loongOpen/OpenLoong-Hardware/QingLoong V2.5/en/QingLoong V2.5 - Electrical Drawings and Open Source Content Introduction/zh-Electrical Drawings.pdf

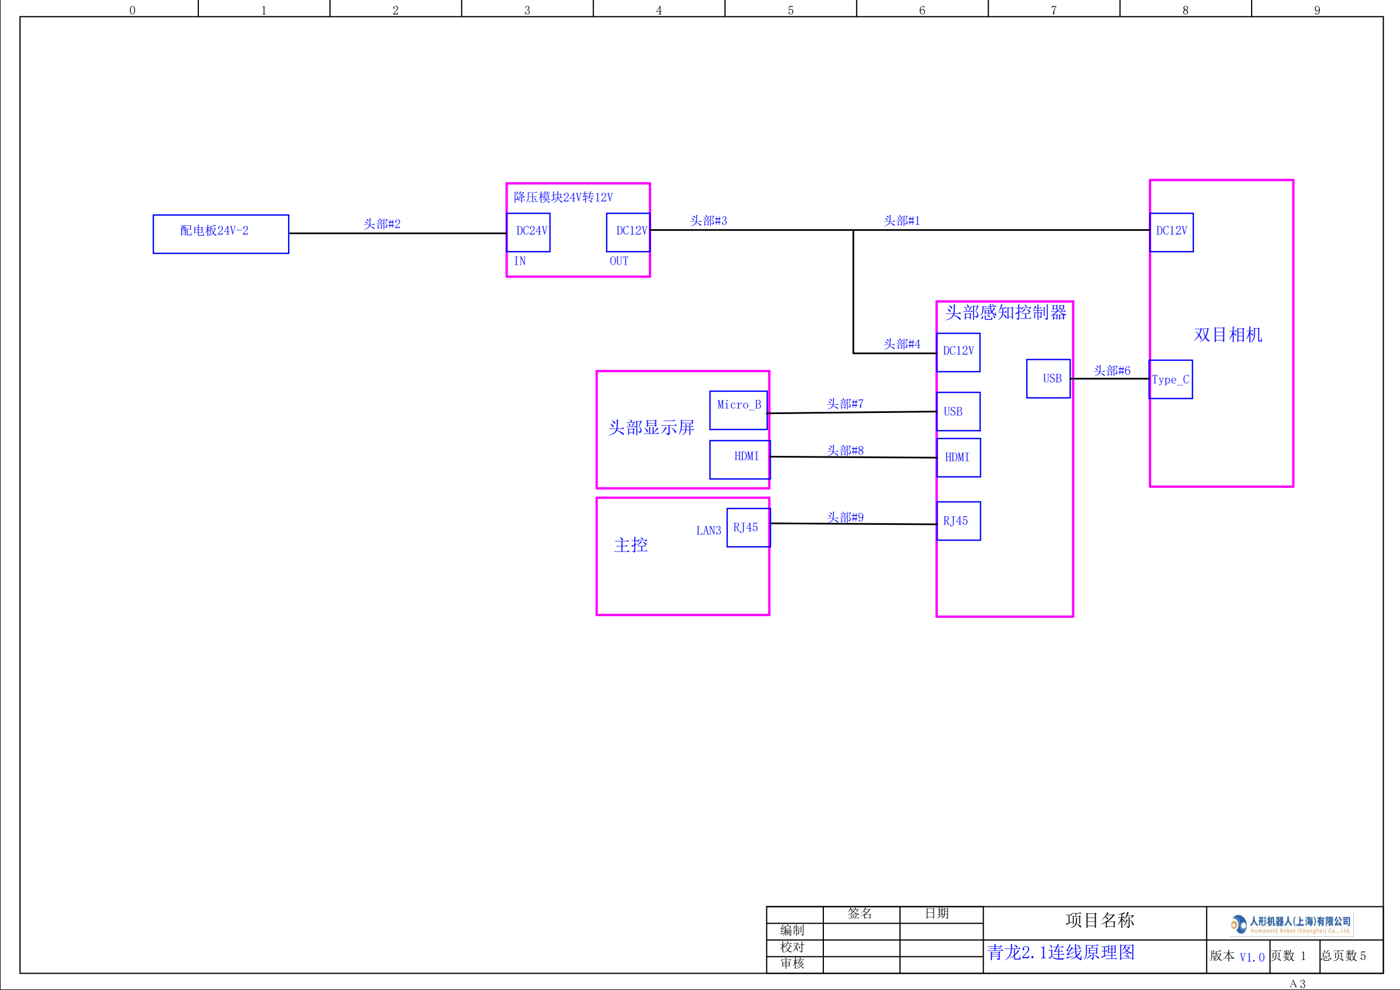
[picture p1: figure]
项目名称; 青龙2.1连线原理图; 总页数 5 审核; 降压模块24V转12V; OUT; 双目相机; 头部感知控制器; USB; HDMI; 头部显示屏; Micro_B; Type_C; 配电板24V-2; RJ45 LAN3

电池

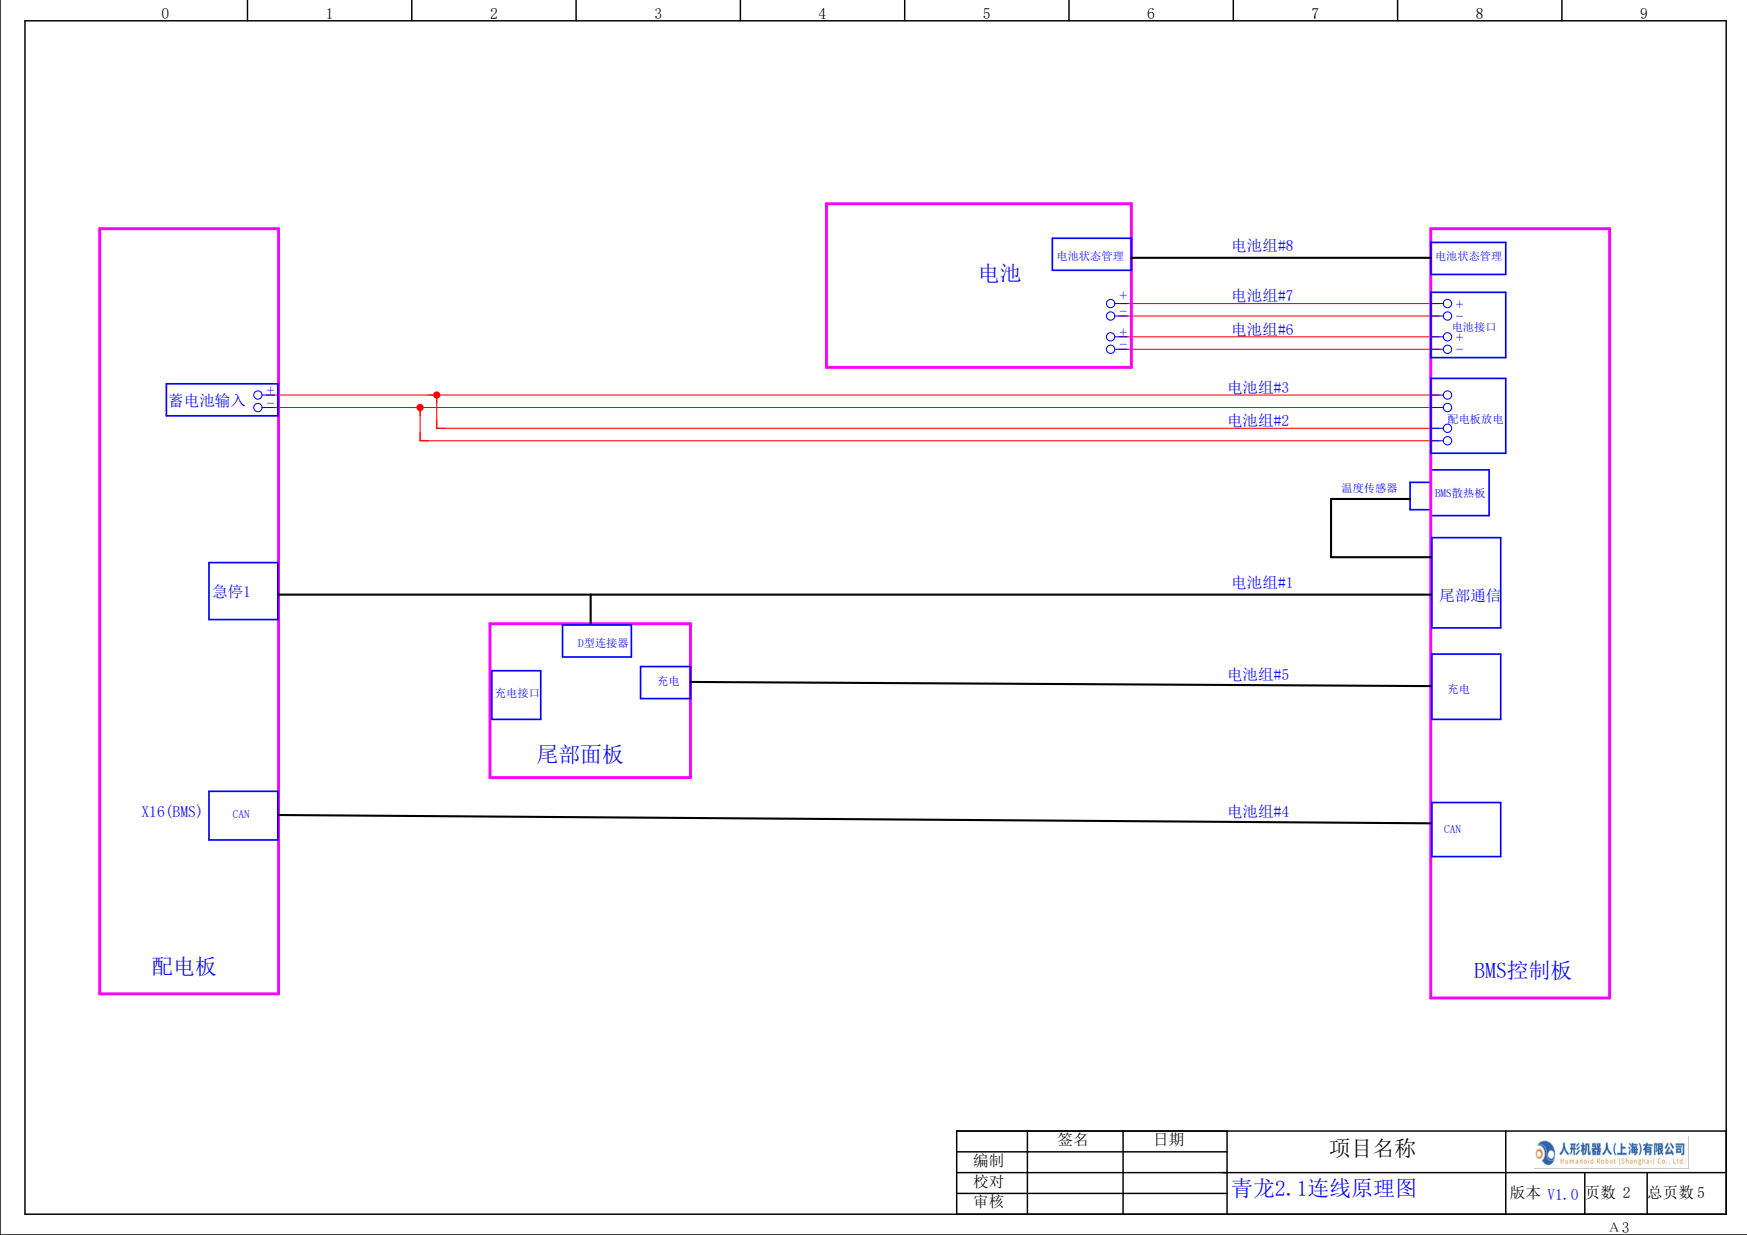
[picture p2: page 2]
配电板; + 蓄电池输入; X16(BMS); 尾部面板; 温度传感器; BMS散热板; D型连接器; BMS控制板; 尾部通信; CAN; 充电接口; 青龙2.1连线原理图; 电池接口; 电池状态管理; 配电板放电; 电池组#8; 电池组#7; 电池组#6; 电池组#5; 电池组#4; 电池组#3; 电池组#2; 电池组#1

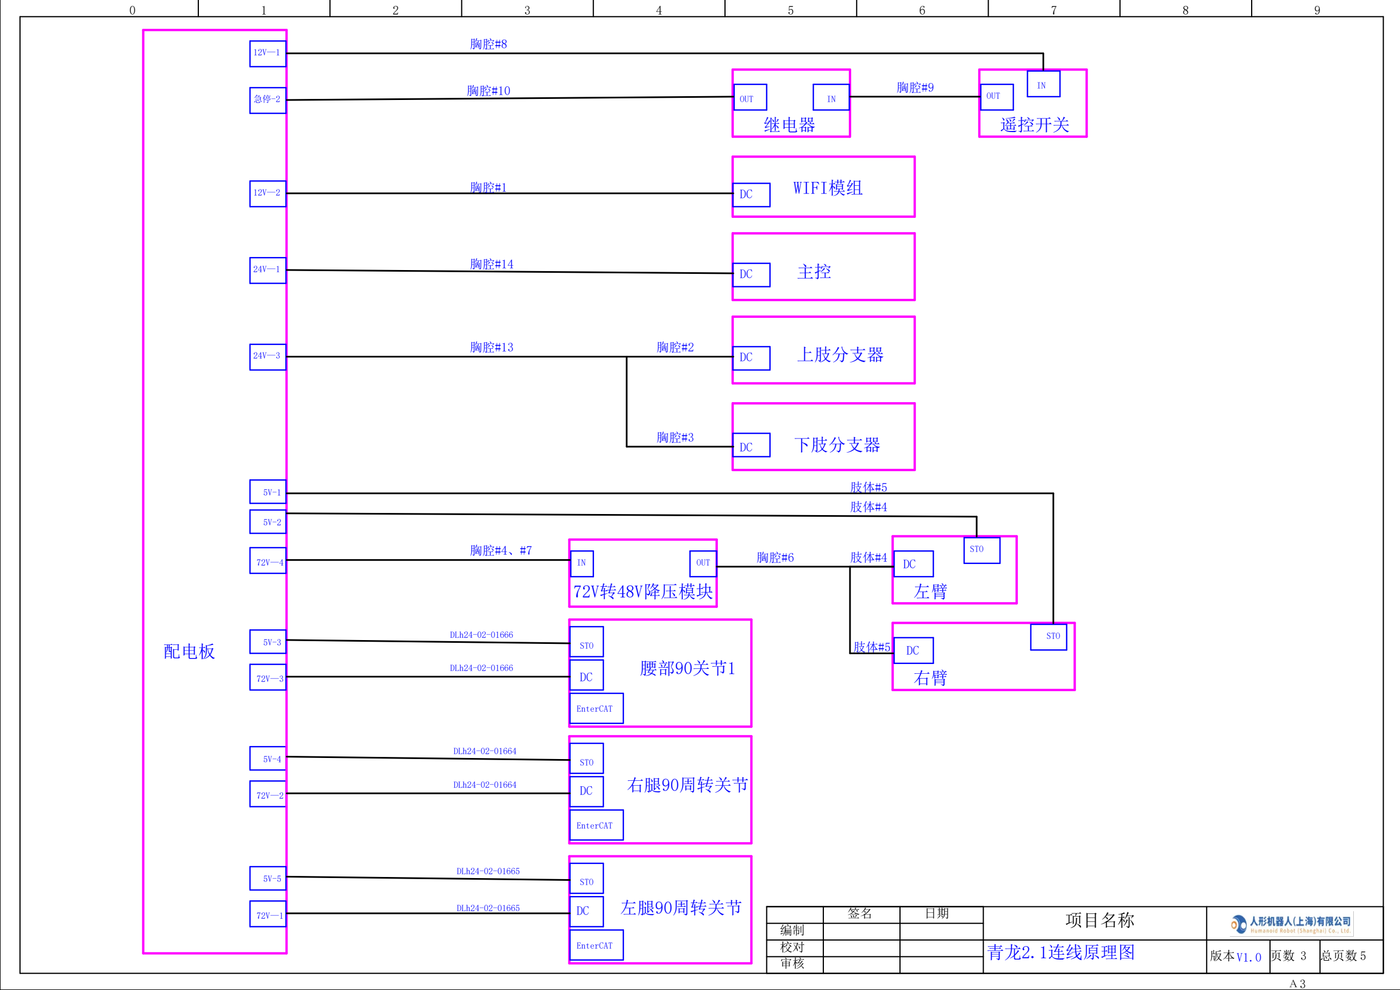
[picture p3: figure]
72V转48V降压模块; STO; 右腿90周转关节; 左腿90周转关节; OUT; EnterCAT; DLh24-02-01665; 配电板; STO 5V-3; STO 5V-5; WIFI模组; 上肢分支器; 下肢分支器; 继电器; 遥控开关; DLh24-02-01664; DLh24-02-01666

青龙2.1连线原理图 | 版本

主控

LAN1 RJ45

RJ45

RJ45

LAN8/网口2

LAN6/网口1

下肢分支器 | 上肢分支器
RJ45 | RJ45 | RJ45 | RJ45 | RJ45 | RJ45 | RJ45

## 左腿90周转关节

RJ45

## 右腿90周转关节

RJ45 | RJ45
左臂 | 右臂
LAN2 | RJ45
LAN3 | RJ45
X2 | X3 | X1 | X2 | X4 | X3

RJ45

## 腰部90关节1

RJ45

X6

RJ45

RJ45

RJ45

## 头部感知控制器

## 调试口

## WIFI模组

OUT

## 左腿90周转关节

## 左腿120侧展关节

DLh24-02-04004

## 左腿120前摆关节

DLh24-02-04003 | DLh24-02-04002
左腿120膝关节 | 左腿踝关节1

## 左腿踝关节2

DLh24-03-04131

DLh24-03-04131

DLh24-02-04004 | DLh24-02-04003 | DLh24-02-04002 | DLh24-03-03422

DLh24-03-03422

IN | OUT | IN | OUT | IN | OUT

IN

IN

## 右腿90周转关节

右腿120侧展关节 | 右腿120前摆关节 | 右腿120膝关节 | 右腿踝关节1

## 右腿踝关节2

OUT | OUT | OUT | OUT

IN

IN

IN | IN | IN
DLh24-02-04006 | DLh24-02-04005 | DLh24-02-01661

DLh24-02-01661

OUT | OUT | OUT

IN

IN

IN IN

## 腰部90关节1

腰部90关节2 | 腰部90关节3

## 头部70关节1

## 头部70关节2
