loongOpen/OpenLoong-Hardware/TA00-12-00-腿足系统-三维图纸/TA00-12-00-0003连杆销针C.step

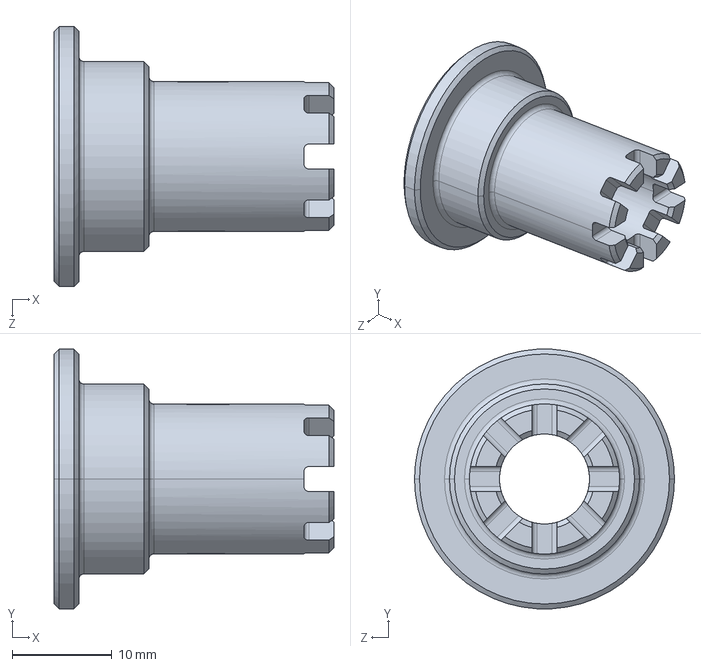
[picture p22: CAD file, 2025-07-11]
TA00-12-00-腿足系统-三维图纸/TA00-12-00-0003连杆销针C.step
28.0 x 26.0 x 26.0 mm
