loongOpen/OpenLoong-Hardware/TA00-12-00-腿足系统-三维图纸/TA00-12-06-0004足底端盖.step

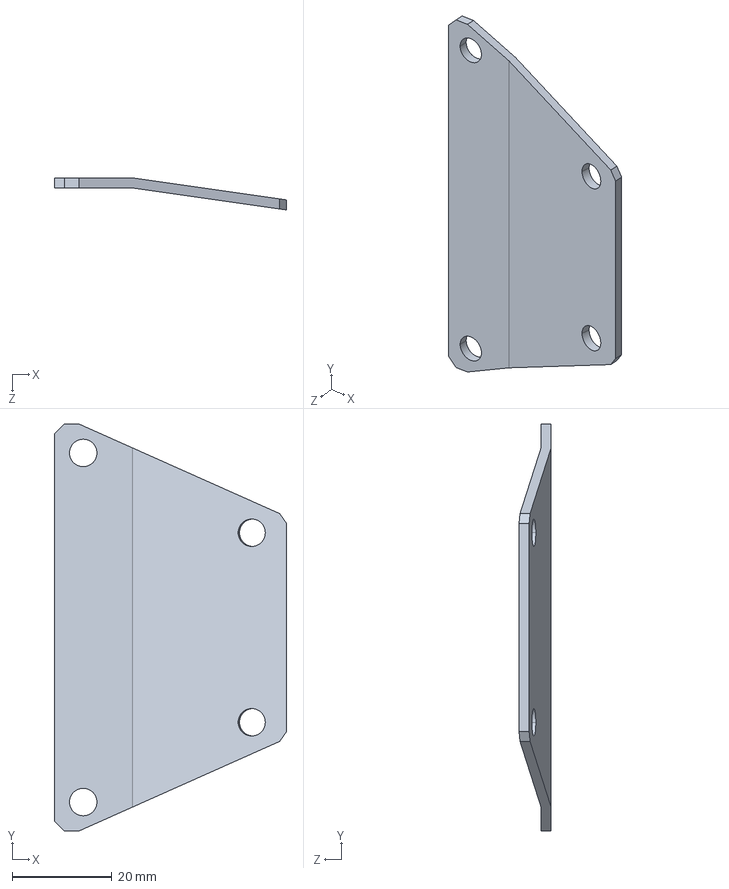
[picture p23: CAD file, 2025-07-11]
TA00-12-00-腿足系统-三维图纸/TA00-12-06-0004足底端盖.step
46.6 x 81.6 x 6.42 mm
