loongOpen/OpenLoong-Hardware/TA00-12-00-腿足系统-三维图纸/TA00-12-06-0003足底前橡胶垫.step

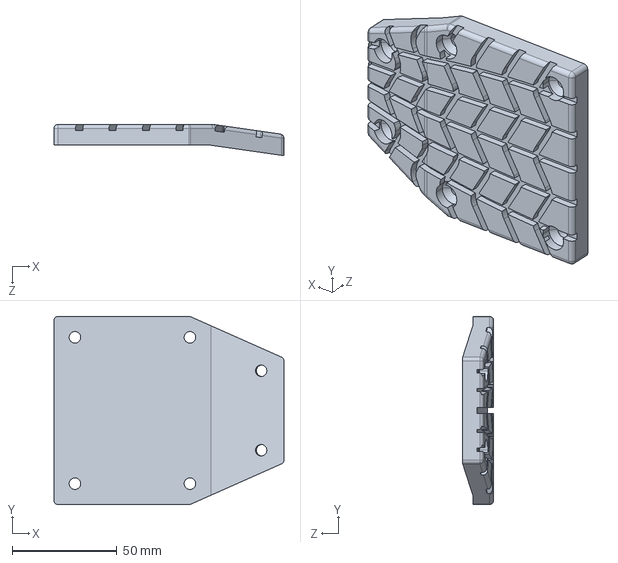
[picture p24: CAD file, 2025-07-11]
TA00-12-00-腿足系统-三维图纸/TA00-12-06-0003足底前橡胶垫.step
110.0 x 90.0 x 15.0 mm
