loongOpen/OpenLoong-Hardware/TA00-12-00-腿足系统-三维图纸/TA00-12-02-0007摇臂.step

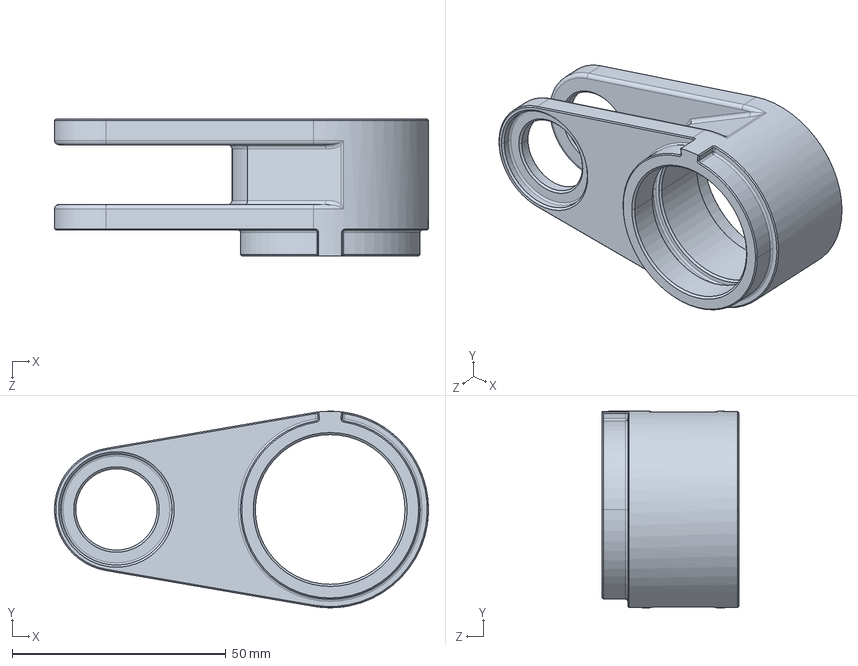
[picture p25: CAD file, 2025-07-11]
TA00-12-00-腿足系统-三维图纸/TA00-12-02-0007摇臂.step
87.5 x 46.0 x 32.0 mm
