loongOpen/OpenLoong-Hardware/TA00-12-00-腿足系统-三维图纸/TA00-12-02-0003右大腿支架.step

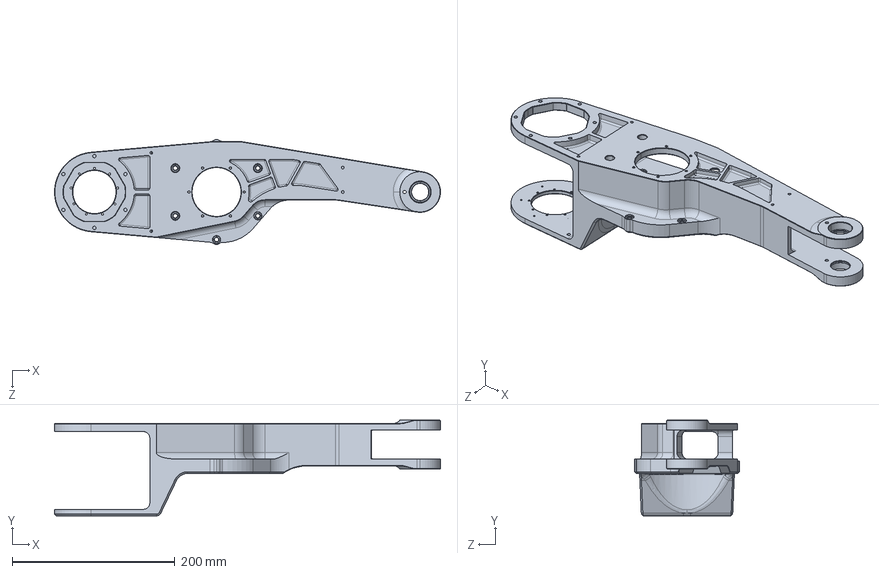
[picture p26: CAD file, 2025-07-11]
TA00-12-00-腿足系统-三维图纸/TA00-12-02-0003右大腿支架.step
474.0 x 117.5 x 129.0 mm
