loongOpen/OpenLoong-Hardware/TA00-12-00-腿足系统-三维图纸/TA00-12-04-0004小腿拉杆C.step

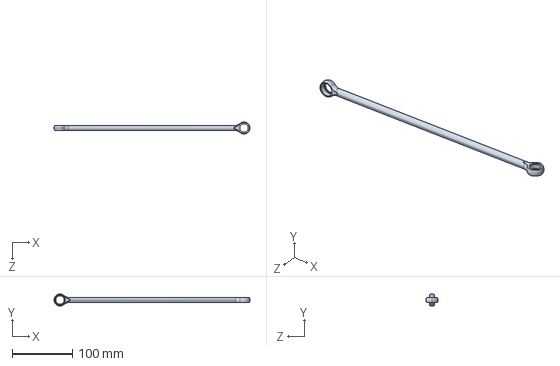
[picture p27: CAD file, 2025-07-11]
TA00-12-00-腿足系统-三维图纸/TA00-12-04-0004小腿拉杆C.step
325.0 x 20.0 x 20.0 mm
