loongOpen/OpenLoong-Hardware/TA00-12-00-腿足系统-三维图纸/TA00-12-02-0002俯仰电机支撑架.step

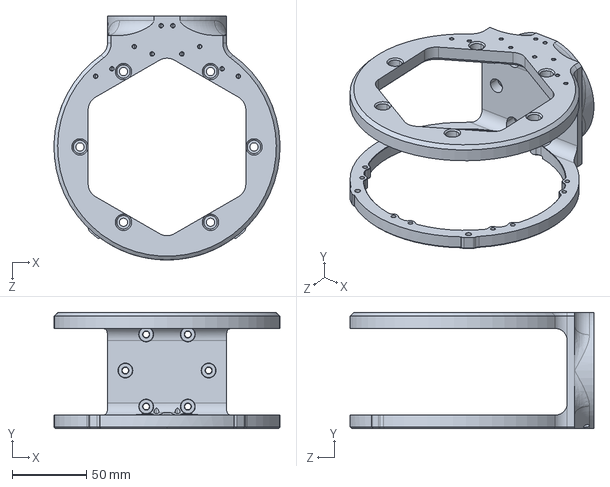
[picture p28: CAD file, 2025-07-11]
TA00-12-00-腿足系统-三维图纸/TA00-12-02-0002俯仰电机支撑架.step
151.9 x 78.0 x 164.0 mm
