loongOpen/OpenLoong-Hardware/TA00-12-00-腿足系统-三维图纸/TA00-12-02-0010连杆.step

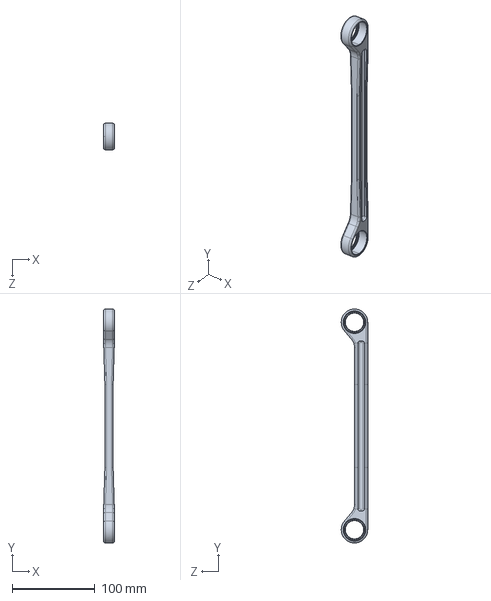
[picture p29: CAD file, 2025-07-11]
TA00-12-00-腿足系统-三维图纸/TA00-12-02-0010连杆.step
13.0 x 282.0 x 32.0 mm
