loongOpen/OpenLoong-Hardware/TA00-12-00-腿足系统-三维图纸/TA00-12-00-0001膝关节销轴.step

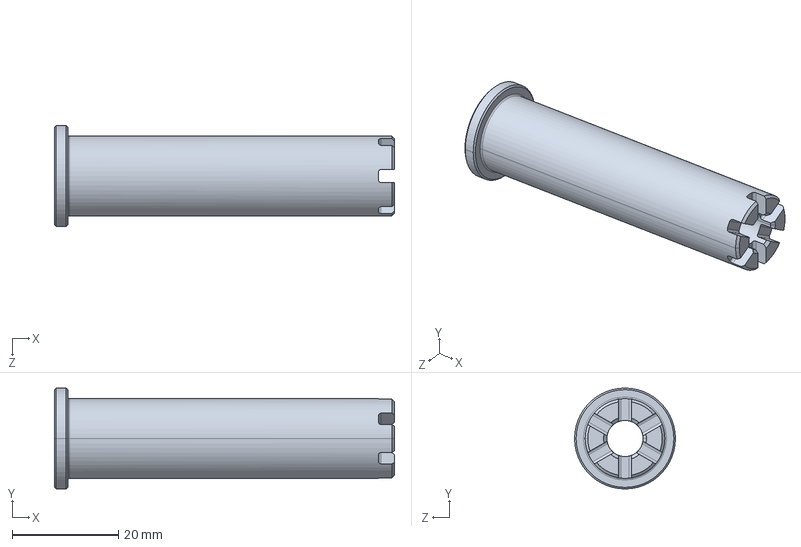
[picture p30: CAD file, 2025-07-11]
TA00-12-00-腿足系统-三维图纸/TA00-12-00-0001膝关节销轴.step
64.0 x 19.0 x 19.0 mm
