loongOpen/OpenLoong-Hardware/TA00-12-00-腿足系统-三维图纸/TA00-12-00-0018膝关节轴承垫片.step

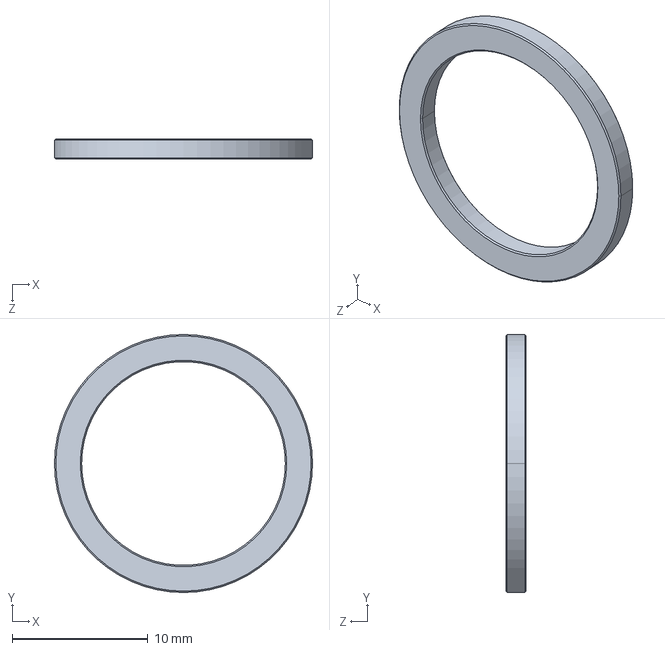
[picture p31: CAD file, 2025-07-11]
TA00-12-00-腿足系统-三维图纸/TA00-12-00-0018膝关节轴承垫片.step
19.0 x 19.0 x 1.50 mm
