loongOpen/OpenLoong-Hardware/TA00-12-00-腿足系统-三维图纸/TA00-12-04-0001右小腿支架.step

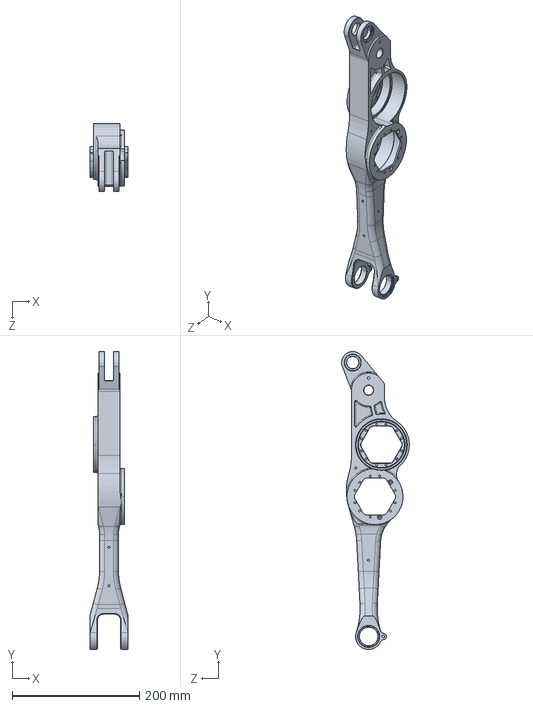
[picture p32: CAD file, 2025-07-11]
TA00-12-00-腿足系统-三维图纸/TA00-12-04-0001右小腿支架.step
60.5 x 468.3 x 106.5 mm
