loongOpen/OpenLoong-Hardware/TA00-12-00-腿足系统-三维图纸/TA00-12-02-0006轴承钢套.step

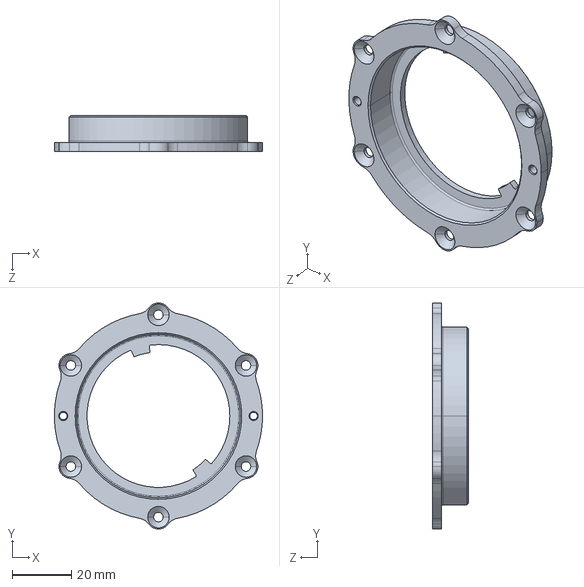
[picture p33: CAD file, 2025-07-11]
TA00-12-00-腿足系统-三维图纸/TA00-12-02-0006轴承钢套.step
70.0 x 76.0 x 12.0 mm
