loongOpen/OpenLoong-Hardware/TA00-12-00-腿足系统-三维图纸/TA00-12-06-0001足本体.step

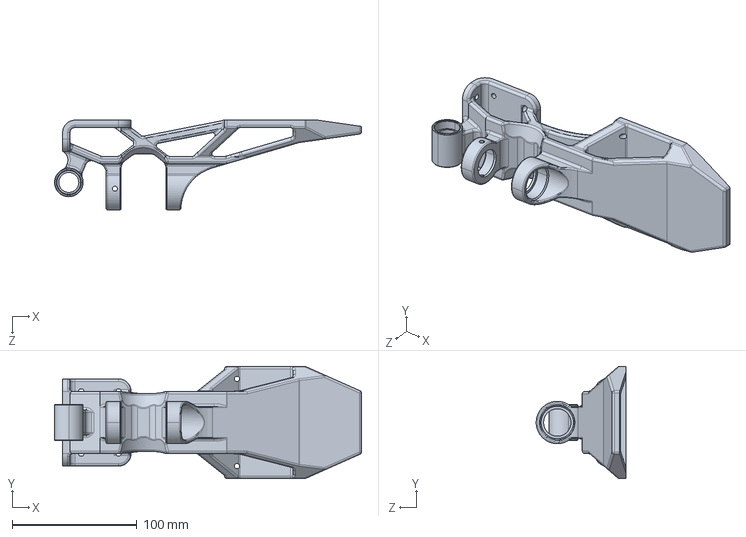
[picture p34: CAD file, 2025-07-11]
TA00-12-00-腿足系统-三维图纸/TA00-12-06-0001足本体.step
246.5 x 90.0 x 72.0 mm
