loongOpen/OpenLoong-Hardware/TA00-12-00-腿足系统-三维图纸/TA00-12-02-0005轴承锁紧螺母.step

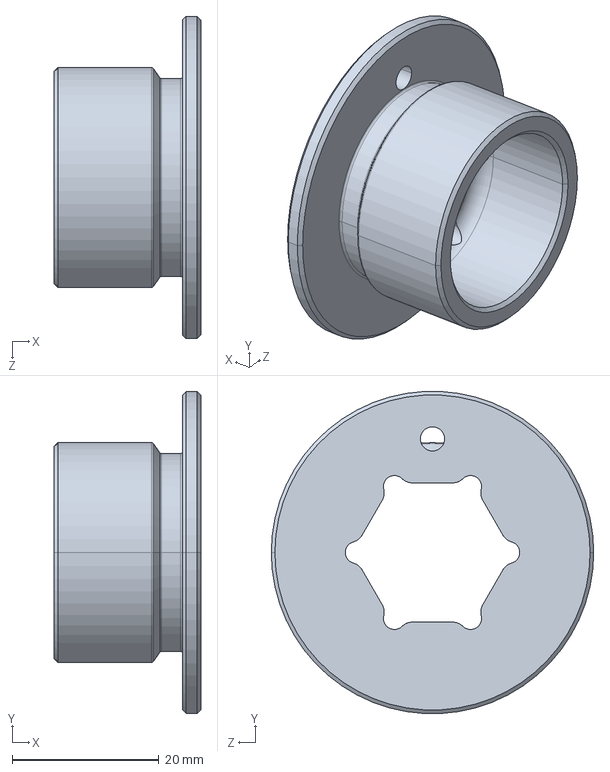
[picture p35: CAD file, 2025-07-11]
TA00-12-00-腿足系统-三维图纸/TA00-12-02-0005轴承锁紧螺母.step
20.0 x 43.9 x 44.0 mm
