loongOpen/OpenLoong-Hardware/TA00-12-00-腿足系统-三维图纸/TA00-12-02-0009连杆锁紧螺钉B.step

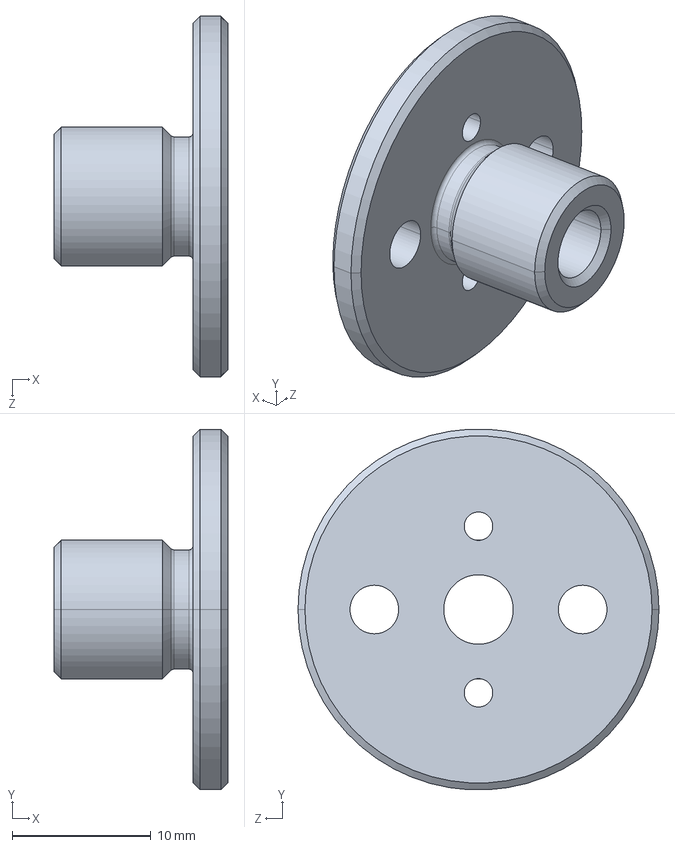
[picture p36: CAD file, 2025-07-11]
TA00-12-00-腿足系统-三维图纸/TA00-12-02-0009连杆锁紧螺钉B.step
12.5 x 26.0 x 26.0 mm
