loongOpen/OpenLoong-Hardware/TA00-12-00-腿足系统-三维图纸/TA00-12-04-0006右小腿上限位.step

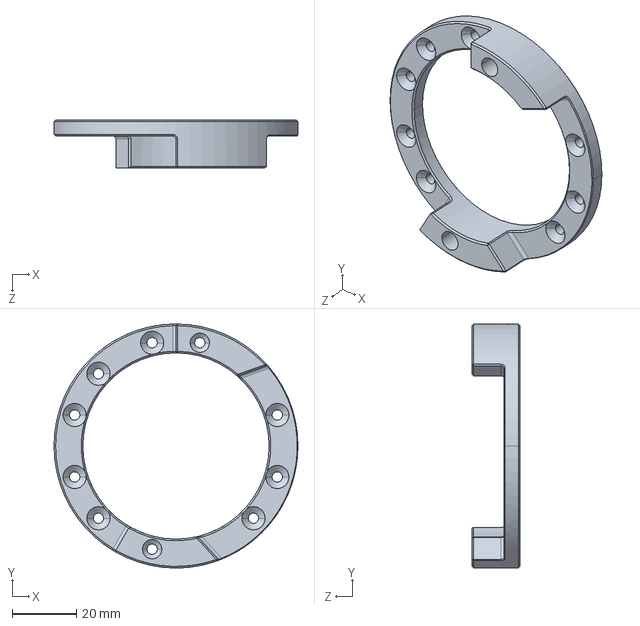
[picture p37: CAD file, 2025-07-11]
TA00-12-00-腿足系统-三维图纸/TA00-12-04-0006右小腿上限位.step
76.0 x 76.0 x 15.0 mm
