loongOpen/OpenLoong-Hardware/TA00-12-00-腿足系统-三维图纸/TA00-12-00-0007脚踝俯仰轴 B.step

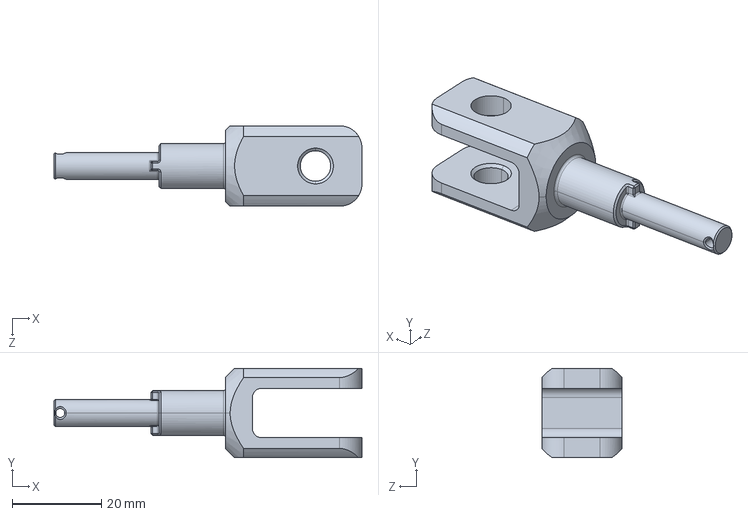
[picture p38: CAD file, 2025-07-11]
TA00-12-00-腿足系统-三维图纸/TA00-12-00-0007脚踝俯仰轴 B.step
68.9 x 20.0 x 18.0 mm
