loongOpen/OpenLoong-Hardware/TA00-12-00-腿足系统-三维图纸/TA00-12-00-0015十字侧摆轴衬套.step

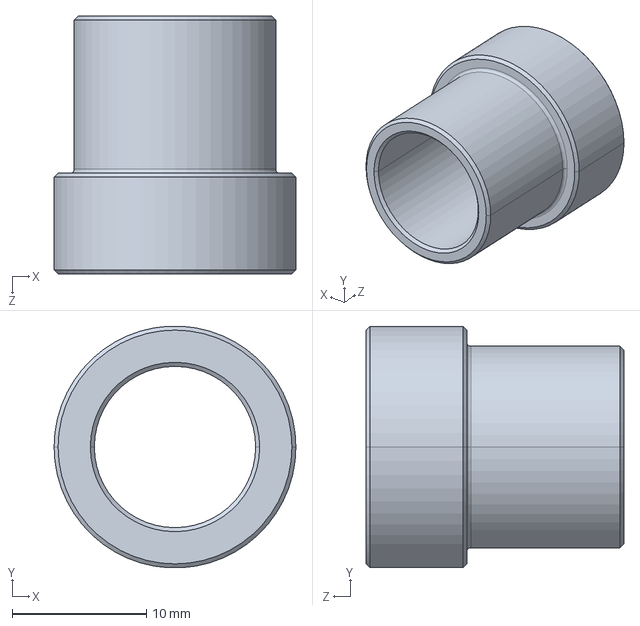
[picture p39: CAD file, 2025-07-11]
TA00-12-00-腿足系统-三维图纸/TA00-12-00-0015十字侧摆轴衬套.step
18.0 x 18.0 x 19.2 mm
