loongOpen/OpenLoong-Hardware/TA00-12-00-腿足系统-三维图纸/TA00-12-00-0017十字俯仰轴关节衬套.step

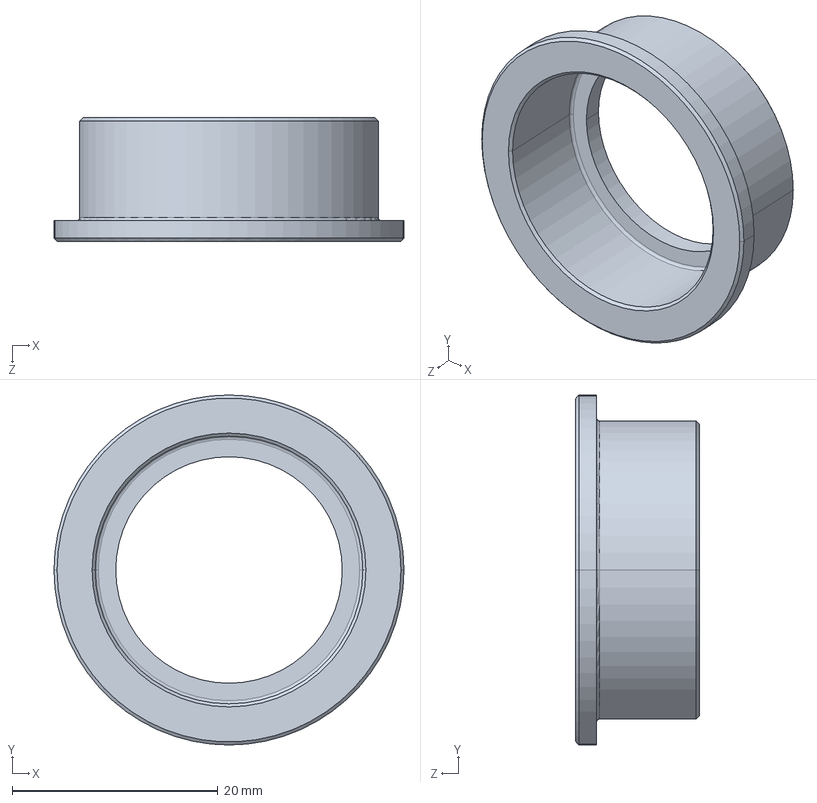
[picture p40: CAD file, 2025-07-11]
TA00-12-00-腿足系统-三维图纸/TA00-12-00-0017十字俯仰轴关节衬套.step
34.0 x 34.0 x 12.0 mm
