loongOpen/OpenLoong-Hardware/TA00-12-00-腿足系统-三维图纸/TA00-12-02-0015髋关节俯仰限位块.step

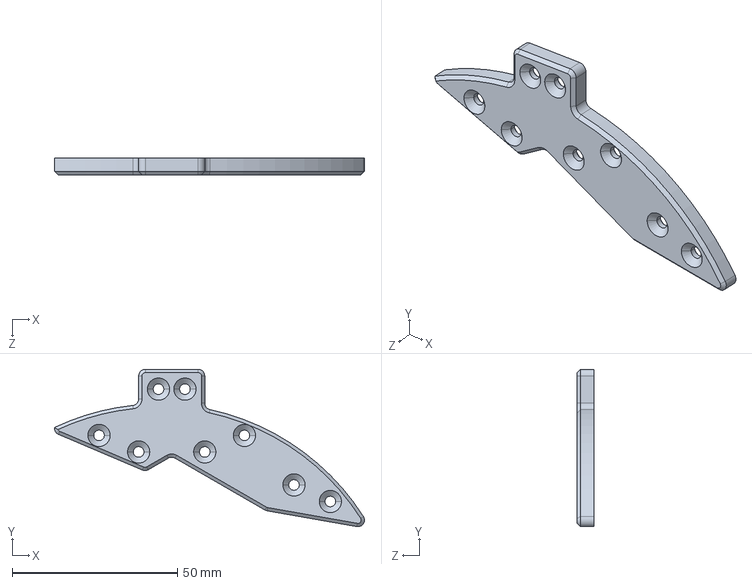
[picture p41: CAD file, 2025-07-11]
TA00-12-00-腿足系统-三维图纸/TA00-12-02-0015髋关节俯仰限位块.step
93.8 x 47.6 x 5.00 mm
