loongOpen/OpenLoong-Hardware/TA00-12-00-腿足系统-三维图纸/TA00-12-00-0013十字俯仰轴.step

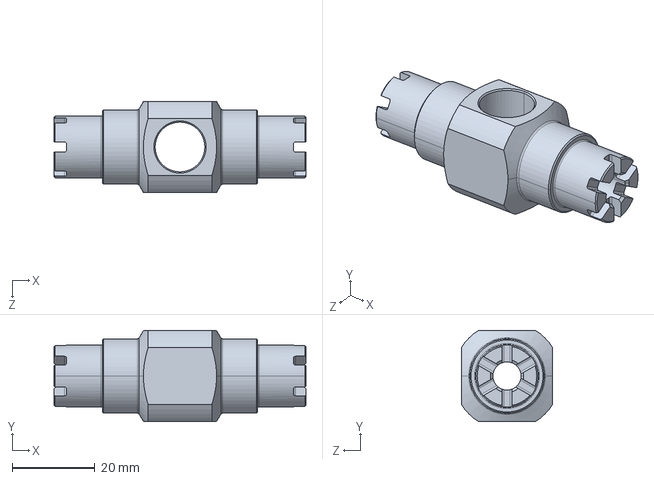
[picture p42: CAD file, 2025-07-11]
TA00-12-00-腿足系统-三维图纸/TA00-12-00-0013十字俯仰轴.step
60.9 x 22.0 x 22.0 mm
