loongOpen/OpenLoong-Hardware/TA00-12-00-腿足系统-三维图纸/TA00-12-04-0002-A1小腿曲柄.step

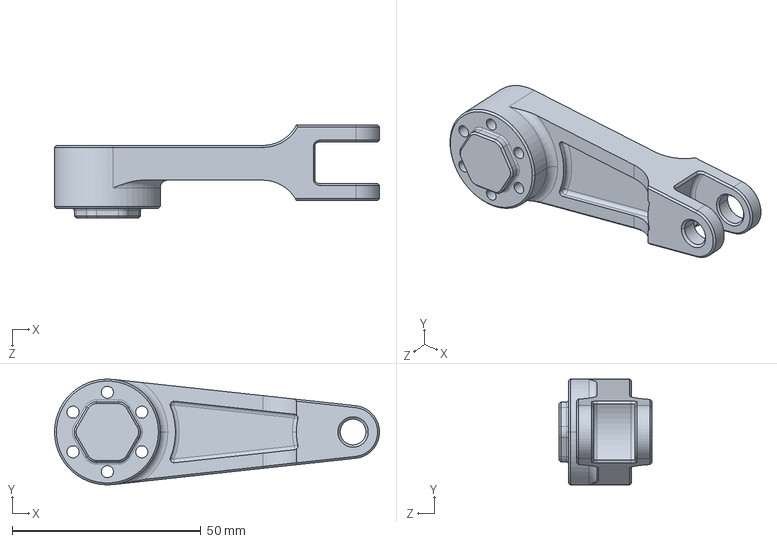
[picture p43: CAD file, 2025-07-11]
TA00-12-00-腿足系统-三维图纸/TA00-12-04-0002-A1小腿曲柄.step
86.0 x 28.0 x 24.6 mm
