loongOpen/OpenLoong-Hardware/TA00-12-00-腿足系统-三维图纸/TA00-12-00-0014十字侧摆轴.step

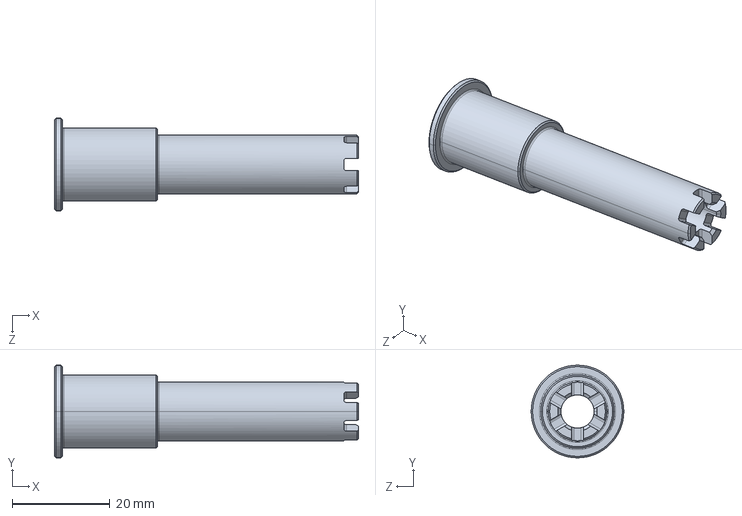
[picture p44: CAD file, 2025-07-11]
TA00-12-00-腿足系统-三维图纸/TA00-12-00-0014十字侧摆轴.step
62.3 x 19.0 x 19.0 mm
