loongOpen/OpenLoong-Hardware/TA00-12-00-腿足系统-三维图纸/TA00-12-00-0002膝关节销轴锁紧螺钉.step

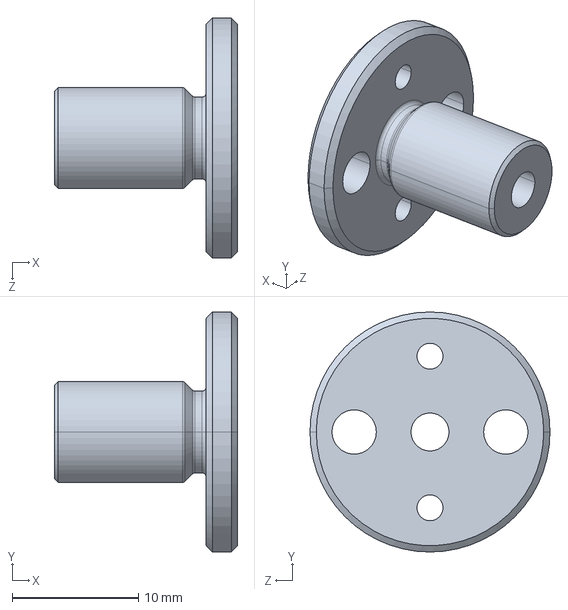
[picture p45: CAD file, 2025-07-11]
TA00-12-00-腿足系统-三维图纸/TA00-12-00-0002膝关节销轴锁紧螺钉.step
14.5 x 19.0 x 19.0 mm
