loongOpen/OpenLoong-Hardware/TA00-12-00-腿足系统-三维图纸/TA00-12-00-0016踝关节锁紧螺钉.step

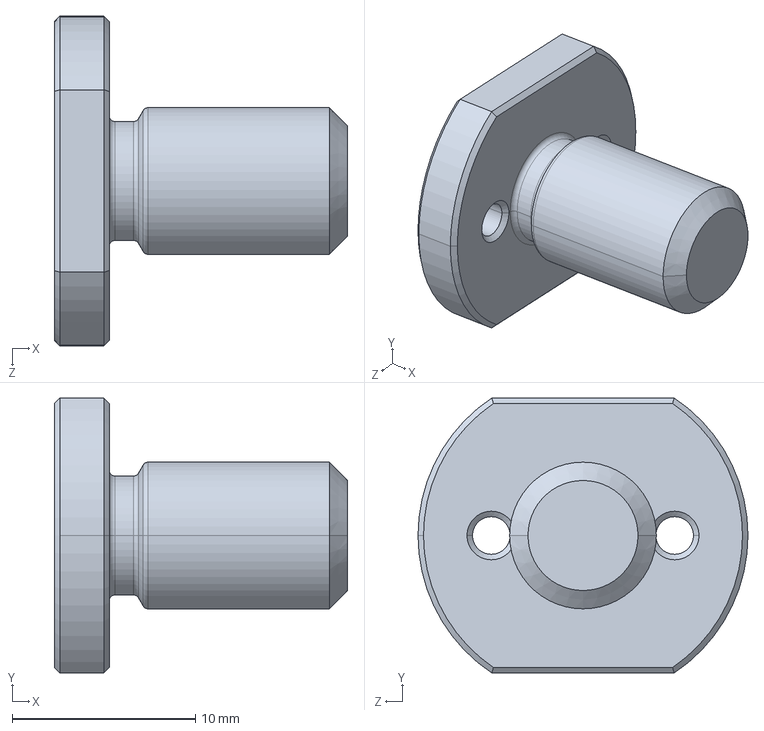
[picture p46: CAD file, 2025-07-11]
TA00-12-00-腿足系统-三维图纸/TA00-12-00-0016踝关节锁紧螺钉.step
16.0 x 15.0 x 18.0 mm
