loongOpen/OpenLoong-Hardware/TA00-12-00-腿足系统-三维图纸/TA00-12-04-0003小腿拉杆A.step

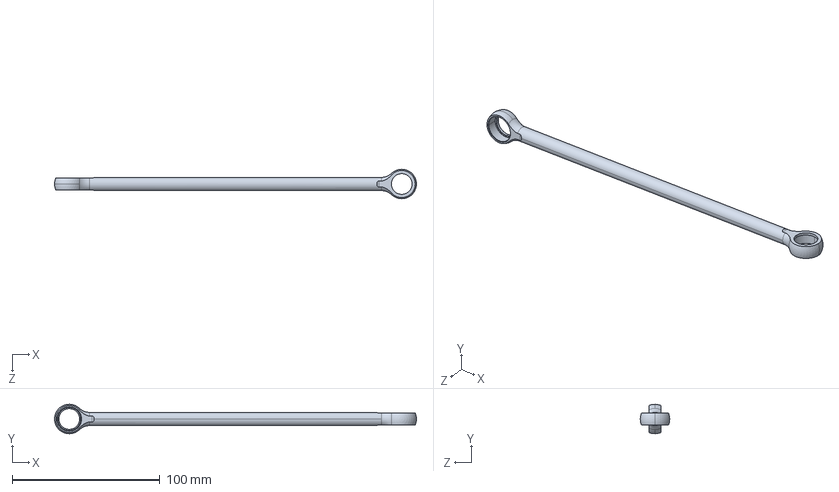
[picture p47: CAD file, 2025-07-11]
TA00-12-00-腿足系统-三维图纸/TA00-12-04-0003小腿拉杆A.step
245.0 x 20.0 x 20.0 mm
