loongOpen/OpenLoong-Hardware/TA00-12-00-腿足系统-三维图纸/TA00-12-02-0008连杆销针.step

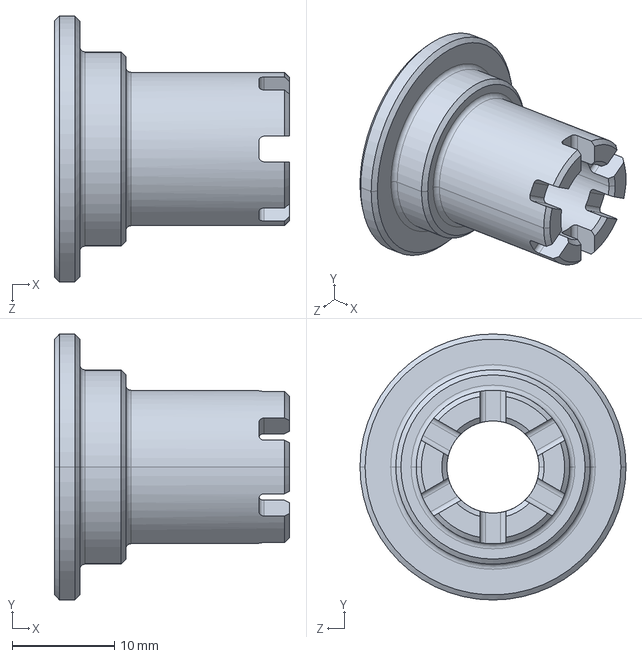
[picture p48: CAD file, 2025-07-11]
TA00-12-00-腿足系统-三维图纸/TA00-12-02-0008连杆销针.step
23.0 x 26.0 x 26.0 mm
