loongOpen/OpenLoong-Hardware/TA00-12-00-腿足系统-三维图纸/TA00-12-00-0004连杆衬套B.step

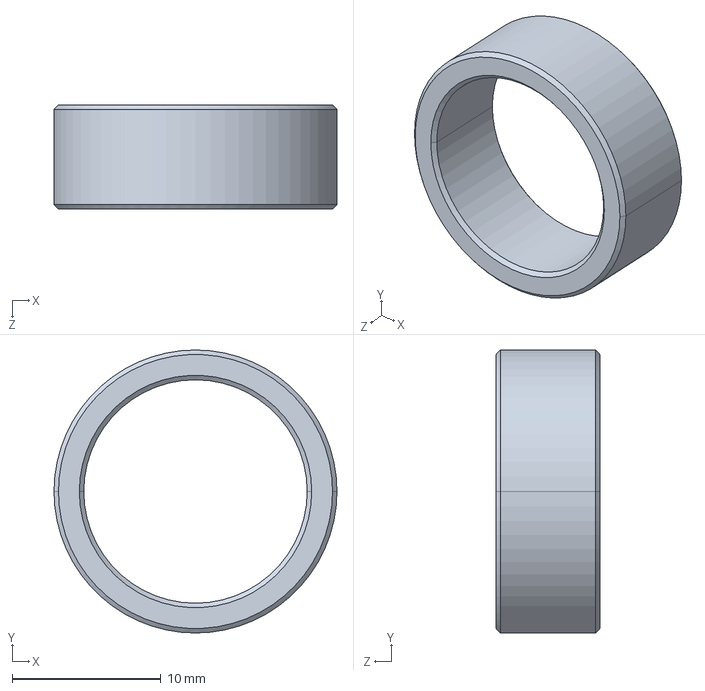
[picture p50: CAD file, 2025-07-11]
TA00-12-00-腿足系统-三维图纸/TA00-12-00-0004连杆衬套B.step
19.0 x 19.0 x 7.00 mm
