loongOpen/OpenLoong-Hardware/TA00-12-00-腿足系统-三维图纸/TA00-12-00-0006脚踝俯仰轴.step

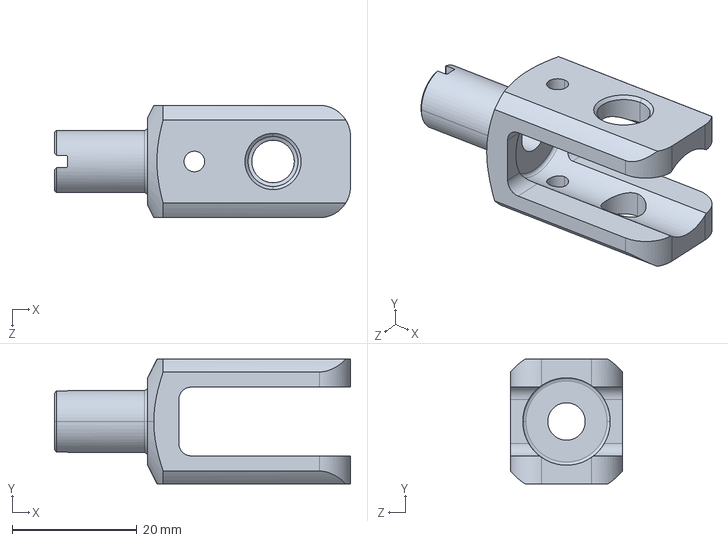
[picture p51: CAD file, 2025-07-11]
TA00-12-00-腿足系统-三维图纸/TA00-12-00-0006脚踝俯仰轴.step
47.4 x 20.0 x 18.0 mm
