loongOpen/OpenLoong-Hardware/TA00-12-00-腿足系统-三维图纸/TA00-12-02-0004膝关节电机关节轴.step

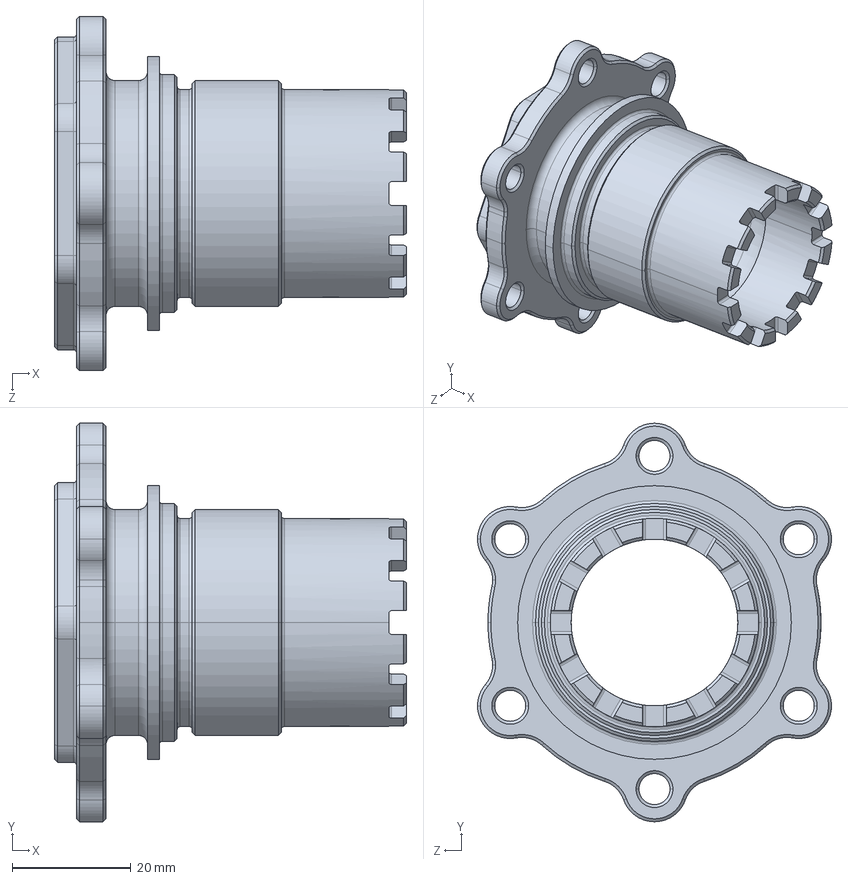
[picture p52: CAD file, 2025-07-11]
TA00-12-00-腿足系统-三维图纸/TA00-12-02-0004膝关节电机关节轴.step
59.2 x 67.0 x 59.5 mm
