loongOpen/OpenLoong-Hardware/TA00-12-00-腿足系统-三维图纸/TA00-12-02-0012支撑轴B.step

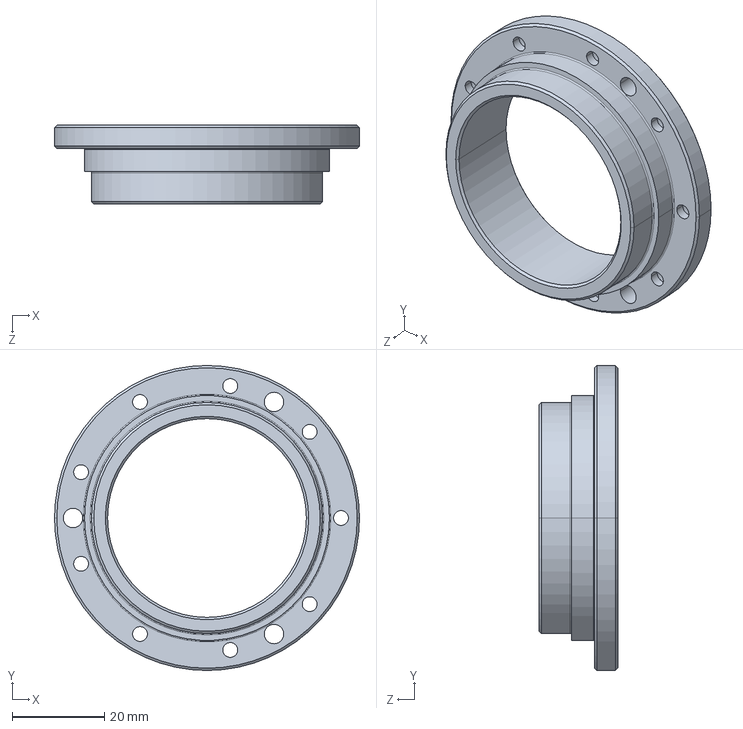
[picture p53: CAD file, 2025-07-11]
TA00-12-00-腿足系统-三维图纸/TA00-12-02-0012支撑轴B.step
66.0 x 66.0 x 17.0 mm
