loongOpen/OpenLoong-Hardware/TA00-12-00-腿足系统-三维图纸/TA00-12-02-0001髋关节俯仰电机法兰.step

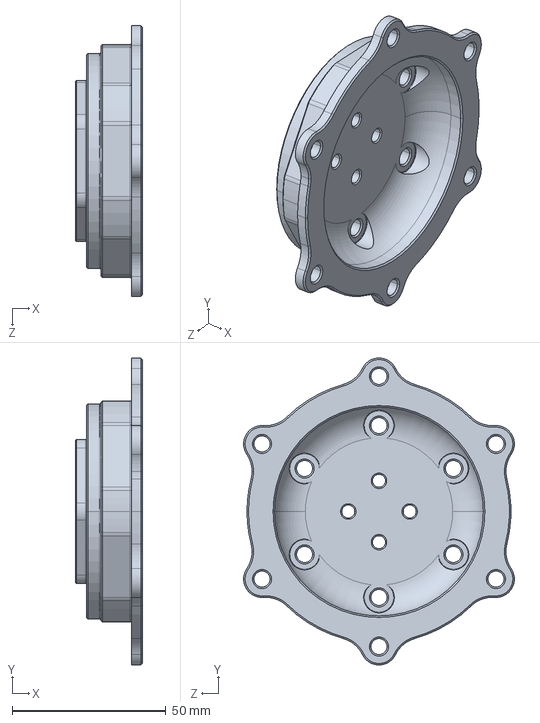
[picture p55: CAD file, 2025-07-11]
TA00-12-00-腿足系统-三维图纸/TA00-12-02-0001髋关节俯仰电机法兰.step
21.8 x 100.0 x 88.2 mm
