loongOpen/OpenLoong-Hardware/TA00-12-00-腿足系统-三维图纸/TA00-12-00-0011脚踝俯仰轴垫片.step

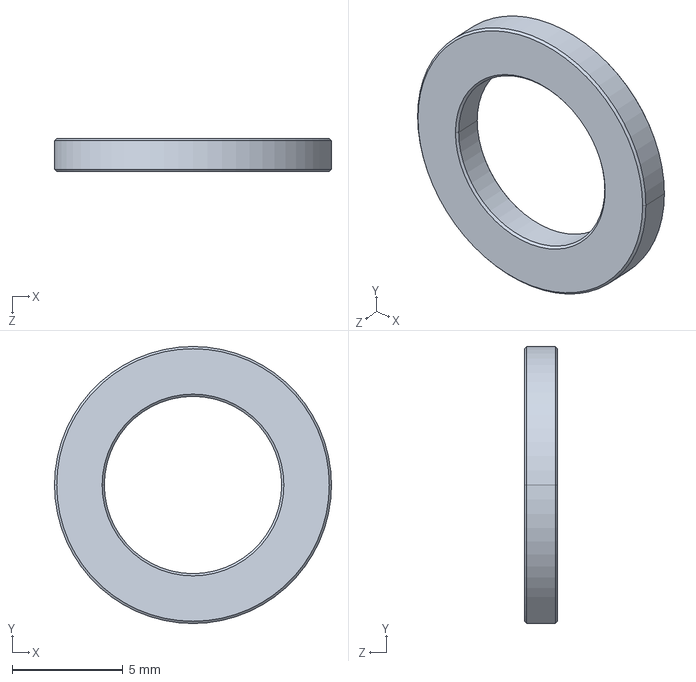
[picture p56: CAD file, 2025-07-11]
TA00-12-00-腿足系统-三维图纸/TA00-12-00-0011脚踝俯仰轴垫片.step
12.5 x 12.5 x 1.50 mm
