loongOpen/OpenLoong-Hardware/TA00-12-00-腿足系统-三维图纸/TA00-12-06-0002足底后橡胶垫.step

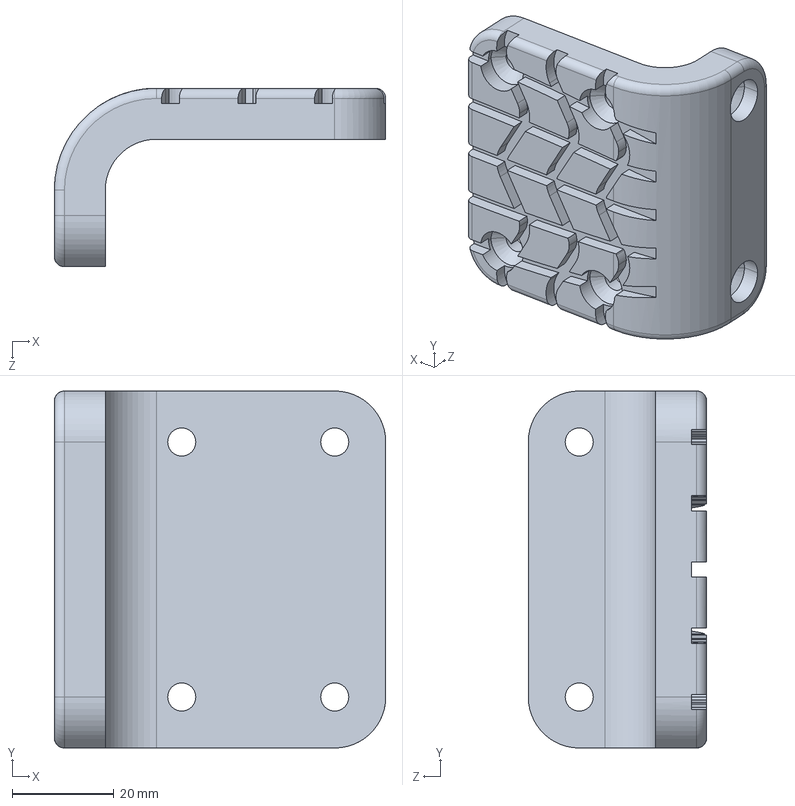
[picture p57: CAD file, 2025-07-11]
TA00-12-00-腿足系统-三维图纸/TA00-12-06-0002足底后橡胶垫.step
65.0 x 70.0 x 35.0 mm
