loongOpen/OpenLoong-Hardware/(list of files, cad)

Other CAD files:
QingLoong V2.5/en/QingLoong V2.5 - 3D File/TA00-04-00-Chest System - 3D File/TA00-04-03-0004 Main Controller Fixing Plate.step
QingLoong V2.5/en/QingLoong V2.5 - 3D File/TA00-Assemblies of Modules - 3D File/TA00-07 Head Assembly.STEP
QingLoong V2.5/en/QingLoong V2.5 - 3D File/TA00-Assemblies of Modules - 3D File/TA00-Qinglong Humanoid Robot - Master Assembly.STEP
QingLoong V2.5/en/QingLoong V2.5 - 3D File/TA00-Assemblies of Modules - 3D File/TA00-03 Waist Bracket Assembly.STEP
QingLoong V2.5/en/QingLoong V2.5 - 3D File/TA00-Assemblies of Modules - 3D File/TA00-12-00 Leg System (Fully Cased).STEP
QingLoong V2.5/en/QingLoong V2.5 - 3D File/TA00-07-00-Head Perception System - 3D File/TA00-07-01-0005 Rear Assembly Plate V2.5.step
QingLoong V2.5/en/QingLoong V2.5 - 3D File/TA00-07-00-Head Perception System - 3D File/TA00-07-01-0004 Front Assembly Plate V2.5.step
QingLoong V2.5/en/QingLoong V2.5 - 3D File/TA00-03-00-Waist Component - 3D File/TA00-04-01-01-0002-Waist Adapter Plate 105311.STEP
QingLoong V2.5/en/QingLoong V2.5 - 3D File/TA00-04-00-Chest System - 3D File/TA00-04-03-0001 Head Mounting Base.step
QingLoong V2.5/en/QingLoong V2.5 - 3D File/TA00-07-00-Head Perception System - 3D File/TA00-07-01-0007 Side Support V2.5.step
QingLoong V2.5/en/QingLoong V2.5 - 3D File/TA00-12-00-Leg and Foot System - 3D File/TA00-12-04-0006 Right Calf Upper Limit.step
QingLoong V2.5/en/QingLoong V2.5 - 3D File/TA00-Assemblies of Modules - 3D File/TA00-04-00 Thoracic Section (Cased).STEP
QingLoong V2.5/en/QingLoong V2.5 - 3D File/TA00-03-00-Waist Component - 3D File/TA00-03-0006-Side Swing Motor Bracket1.STEP
QingLoong V2.5/en/QingLoong V2.5 - 3D File/TA00-07-00-Head Perception System - 3D File/TA00-07-01-0017 Camera Mount (Right) V2.5.step
QingLoong V2.5/en/QingLoong V2.5 - 3D File/TA00-12-00-Leg and Foot System - 3D File/TA00-12-04-0001 Right Calf Bracket.step
QingLoong V2.5/en/QingLoong V2.5 - 3D File/TA00-Assemblies of Modules - 3D File/TA00-12-00 Leg System (Uncased).STEP
QingLoong V2.5/en/QingLoong V2.5 - 3D File/TA00-03-00-Waist Component - 3D File/TA00-03-0012-Waist Pitch Support Rotating Shaft1.STEP
QingLoong V2.5/en/QingLoong V2.5 - 3D File/TA00-04-00-Chest System - 3D File/TA00-04-03-0005 WIFI Module Heat Sink Plate.step
QingLoong V2.5/en/QingLoong V2.5 - 3D File/TA00-07-00-Head Perception System - 3D File/TA00-07-01-0008 Side Support 2 V2.5.step
QingLoong V2.5/en/QingLoong V2.5 - 3D File/TA00-03-00-Waist Component - 3D File/TA00-03-0001-Waist Bracket1.STEP
QingLoong V2.5/en/QingLoong V2.5 - 3D File/TA00-04-00-Chest System - 3D File/TA00-04-01-01-0002 Waist Adapter Plate 1105310604.step
QingLoong V2.5/en/QingLoong V2.5 - 3D File/TA00-07-00-Head Perception System - 3D File/TA00-07-01-0012 Binocular Camera Bracket V2.5.step
QingLoong V2.5/en/QingLoong V2.5 - 3D File/TA00-03-00-Waist Component - 3D File/TA00-03-0011-Waist Pitch Bearing Retaining Ring1.STEP
QingLoong V2.5/en/QingLoong V2.5 - 3D File/TA00-04-00-Chest System - 3D File/TA00-04-02-0001 Top Fixing Plate.step
QingLoong V2.5/en/QingLoong V2.5 - 3D File/TA00-07-00-Head Perception System - 3D File/TA00-07-01-0009 Rotation Output Structural Component V2.5.step
QingLoong V2.5/en/QingLoong V2.5 - 3D File/TA00-12-00-Leg and Foot System - 3D File/TA00-12-02-0002 Pitch Motor Support Bracket.step
QingLoong V2.5/en/QingLoong V2.5 - 3D File/TA00-03-00-Waist Component - 3D File/TA00-03-0002-Front Blind-Spot Camera Bracket1.STEP
QingLoong V2.5/en/QingLoong V2.5 - 3D File/TA00-04-00-Chest System - 3D File/TA00-04-03-0007 LiDAR Fixing Bracket.step
QingLoong V2.5/en/QingLoong V2.5 - 3D File/TA00-07-00-Head Perception System - 3D File/TA00-07-01-0002 Perception Head Window V2.5.step
QingLoong V2.5/en/QingLoong V2.5 - 3D File/TA00-12-00-Leg and Foot System - 3D File/TA00-12-00-0001 Knee Joint Pin Shaft.step
QingLoong V2.5/en/QingLoong V2.5 - 3D File/TA00-Assemblies of Modules - 3D File/TA00-04-00 Thoracic Section (Uncased).STEP
QingLoong V2.5/en/QingLoong V2.5 - 3D File/TA00-03-00-Waist Component - 3D File/TA00-03-0009-Waist Side Swing Bearing Retaining Ring1.STEP
QingLoong V2.5/en/QingLoong V2.5 - 3D File/TA00-04-00-Chest System - 3D File/TA00-04-02-0004 Rear Mounting Side Plate (Mirrored).step
QingLoong V2.5/en/QingLoong V2.5 - 3D File/TA00-07-00-Head Perception System - 3D File/TA00-07-01-0013 Pitch Cantilever Structural Component V2.5.step
QingLoong V2.5/en/QingLoong V2.5 - 3D File/TA00-12-00-Leg and Foot System - 3D File/TA00-12-02-0006 Bearing Steel Sleeve.step
QingLoong V2.5/en/QingLoong V2.5 - 3D File/TA00-03-00-Waist Component - 3D File/TA00-03-0005-Waist Rotation Motor Shaft1.STEP
QingLoong V2.5/en/QingLoong V2.5 - 3D File/TA00-04-00-Chest System - 3D File/TA00-04-01-0005 Front Support Plate.step
QingLoong V2.5/en/QingLoong V2.5 - 3D File/TA00-07-00-Head Perception System - 3D File/TA00-07-01-0016 Camera Mount (Left) V2.5.step
QingLoong V2.5/en/QingLoong V2.5 - 3D File/TA00-12-00-Leg and Foot System - 3D File/TA00-12-00-0018 Knee Joint Bearing Shim.step
QingLoong V2.5/en/QingLoong V2.5 - 3D File/TA00-03-00-Waist Component - 3D File/TA00-03-0003-Front Camera Adapter Block1.STEP
QingLoong V2.5/en/QingLoong V2.5 - 3D File/TA00-04-00-Chest System - 3D File/TA00-04-01-0007 Upper Support Plate.step
QingLoong V2.5/en/QingLoong V2.5 - 3D File/TA00-07-00-Head Perception System - 3D File/TA00-07-01-0010 Side Mounting Bracket V2.5.step
QingLoong V2.5/en/QingLoong V2.5 - 3D File/TA00-12-00-Leg and Foot System - 3D File/TA00-12-06-0002 Sole Rear Rubber Pad.step
QingLoong V2.5/en/QingLoong V2.5 - 3D File/TA00-03-00-Waist Component - 3D File/TA00-03-0007-Front Swing Motor Bracket1.STEP
QingLoong V2.5/en/QingLoong V2.5 - 3D File/TA00-04-00-Chest System - 3D File/TA00-04-03-0006 Switch Fixing Plate.step
QingLoong V2.5/en/QingLoong V2.5 - 3D File/TA00-07-00-Head Perception System - 3D File/TA00-07-01-0015 Pitch Cantilever Connecting Component V2.5.step
QingLoong V2.5/en/QingLoong V2.5 - 3D File/TA00-12-00-Leg and Foot System - 3D File/TA00-12-00-0004 Connecting Rod Bushing B.step
QingLoong V2.5/en/QingLoong V2.5 - 3D File/TA00-03-00-Waist Component - 3D File/TA00-03-0008-Waist Side Swing Support Rotating Shaft1.STEP
QingLoong V2.5/en/QingLoong V2.5 - 3D File/TA00-04-00-Chest System - 3D File/TA00-04-01-0006 Front Support Plate (Mirrored).step
QingLoong V2.5/en/QingLoong V2.5 - 3D File/TA00-12-00-Leg and Foot System - 3D File/TA00-12-02-0015 Hip Pitch Limit Block.step
QingLoong V2.5/en/QingLoong V2.5 - 3D File/TA00-04-00-Chest System - 3D File/TA00-04-01-0003 Rear Support Plate.step
QingLoong V2.5/en/QingLoong V2.5 - 3D File/TA00-07-00-Head Perception System - 3D File/TA00-07-01-0006 Frame Base Plate V2.5.step
QingLoong V2.5/en/QingLoong V2.5 - 3D File/TA00-12-00-Leg and Foot System - 3D File/TA00-12-06-0001 Foot Body.step
QingLoong V2.5/en/QingLoong V2.5 - 3D File/TA00-03-00-Waist Component - 3D File/TA00-03-0013-Waist Rotation Fixing Bracket1.STEP
QingLoong V2.5/en/QingLoong V2.5 - 3D File/TA00-04-00-Chest System - 3D File/TA00-04-03-0003 Radio Fixing Plate.step
QingLoong V2.5/en/QingLoong V2.5 - 3D File/TA00-12-00-Leg and Foot System - 3D File/TA00-12-02-0001 Hip Pitch Motor Flange.step
QingLoong V2.5/en/QingLoong V2.5 - 3D File/TA00-03-00-Waist Component - 3D File/TA00-03-0014-Waist Rotation Fixing Bracket Mirrored1.STEP
QingLoong V2.5/en/QingLoong V2.5 - 3D File/TA00-04-00-Chest System - 3D File/TA00-04-01-0001 Arm Lifting Mount.step
QingLoong V2.5/en/QingLoong V2.5 - 3D File/TA00-07-00-Head Perception System - 3D File/TA00-07-01-0011 Frame Top Plate V2.5.step
QingLoong V2.5/en/QingLoong V2.5 - 3D File/TA00-12-00-Leg and Foot System - 3D File/TA00-12-04-0002-A1 Calf Crank.step
QingLoong V2.5/en/QingLoong V2.5 - 3D File/TA00-03-00-Waist Component - 3D File/TA00-03-0004-Waist Rotation Bearing Retaining Ring1.STEP
QingLoong V2.5/en/QingLoong V2.5 - 3D File/TA00-04-00-Chest System - 3D File/TA00-04-04-0002 Rear Protection Bracket.step
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
