loongOpen/OpenLoong-Hardware/QingLoong V2.5/en/QingLoong V2.5 - 2D Drawing/TA00-03-00-Waist Component - 2D Drawing/TA00-03-0001-Waist Bracket.PDF

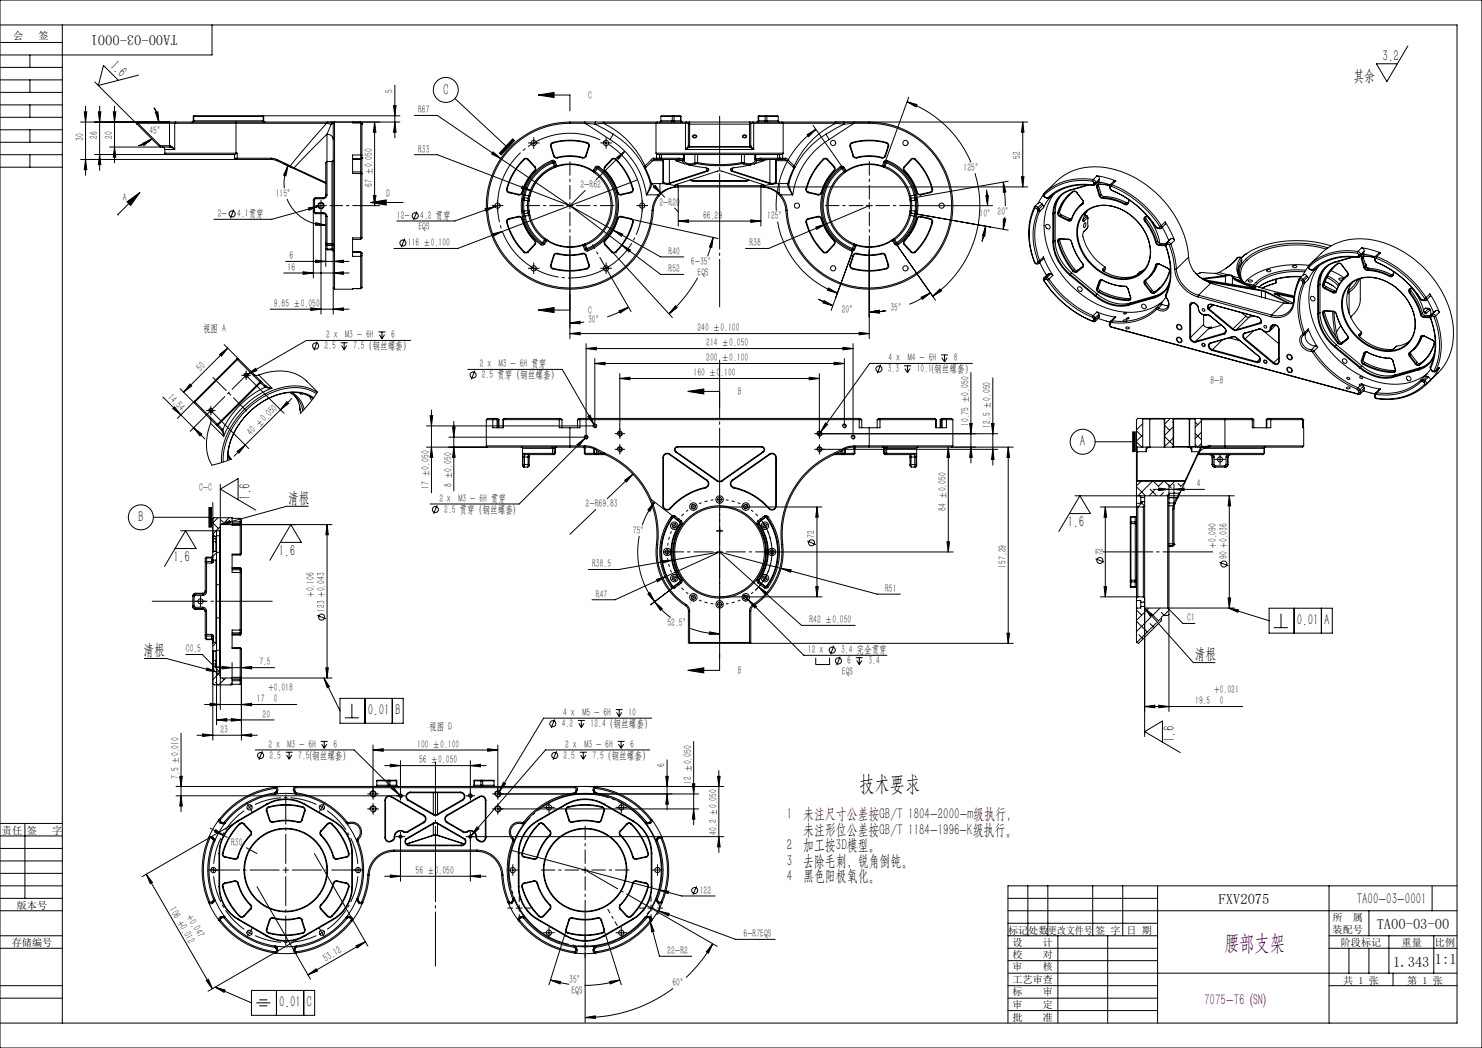
[picture p58: page 1]

1 未注尺寸公差按GB/T 1804-2000-m级执行， 未注形位公差按GB/T 1184-1996-K级执行。

FXV2075 | TA00-03-0001
腰部支架 | 所 属 装配号 | TA00-03-00

标记处数更改文件号 签 字 | 日 期
校 对 | | | | 1.343 | 1:1
审 核
工艺审查 | 7075-T6 (SN) | 共 1 张 | 第 1 张
标 审
审 定
批 准
