loongOpen/OpenLoong-Hardware/QingLoong V2.5/en/QingLoong V2.5 - 2D Drawing/TA00-03-00-Waist Component - 2D Drawing/TA00-03-0002-Front Blind Spot Camera Bracket.PDF

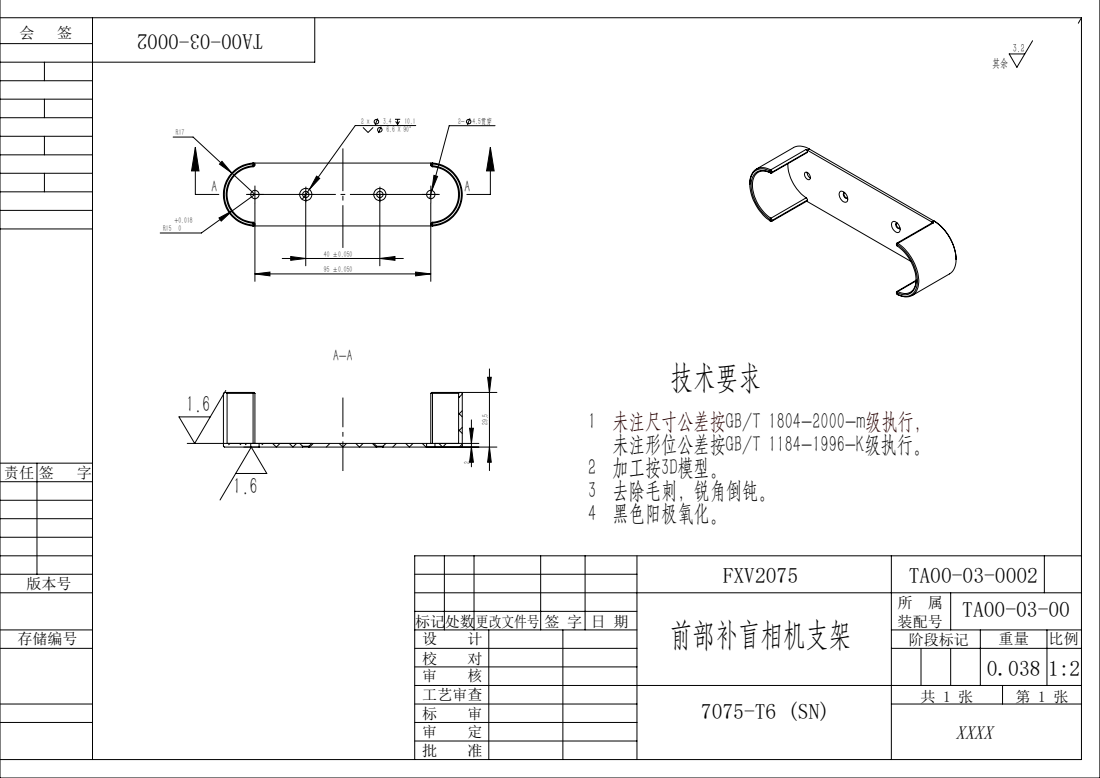
[picture p59: page 1]
2 加工按3D模型。 3 去除毛刺，锐角倒钝。 4 黑色阳极氧化。; 标记处数更改文件号

1 未注尺寸公差按GB/T 1804-2000-m级执行， 未注形位公差按GB/T 1184-1996-K级执行。
