loongOpen/OpenLoong-Hardware/QingLoong V2.5/en/QingLoong V2.5 - 2D Drawing/TA00-03-00-Waist Component - 2D Drawing/TA00-03-0003-Side Swing Motor Bracket.PDF

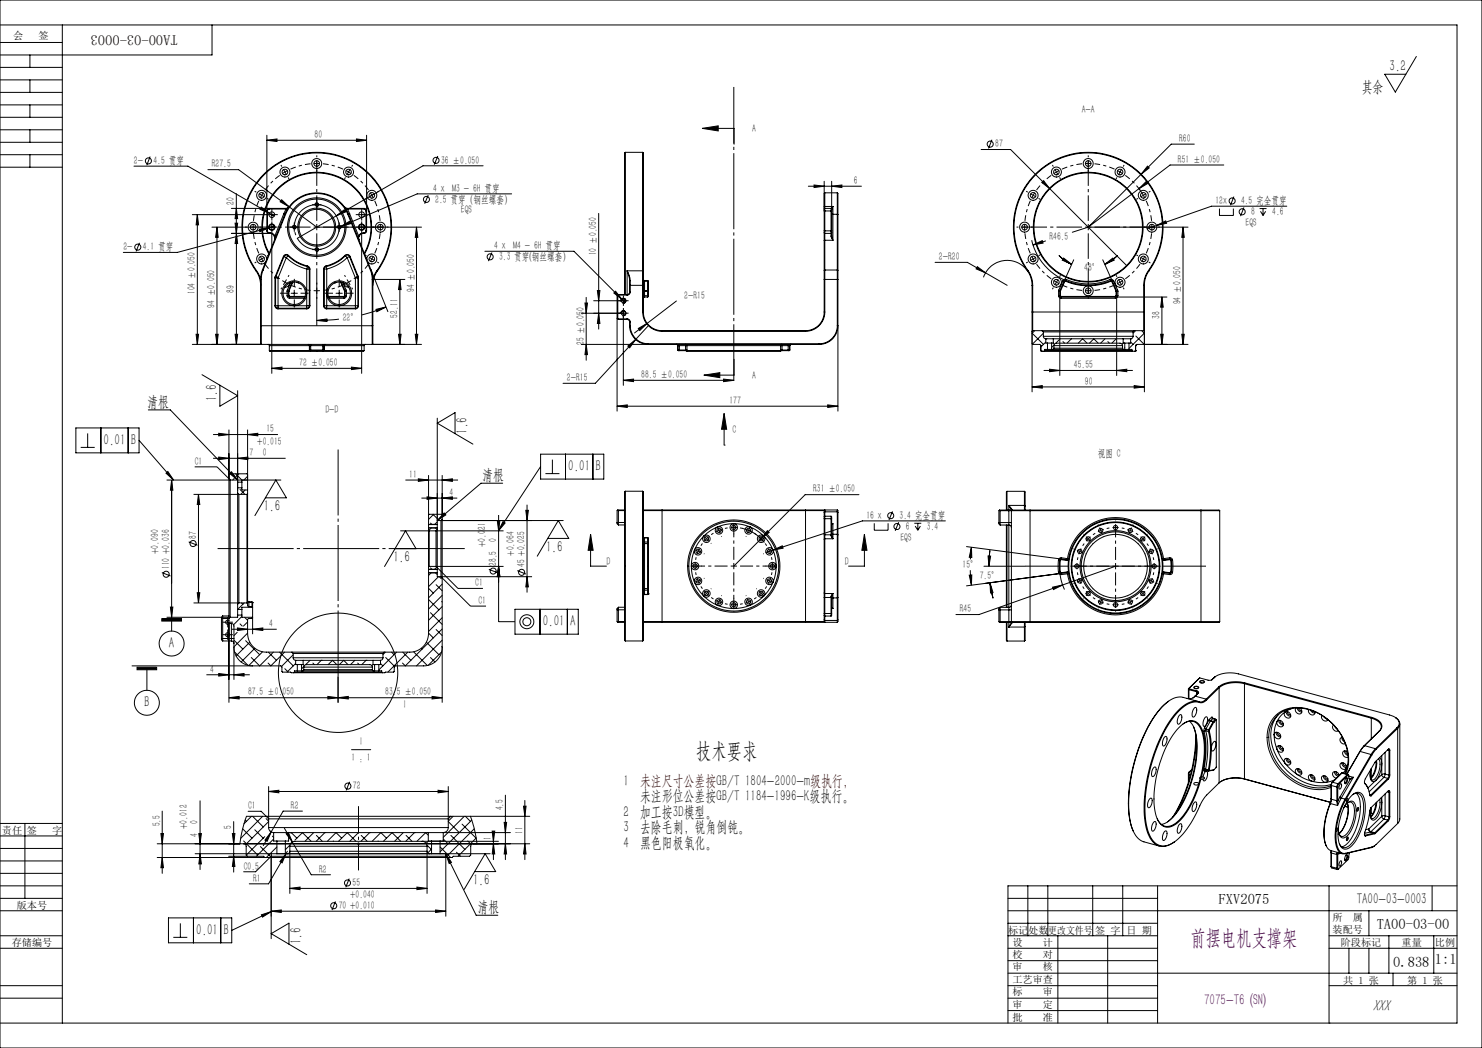
[picture p60: page 1]
4 x M4 - 6H 贯穿 3.3 贯穿(钢丝螺套）; 4 x M3 - 6H 贯穿 2.5 贯穿（钢丝螺套）; 4.5 完全贯穿; 3.4 完全贯穿; 2 加工按3D模型。 3 去除毛刺，锐角倒钝。 4 黑色阳极氧化。

1 未注尺寸公差按GB/T 1804-2000-m级执行， 未注形位公差按GB/T 1184-1996-K级执行。

FXV2075 | TA00-03-0003
前摆电机支撑架 | 所 属 装配号 | TA00-03-00

标记处数更改文件号 签 字 | 日 期
校 对 | | | | 0.838 | 1:1
审 核
工艺审查 | 7075-T6 (SN) | 共 1 张 | 第 1 张
标 审 | | XXX
审 定
批 准
