loongOpen/OpenLoong-Hardware/QingLoong V2.5/en/QingLoong V2.5 - 2D Drawing/TA00-03-00-Waist Component - 2D Drawing/TA00-03-0005-Waist Support Shaft.PDF

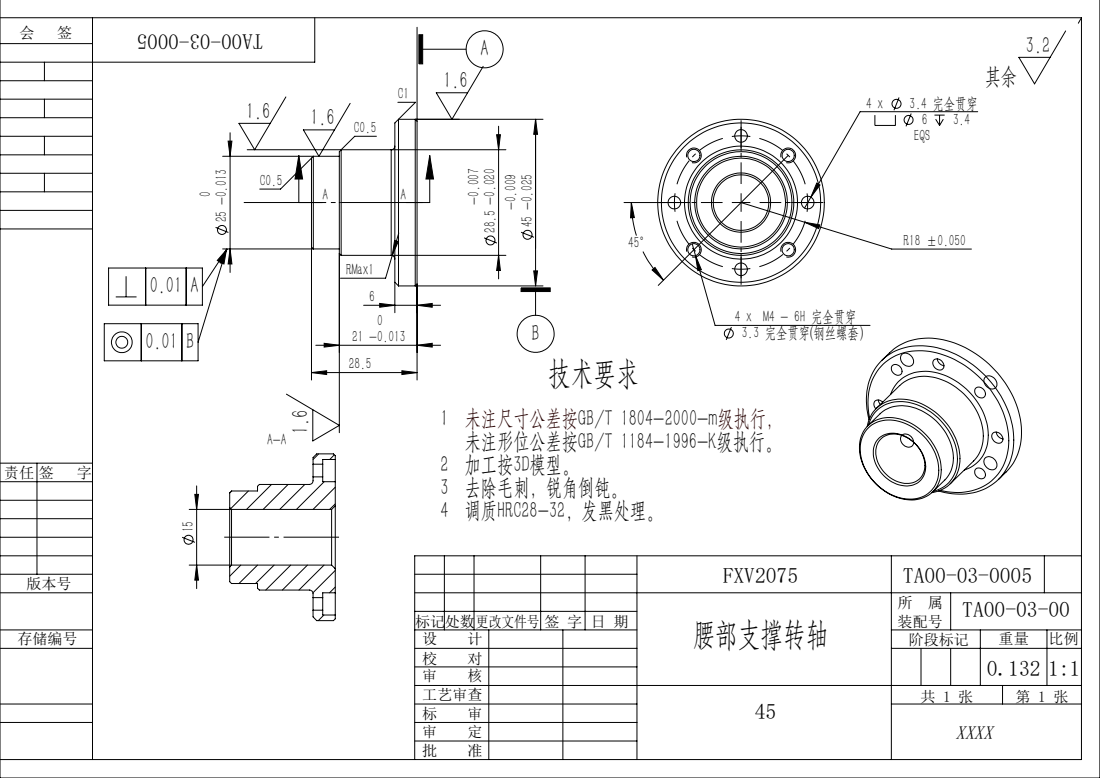
[picture p62: page 1]
3.4 完全贯穿; 4 x M4 - 6H 完全贯穿 3.3 完全贯穿(钢丝螺套）; 2 加工按3D模型。 3 去除毛刺，锐角倒钝。 4 调质HRC28-32，发黑处理。; 标记处数更改文件号

1 未注尺寸公差按GB/T 1804-2000-m级执行， 未注形位公差按GB/T 1184-1996-K级执行。
