loongOpen/OpenLoong-Hardware/QingLoong V2.5/en/QingLoong V2.5 - 2D Drawing/TA00-12-00-Leg and Foot System - 2D Drawing/TA00-12-06 Foot Assembly.pdf

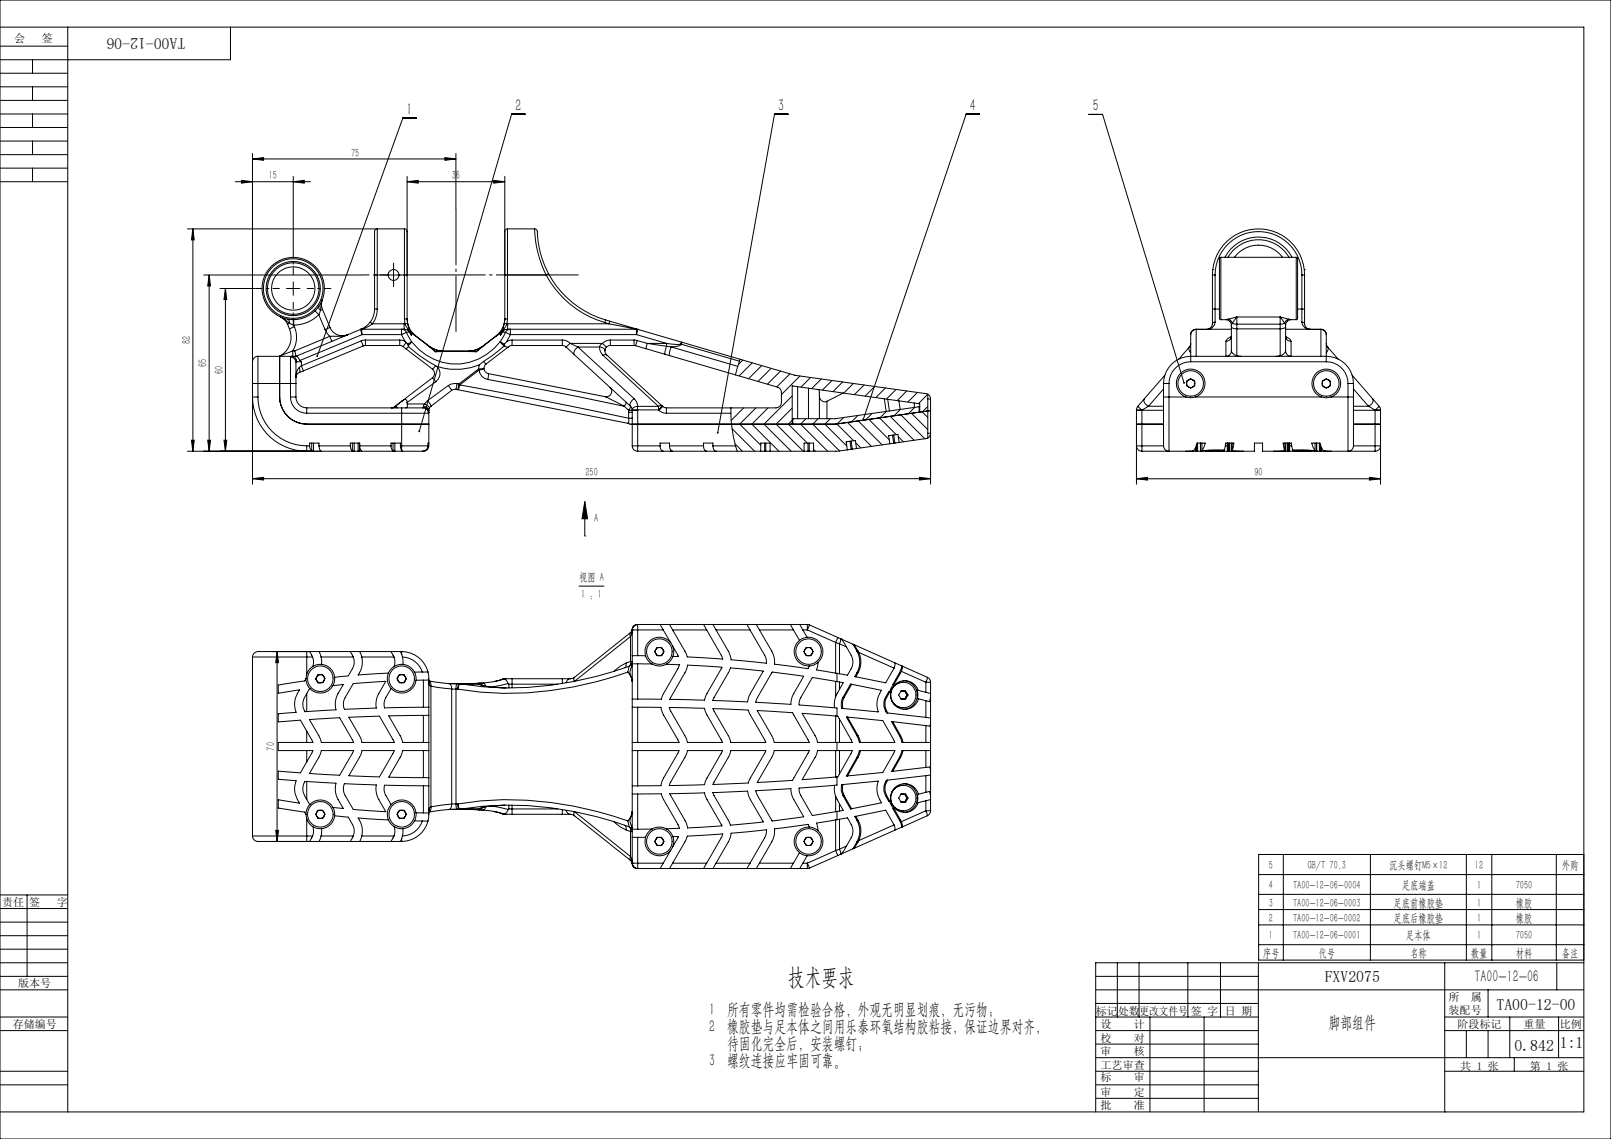
[picture p65: page 1]

5 | GB/T 70.3 | 沉头螺钉M5×12 | 12 | | 外购
4 | TA00-12-06-0004 | 足底端盖 | 1 | 7050

2 | TA00-12-06-0002 | 足底后橡胶垫 | 1 | 橡胶
1 | TA00-12-06-0001 | 足本体 | 1 | 7050
序号 | 代号 | 名称 | 数量 | 材料 | 备注

FXV2075 | TA00-12-06
脚部组件 | 所 属 装配号 | TA00-12-00

1 所有零件均需检验合格，外观无明显划痕，无污物；
2 橡胶垫与足本体之间用乐泰环氧结构胶粘接，保证边界对齐，
待固化完全后，安装螺钉；
3 螺纹连接应牢固可靠。

标记处数更改文件号 签 字 | 日 期
校 对 | | | 0.842 | 1:1
审 核
工艺审查 | 共 1 张 | 第 1 张
标 审
审 定
批 准
