loongOpen/OpenLoong-Hardware/QingLoong V2.5/en/QingLoong V2.5 - 2D Drawing/TA00-04-00-Chest System - 2D Drawing/TA00-04-0001 Front Chest Frame - Drawing 1.pdf

6.3
其余

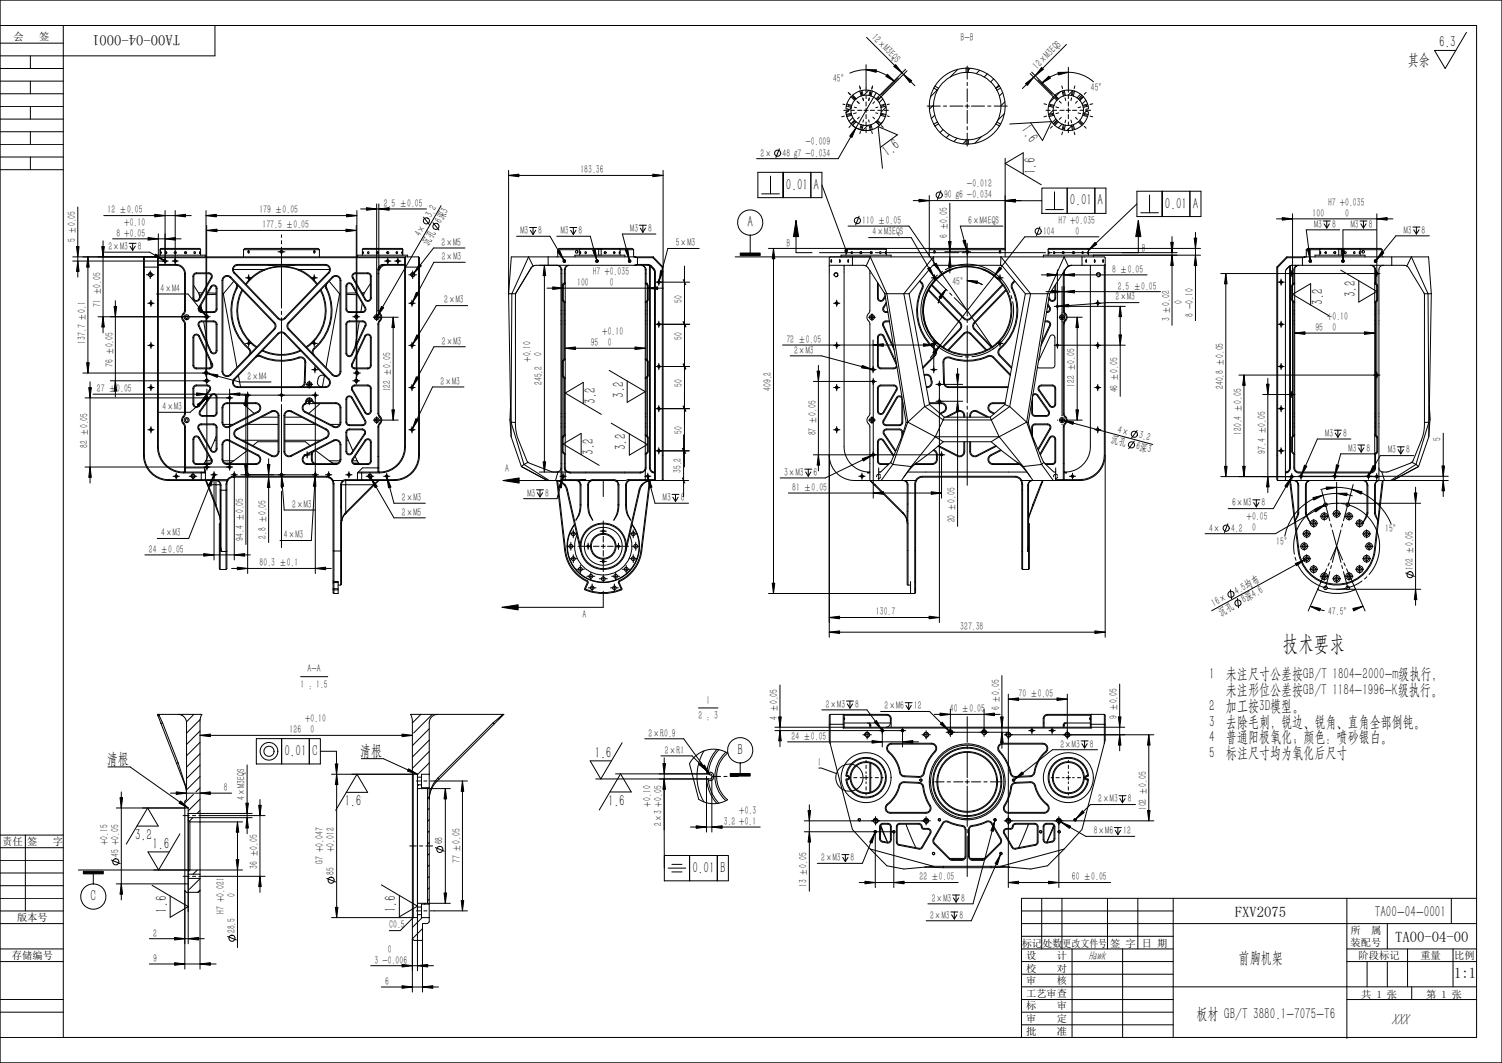
[picture p66: page 1]
Hawk; 前胸机架; FXV2075; 版本号; 存储编号; 装配号; 阶段标记; 标记处数更改文件号 签 字; 未注尺寸公差按; 级执行，; 5 标注尺寸均为氧化后尺寸; 技术要求; 6×M4EQS; 4×M3EQS; 12×M3EQS

2.5 ±0.05
2×M3

未注形位公差按GB/T 1184-1996-K级执行。
2 加工按3D模型。
4 普通阳极氧化；颜色：喷砂银白。 3 去除毛刺，锐边、锐角、直角全部倒钝。

校 对 | | | | 1:1
审 核
工艺审查 | 板材 GB/T 3880.1-7075-T6 | 共 1 张 | 第 1 张
标 审 | | XXX
审 定
批 准
