loongOpen/OpenLoong-Hardware/QingLoong V2.5/en/QingLoong V2.5 - 2D Drawing/TA00-04-00-Chest System - 2D Drawing/TA00-04-0002 Hook (Right) - Drawing 1.pdf

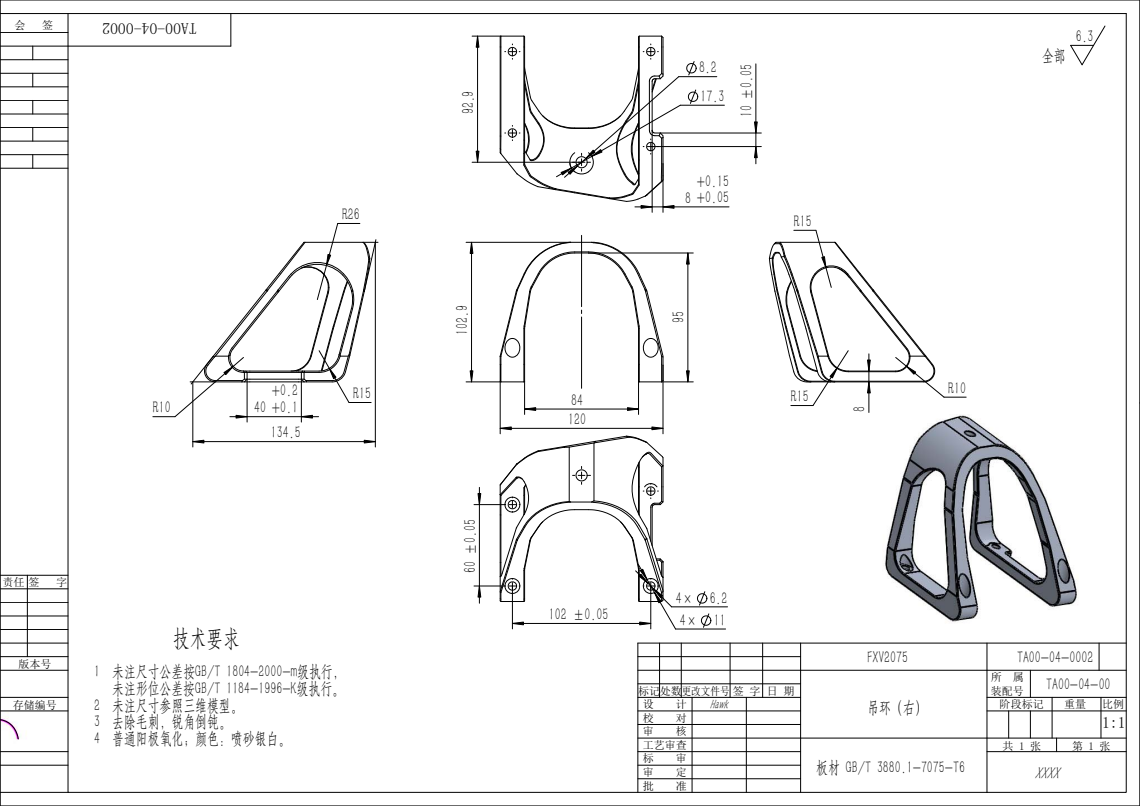
[picture p67: page 1]
装配号; XXXX; FXV2075; 阶段标记; 版本号; 存储编号; 未注尺寸公差按; 级执行， GB/T 1804-2000-m; 技术要求

未注形位公差按GB/T 1184-1996-K级执行。
2 未注尺寸参照三维模型。
3 去除毛刺，锐角倒钝。 4 普通阳极氧化；颜色：喷砂银白。

标记处数更改文件号 签 字 | | 日 期
设 计 | Hawk
校 对
审 核 工艺审查

标 审
审 定
