loongOpen/OpenLoong-Hardware/QingLoong V2.5/en/QingLoong V2.5 - 2D Drawing/TA00-04-00-Chest System - 2D Drawing/TA00-04-0003 Hook (Left) - Drawing 1.pdf

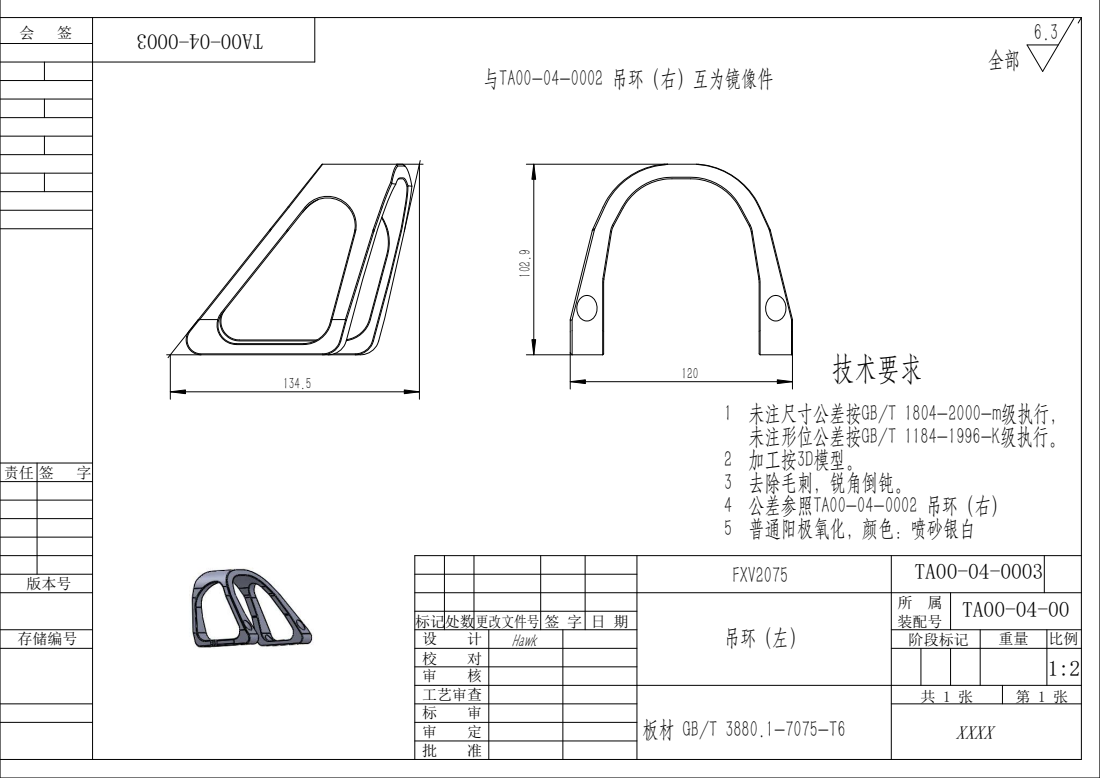
[picture p68: page 1]
存储编号; 版本号; Hawk; 阶段标记; 未注尺寸公差按; 级执行，; 未注形位公差按GB/T 1184-1996-K级执行。; 4 公差参照TA00-04-0002 吊环（右）; 3 去除毛刺，锐角倒钝。; 2 加工按3D模型。; 与TA00-04-0002 吊环（右）互为镜像件; 5 普通阳极氧化，颜色：喷砂银白; 技术要求

FXV2075 | TA00-04-0003
吊环（左） | 所 属 | TA00-04-00 装配号

标记 | 处数更改文件号 | 签 字 | 日 期

校 对 | | | | 1:2
审 核
工艺审查 | 板材 GB/T 3880.1-7075-T6 | 共 1 张 | 第 1 张
标 审 | | XXXX
审 定
批 准
