loongOpen/OpenLoong-Hardware/QingLoong V2.5/en/QingLoong V2.5 - 2D Drawing/TA00-04-00-Chest System - 2D Drawing/TA00-04-0004 Radar Adapter Plate - Drawing 1.pdf

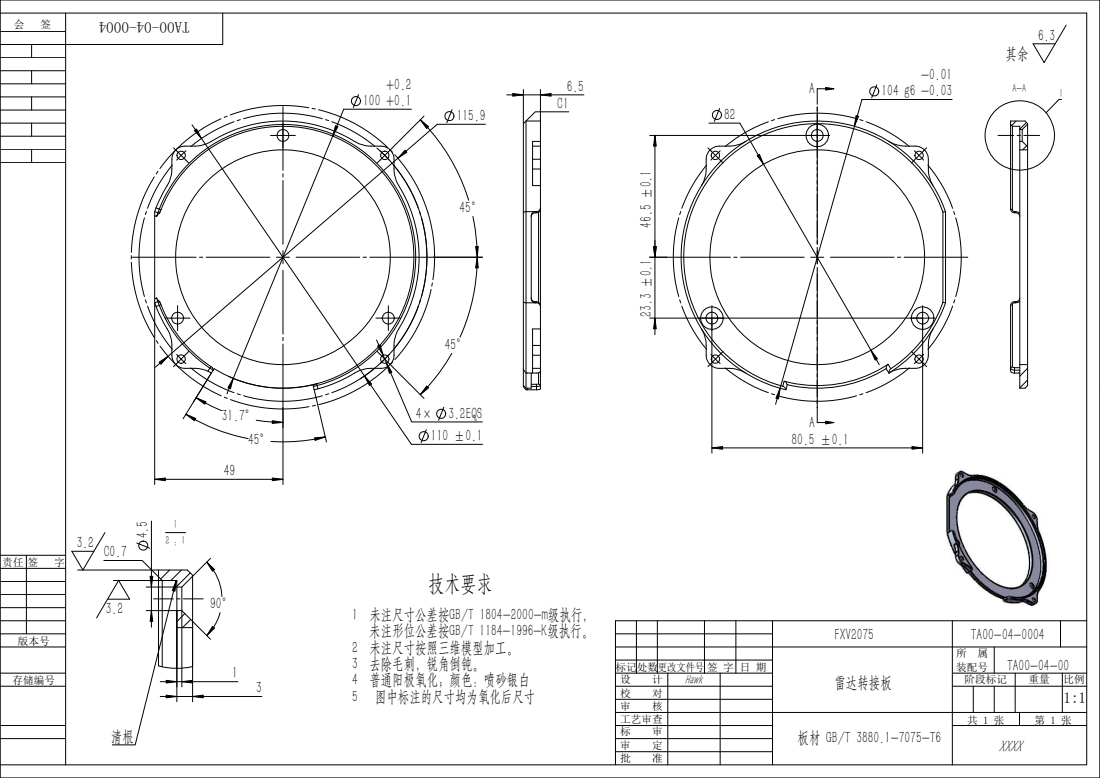
[picture p69: page 1]
版本号; FXV2075; 雷达转接板; 标记处数更改文件号 签 字; XXXX; Hawk; 阶段标记; 装配号; 存储编号; 技术要求; 5 图中标注的尺寸均为氧化后尺寸; 3.2EQS

1 未注尺寸公差按GB/T 1804-2000-m级执行，
未注形位公差按GB/T 1184-1996-K级执行。
2 未注尺寸按照三维模型加工。
3 去除毛刺，锐角倒钝。 4 普通阳极氧化；颜色：喷砂银白

校 对
审 核 工艺审查

标 审
审 定
