loongOpen/OpenLoong-Hardware/QingLoong V2.5/en/QingLoong V2.5 - 2D Drawing/TA00-04-00-Chest System - 2D Drawing/TA00-04-0005 WiFi Heat Dissipation Plate - Drawing 1.pdf

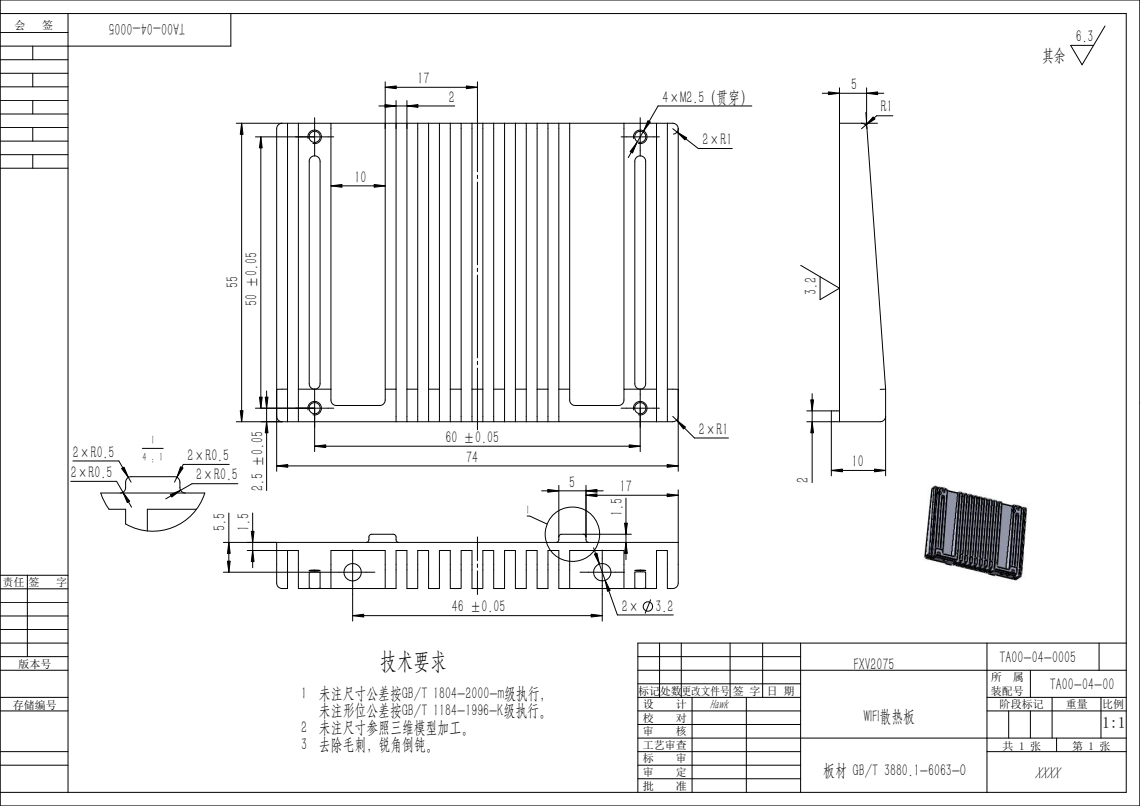
[picture p70: page 1]
阶段标记; 存储编号; 版本号; Hawk; 1 未注尺寸公差按; 级执行， GB/T 1804-2000-m; 未注形位公差按GB/T 1184-1996-K级执行。; 3 去除毛刺，锐角倒钝。; 2 未注尺寸参照三维模型加工。; 技术要求

FXV2075 | TA00-04-0005
WIFI散热板 | 所 属 装配号 | TA00-04-00

标记处数更改文件号 签 字 | 日 期

校 对 | | | | 1:1
审 核
工艺审查 | 板材 GB/T 3880.1-6063-O | 共 1 张 | 第 1 张
标 审 | | XXXX
审 定
批 准
