loongOpen/OpenLoong-Hardware/QingLoong V2.5/en/QingLoong V2.5 - 2D Drawing/TA00-04-00-Chest System - 2D Drawing/TA00-04-0007 Main Control Fixing Part - Drawing 1.pdf

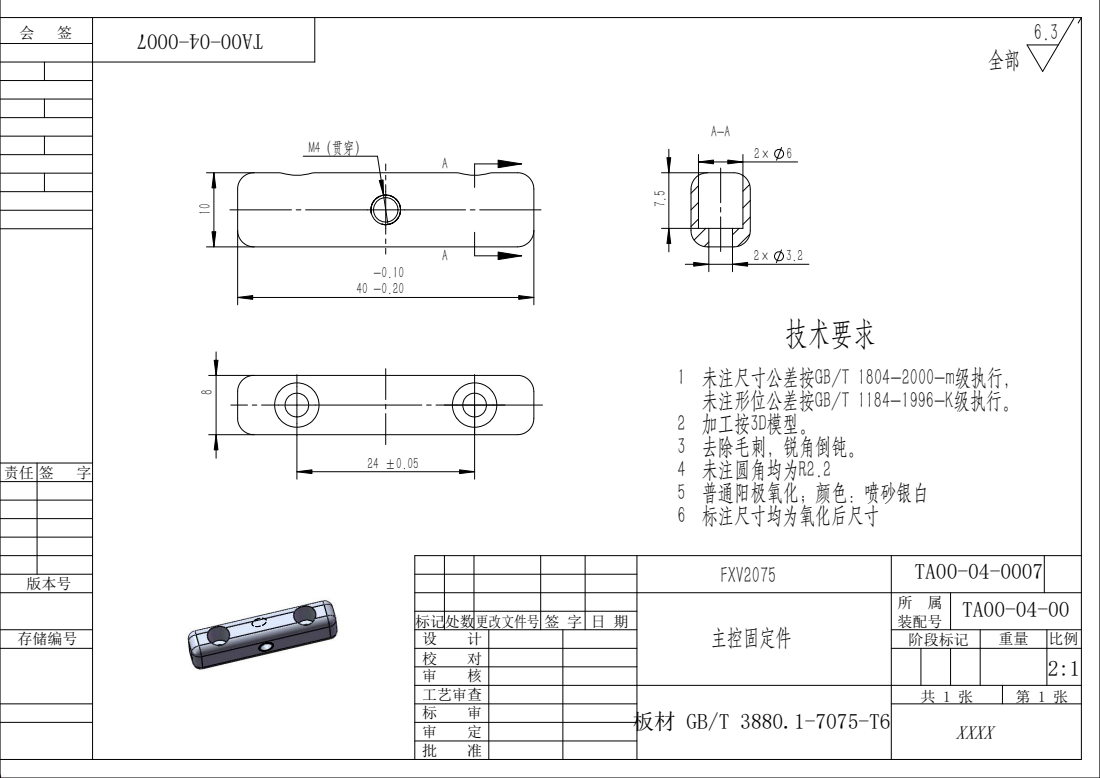
[picture p72: page 1]
存储编号; 版本号; 阶段标记; 技术要求; 1 未注尺寸公差按GB/T 1804-2000-m级执行， 未注形位公差按GB/T 1184-1996-K级执行。 2 加工按3D模型。 3 去除毛刺，锐角倒钝。 4 未注圆角均为R2.2 5 普通阳极氧化；颜色：喷砂银白 6 标注尺寸均为氧化后尺寸

FXV2075 | TA00-04-0007
主控固定件 | 所 属 | TA00-04-00 装配号

标记处数更改文件号 | 签 字 | 日 期
校 对 | | | | 2:1
审 核
工艺审查 | 板材 GB/T 3880.1-7075-T6 | 共 1 张 | 第 1 张
标 审 | | XXXX
审 定
批 准
