loongOpen/OpenLoong-Hardware/QingLoong V2.5/en/QingLoong V2.5 - 2D Drawing/TA00-04-00-Chest System - 2D Drawing/TA00-04-0008 Main Control Fixing Part (Sub) - Drawing 1.pdf

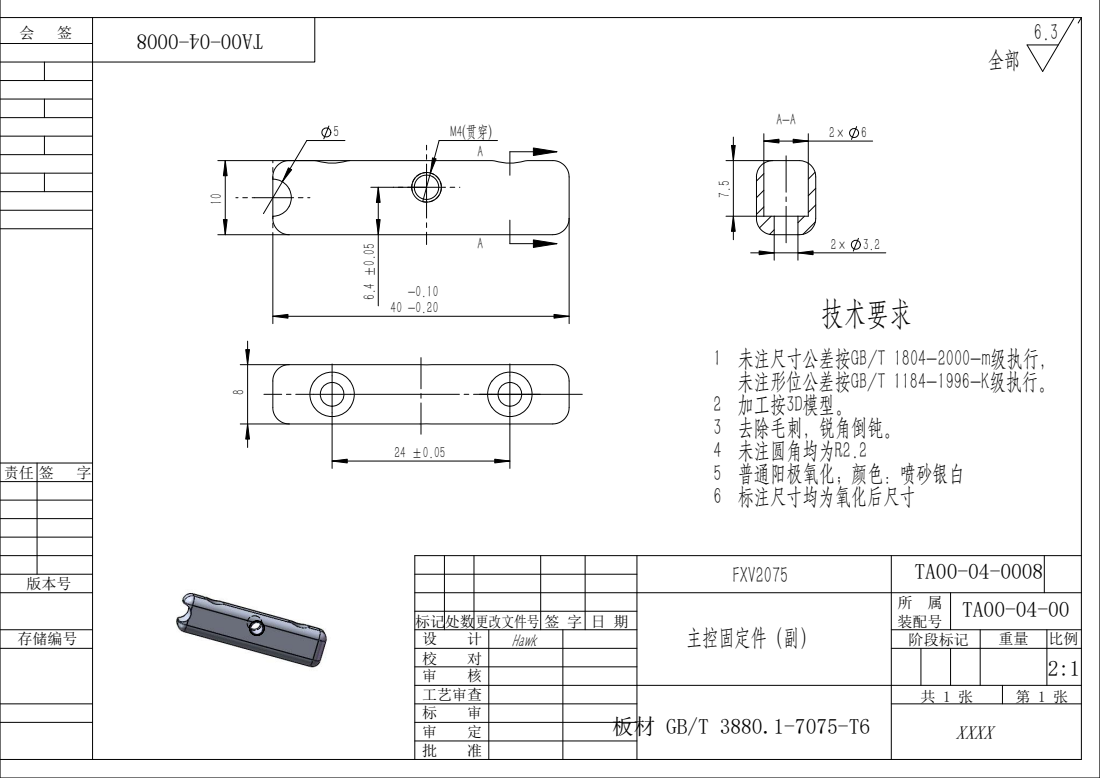
[picture p73: page 1]
存储编号; 版本号; Hawk; 阶段标记; 未注尺寸公差按; 级执行，; 6 标注尺寸均为氧化后尺寸; 技术要求

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

FXV2075 | TA00-04-0008
主控固定件（副） | 所 属 | TA00-04-00 装配号

标记 | 处数更改文件号 | 签 字 | 日 期
校 对 | | | | 2:1
审 核
工艺审查 | 板材 GB/T 3880.1-7075-T6 | 共 1 张 | 第 1 张
标 审 | | XXXX
审 定
批 准
