loongOpen/OpenLoong-Hardware/QingLoong V2.5/en/QingLoong V2.5 - 2D Drawing/TA00-04-00-Chest System - 2D Drawing/TA00-04-0009 Cloud Box Support Plate - Drawing 1.pdf

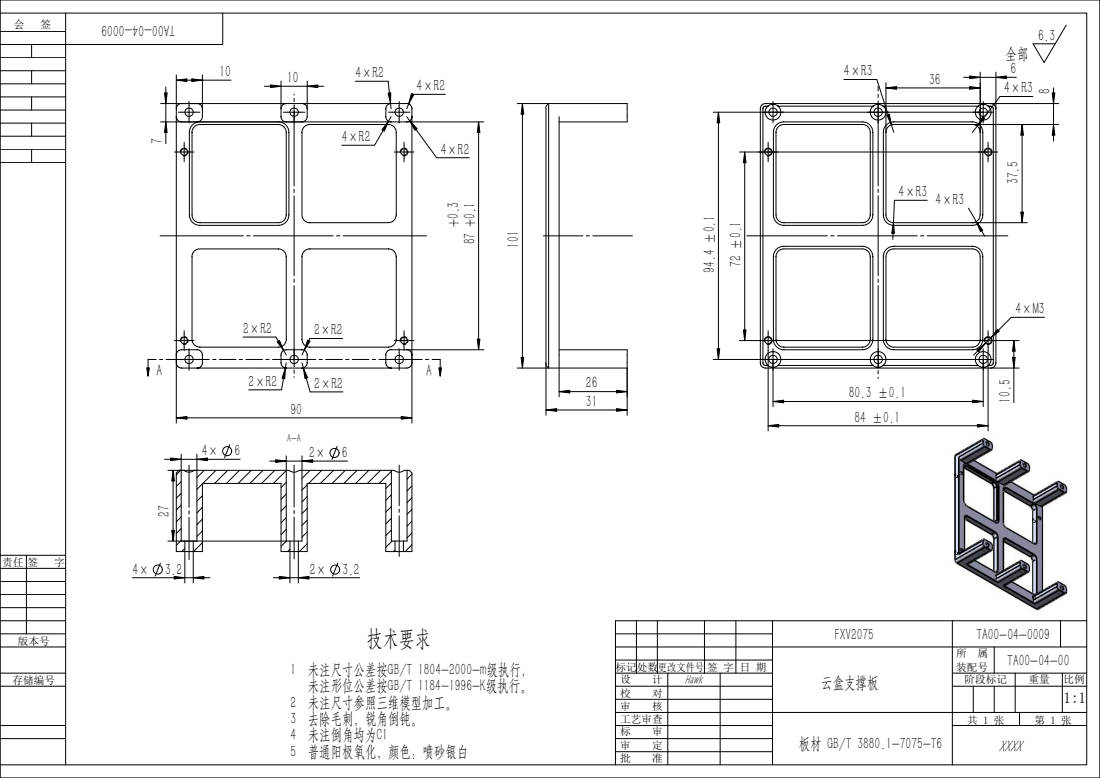
[picture p74: page 1]
XXXX; Hawk; FXV2075; 云盒支撑板 校; 标记处数更改文件号 签 字; 阶段标记; 装配号; 存储编号; 版本号; 技术要求

1 未注尺寸公差按GB/T 1804-2000-m级执行，
未注形位公差按GB/T 1184-1996-K级执行。
2 未注尺寸参照三维模型加工。
3 去除毛刺，锐角倒钝。
4 未注倒角均为C1
5 普通阳极氧化，颜色：喷砂银白

审 核 工艺审查

标 审
审 定
