loongOpen/OpenLoong-Hardware/QingLoong V2.5/en/QingLoong V2.5 - 2D Drawing/TA00-04-00-Chest System - 2D Drawing/TA00-04-0010 Battery Fixing Plate - Drawing 1.PDF

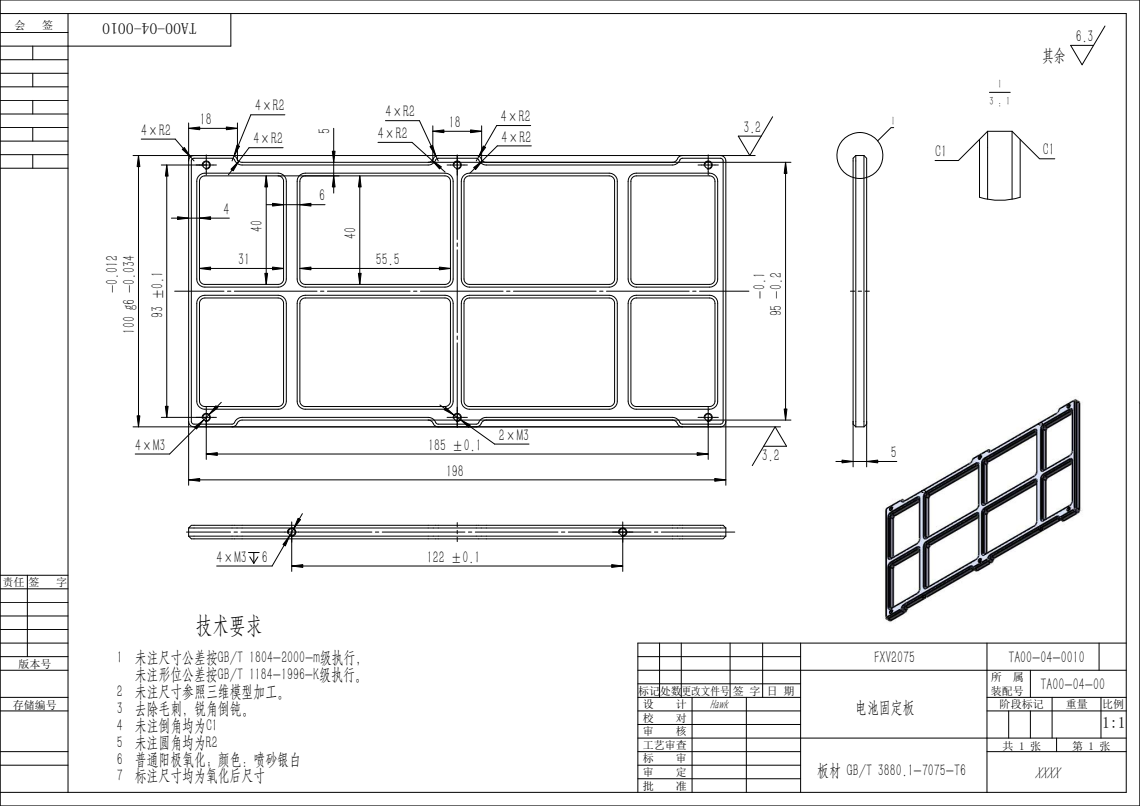
[picture p75: page 1]
Hawk; 阶段标记; 存储编号; 版本号; 未注尺寸公差按; 级执行，; 7 标注尺寸均为氧化后尺寸; 技术要求

未注形位公差按GB/T 1184-1996-K级执行。
2 未注尺寸参照三维模型加工。
3 去除毛刺，锐角倒钝。
4 未注倒角均为C1
6 普通阳极氧化；颜色：喷砂银白 5 未注圆角均为R2

FXV2075 | TA00-04-0010
电池固定板 | 所 属 装配号 | TA00-04-00

标记处数更改文件号 签 字 | 日 期

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
