loongOpen/OpenLoong-Hardware/QingLoong V2.5/en/QingLoong V2.5 - 2D Drawing/TA00-04-00-Chest System - 2D Drawing/TA00-04-0011 Battery Fixing Plate (Sub) - Drawing 1.PDF

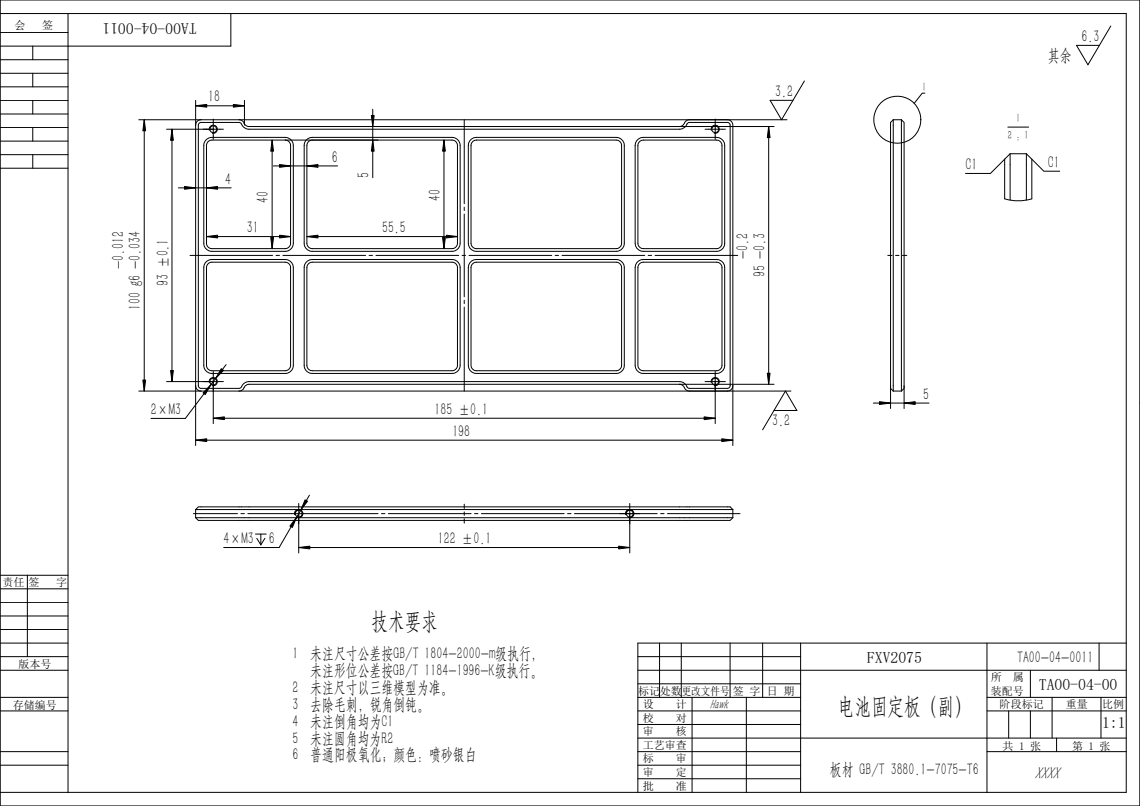
[picture p76: page 1]
阶段标记; 存储编号; 版本号; Hawk; 未注尺寸公差按; 级执行，; 4 未注倒角均为C1 3 去除毛刺，锐角倒钝。; 2 未注尺寸以三维模型为准。; 技术要求; 未注形位公差按GB/T 1184-1996-K级执行。

FXV2075 | TA00-04-0011
电池固定板（副） | 所 属 装配号 | TA00-04-00

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

5 未注圆角均为R2
6 普通阳极氧化；颜色：喷砂银白
