loongOpen/OpenLoong-Hardware/QingLoong V2.5/en/QingLoong V2.5 - 2D Drawing/TA00-04-00-Chest System - 2D Drawing/TA00-04-0013 Surround Fixing Part (Rear Mirror) - Drawing 1.PDF

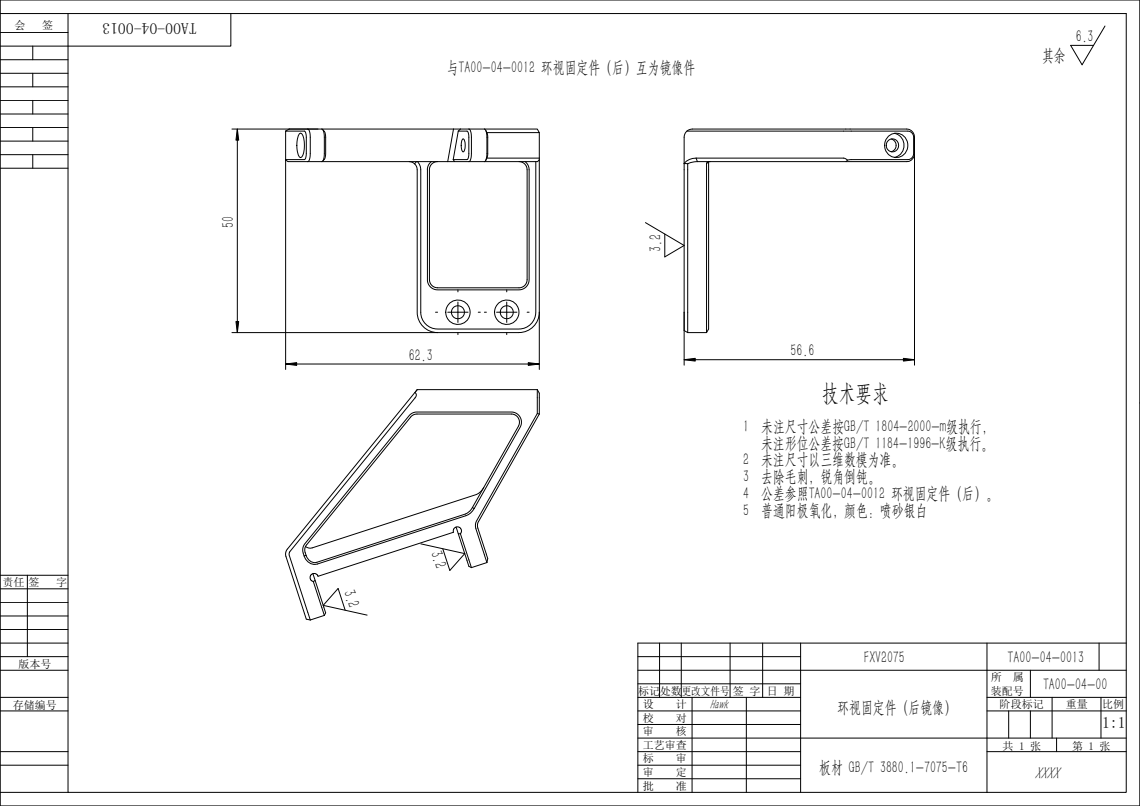
[picture p78: page 1]
阶段标记; FXV2075; 装配号; 存储编号; 版本号; XXXX; Hawk; 环视固定件（后镜像）; 未注尺寸公差按; 级执行，; 与TA00-04-0012 环视固定件（后）互为镜像件; 技术要求

未注形位公差按GB/T 1184-1996-K级执行。
2 未注尺寸以三维数模为准。
4 公差参照TA00-04-0012 环视固定件（后）。 3 去除毛刺，锐角倒钝。

5 普通阳极氧化，颜色：喷砂银白

标记处数更改文件号 签 字 | 日 期
设 计
校 对
审 核 工艺审查

标 审
审 定
