loongOpen/OpenLoong-Hardware/QingLoong V2.5/en/QingLoong V2.5 - 2D Drawing/TA00-04-00-Chest System - 2D Drawing/TA00-04-0015 Surround Fixing Part (Front Mirror) - Drawing 1.PDF

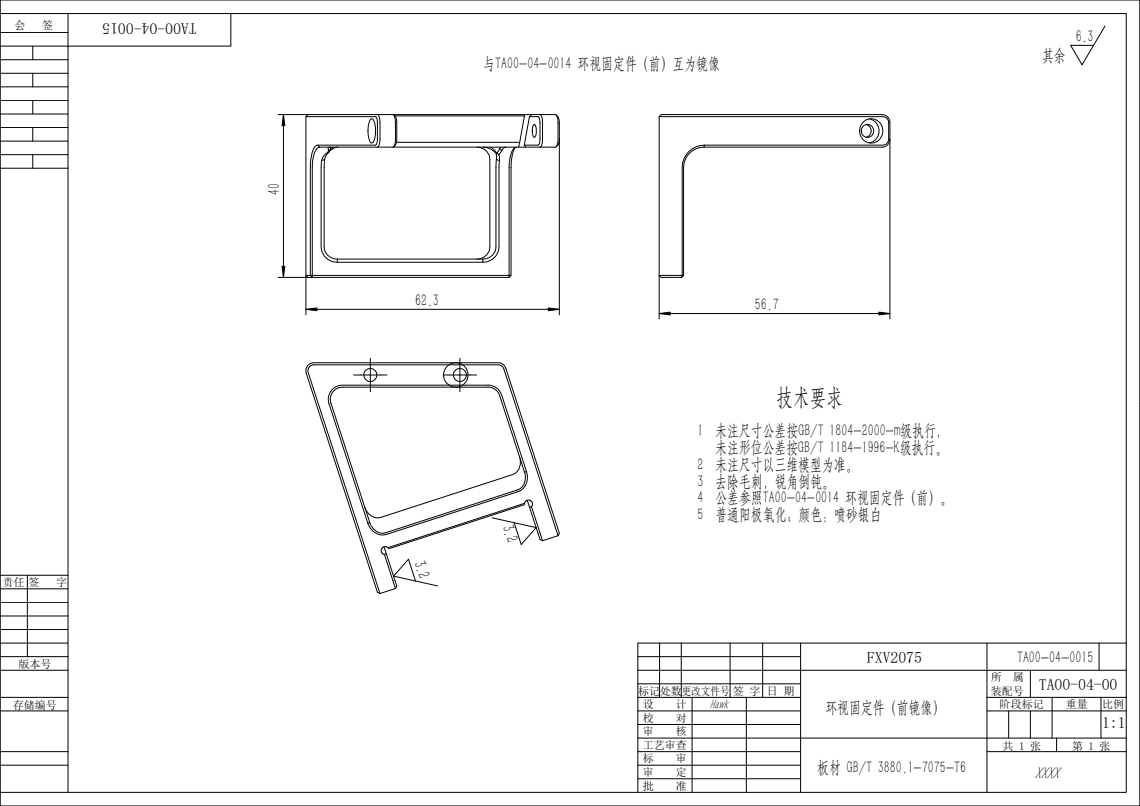
[picture p80: page 1]
Hawk; 环视固定件（前镜像） 校; 标记处数更改文件号 签 字; 阶段标记; XXXX; 装配号; 存储编号; 版本号; FXV2075; 未注尺寸公差按; 级执行，; 与TA00-04-0014 环视固定件（前）互为镜像; 技术要求

未注形位公差按GB/T 1184-1996-K级执行。
2 未注尺寸以三维模型为准。
4 公差参照TA00-04-0014 环视固定件（前）。 3 去除毛刺，锐角倒钝。

5 普通阳极氧化；颜色：喷砂银白

审 核 工艺审查

标 审
审 定
