loongOpen/OpenLoong-Hardware/QingLoong V2.5/en/QingLoong V2.5 - 2D Drawing/TA00-04-00-Chest System - 2D Drawing/TA00-04-0016 Rear Bracket - Drawing 1.PDF

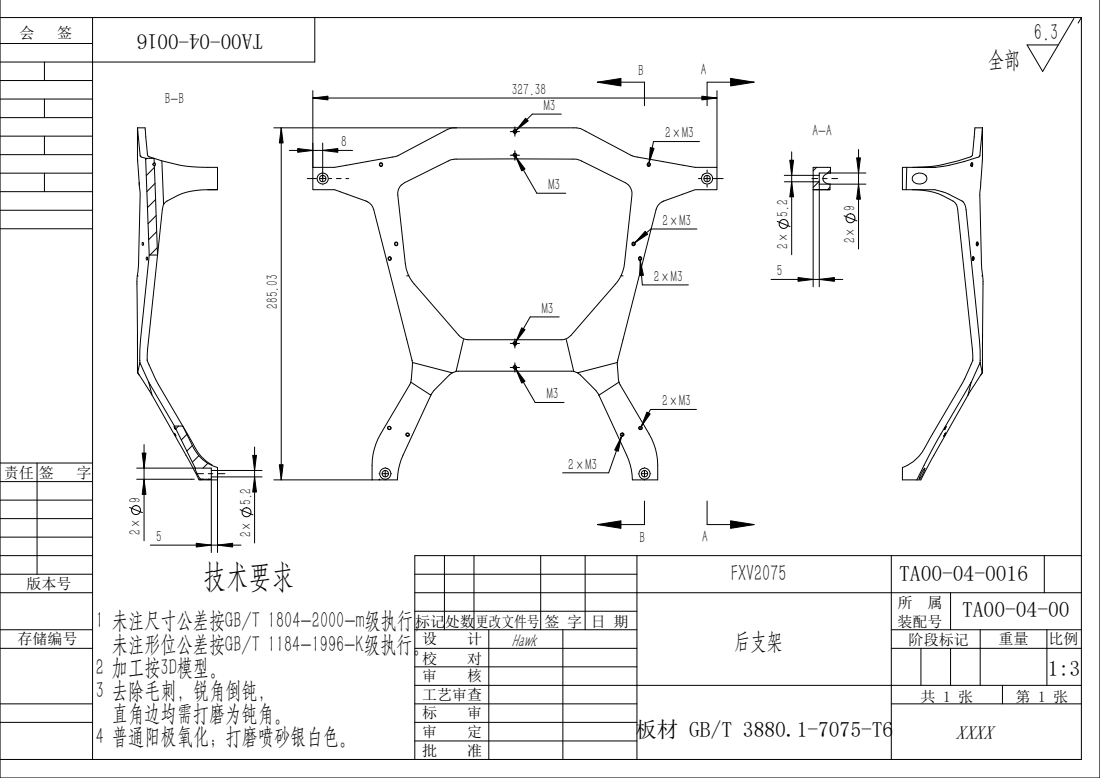
[picture p81: page 1]
存储编号; 版本号; Hawk; 阶段标记; 后支架 未注尺寸公差按; 级执行， 未注形位公差按GB/T 1184-1996-K级执行。; 2 加工按3D模型。 3 去除毛刺，锐角倒钝， 直角边均需打磨为钝角。 4 普通阳极氧化；打磨喷砂银白色。; 技术要求

FXV2075 | TA00-04-0016

所 属 | TA00-04-00 装配号

标记 | 处数更改文件号 | 签 字 | 日 期

校 对 | | | | 1:3
审 核
工艺审查 | 板材 GB/T 3880.1-7075-T6 | 共 1 张 | 第 1 张
标 审 | | XXXX
审 定
批 准
