loongOpen/OpenLoong-Hardware/QingLoong V2.5/en/QingLoong V2.5 - 2D Drawing/TA00-04-00-Chest System - 2D Drawing/TA00-07-0001 Cylindrical Base - Drawing 1.PDF

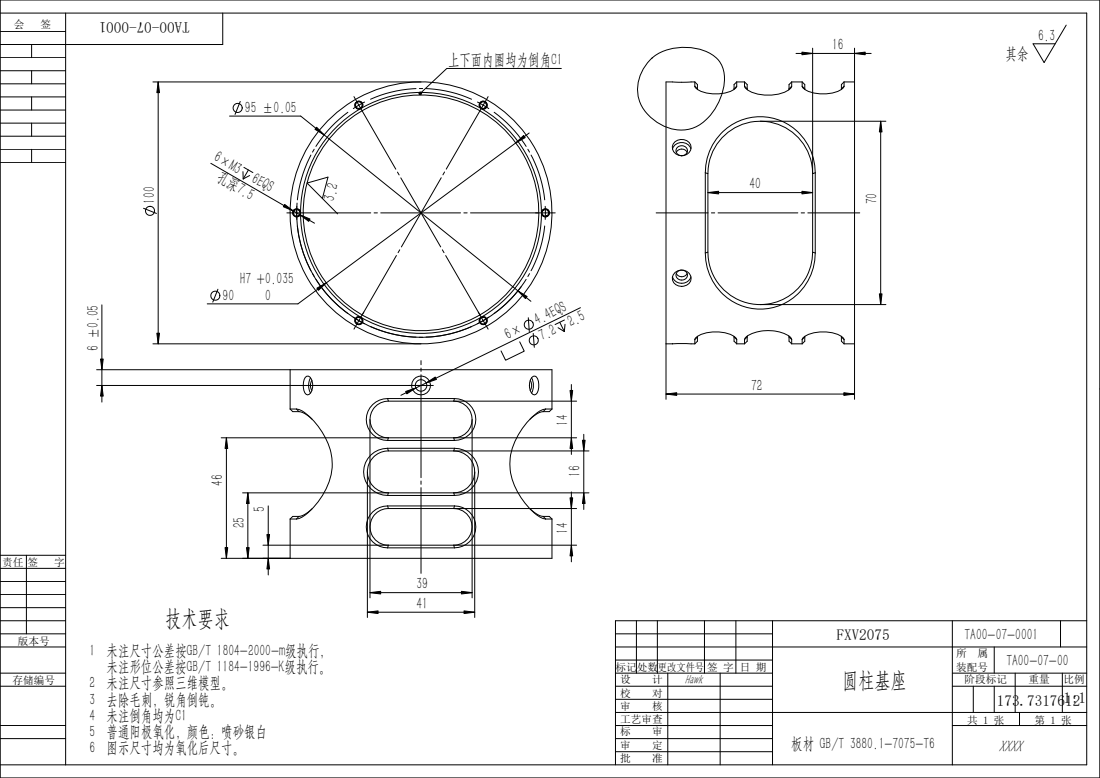
[picture p82: page 1]
Hawk; 阶段标记; 存储编号; 版本号; 上下面内圈均为倒角C1; 6EQS; 未注尺寸公差按; 级执行，; 6 图示尺寸均为氧化后尺寸。; 技术要求; 6 ±0.05 6× 4.4EQS

FXV2075 | TA00-07-0001
圆柱基座 | 所 属 装配号 | TA00-07-00

未注形位公差按GB/T 1184-1996-K级执行。
2 未注尺寸参照三维模型。
3 去除毛刺，锐角倒钝。
5 普通阳极氧化，颜色：喷砂银白 4 未注倒角均为C1

标记处数更改文件号 签 字 | 日 期
校 对 | | | | 173.7317612 | 1:1
审 核
工艺审查 | 板材 GB/T 3880.1-7075-T6 | 共 1 张 | 第 1 张
标 审 | | XXXX
审 定
批 准
