loongOpen/OpenLoong-Hardware/QingLoong V2.5/en/QingLoong V2.5 - 2D Drawing/TA00-07-00-Head Perception System - 2D Drawing/TA00-07-01-0006.pdf

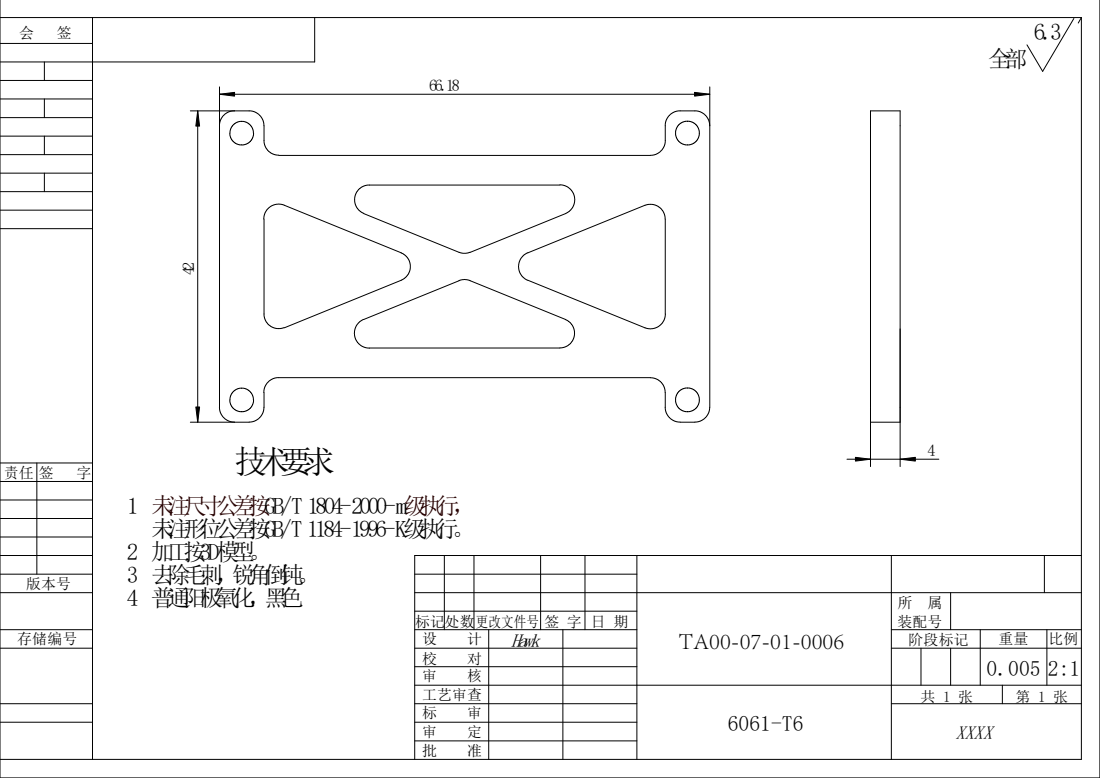
[picture p86: page 1]
存储编号; 版本号; Hawk; 阶段标记; 未注尺寸公差按; 级执行，; 技术要求

未注形位公差按GB/T 1184-1996-K级执行。 2 加工按3D模型。 3 去除毛刺，锐角倒钝。 4 普通阳极氧化，黑色

TA00-07-01-0006 | 所 属 装配号

标记 | 处数 | 更改文件号 | 签 字 | 日 期

审 核
工艺审查 | 6061-T6 | 共 1 张 | 第 1 张
标 审 审 定 | | XXXX
