loongOpen/OpenLoong-Hardware/QingLoong V2.5/en/QingLoong V2.5 - 2D Drawing/TA00-07-00-Head Perception System - 2D Drawing/TA00-07-01-0008.pdf

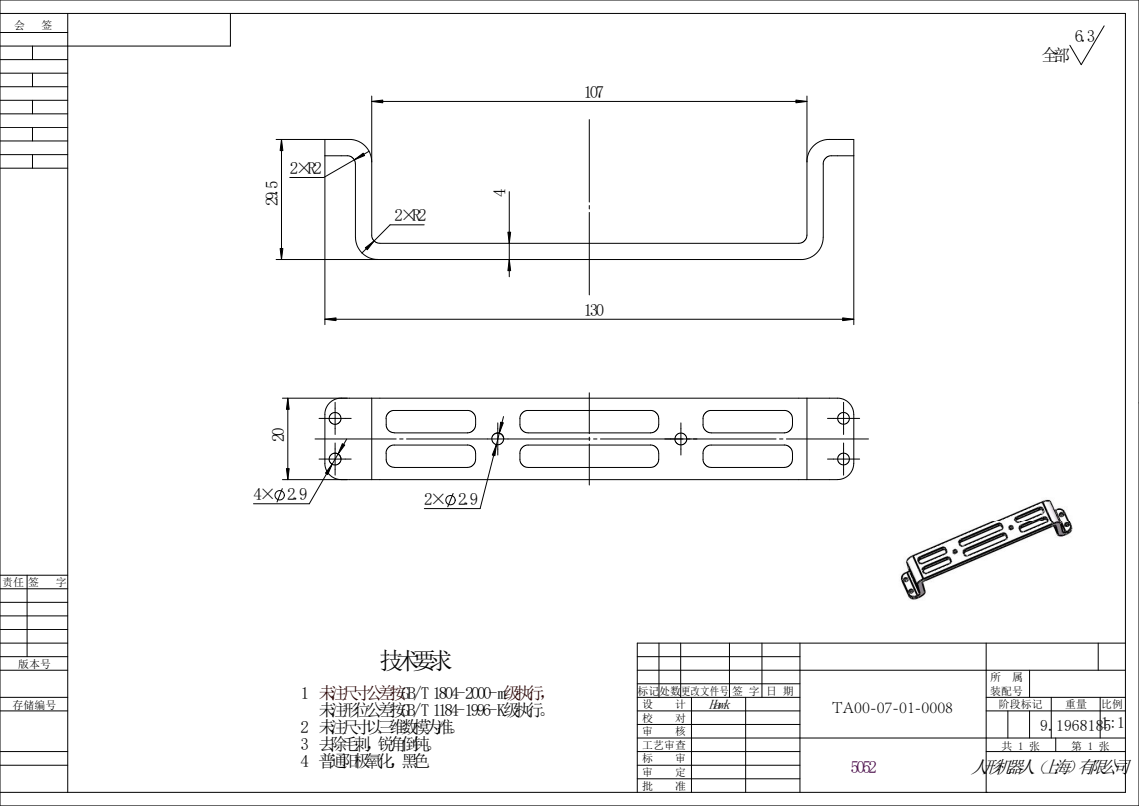
[picture p88: page 1]
Hawk; 版本号; 阶段标记; 存储编号; 未注尺寸公差按; 级执行，; 技术要求

TA00-07-01-0008 | 所 属 装配号

未注形位公差按GB/T 1184-1996-K级执行。 2 未注尺寸以三维数模为准。 3 去除毛刺，锐角倒钝。 4 普通阳极氧化，黑色

标记处数更改文件号 签 字 | 日 期

校 对 | | | | 9.1968185 | 1:1
审 核
工艺审查 | 5052 | 共 1 张 | 第 1 张
标 审 | 人形机器人（上海）有限公司
审 定
批 准
