loongOpen/OpenLoong-Hardware/QingLoong V2.5/en/QingLoong V2.5 - 2D Drawing/TA00-07-00-Head Perception System - 2D Drawing/TA00-07-01-0011.pdf

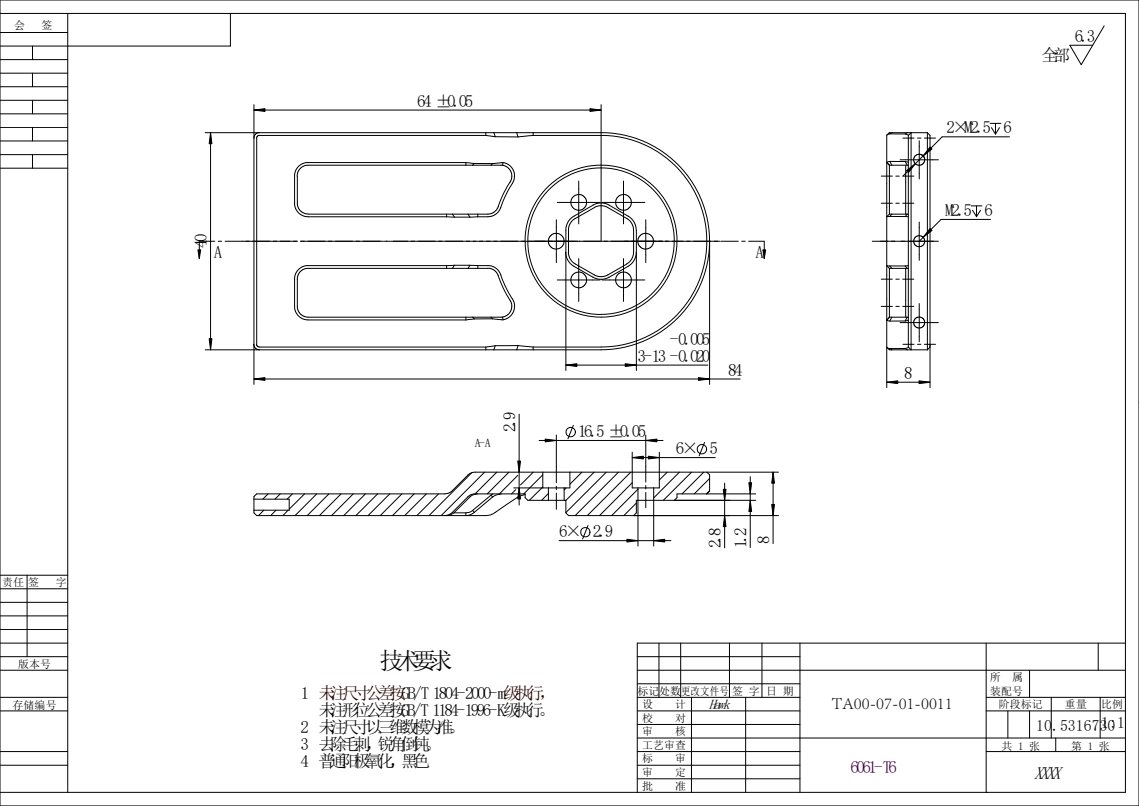
[picture p91: page 1]
版本号; 阶段标记; 存储编号; Hawk; 技术要求

TA00-07-01-0011 | 所 属 装配号

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

标记处数更改文件号 | 签 字 | 日 期
校 对 | | | | 10.5316730 | 1:1
审 核
工艺审查 | 6061-T6 | 共 1 张 | 第 1 张
标 审 | | XXXX
审 定
批 准
