loongOpen/OpenLoong-Hardware/QingLoong V2.5/en/QingLoong V2.5 - 2D Drawing/TA00-07-00-Head Perception System - 2D Drawing/TA00-07-01-0013.pdf

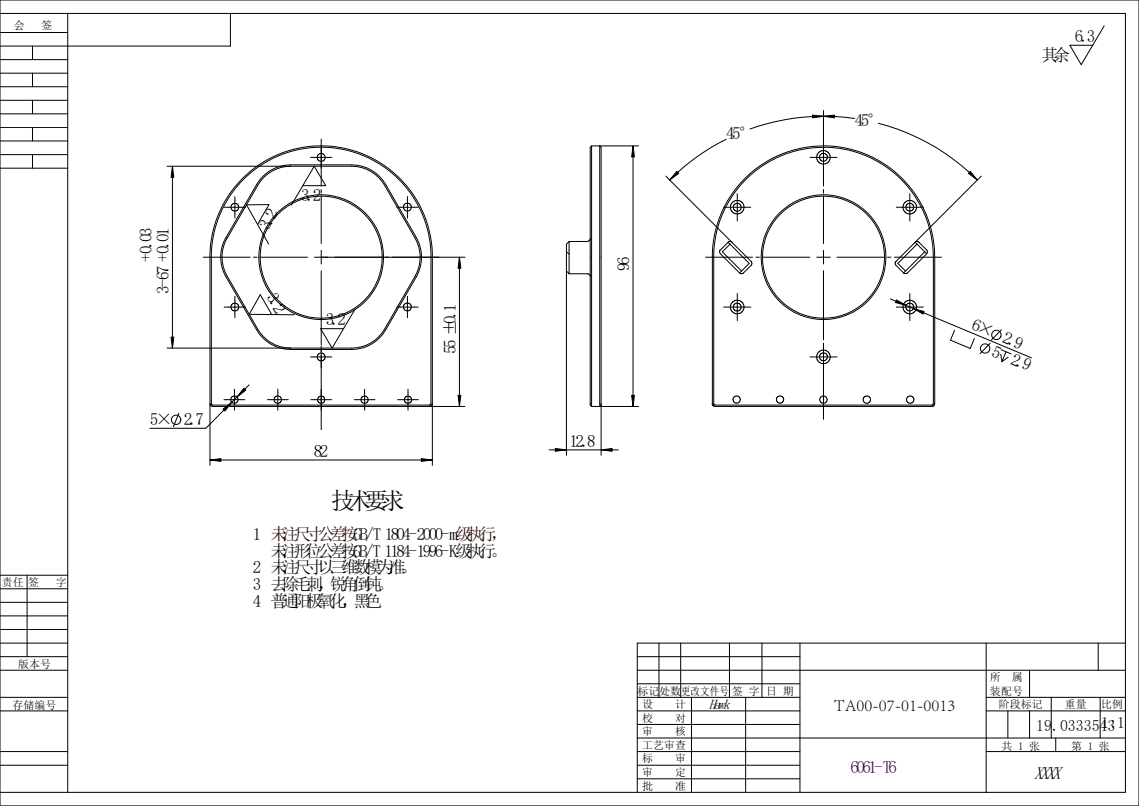
[picture p93: page 1]
阶段标记; 存储编号; 版本号; Hawk; 未注尺寸公差按; 级执行，; 4 普通阳极氧化，黑色; 技术要求

3 去除毛刺，锐角倒钝。 2 未注尺寸以三维数模为准。 未注形位公差按GB/T 1184-1996-K级执行。 GB/T 1804-2000-m

TA00-07-01-0013 | 所 属 装配号

标记处数更改文件号 签 字 | 日 期
校 对 | | | | 19.0333543 | 1:1
审 核
工艺审查 | 6061-T6 | 共 1 张 | 第 1 张
标 审 | | XXXX
审 定
批 准
