loongOpen/OpenLoong-Hardware/QingLoong V2.5/en/QingLoong V2.5 - 2D Drawing/TA00-12-00-Leg and Foot System - 2D Drawing/TA00-12-00-0001 Knee Joint Pin.pdf

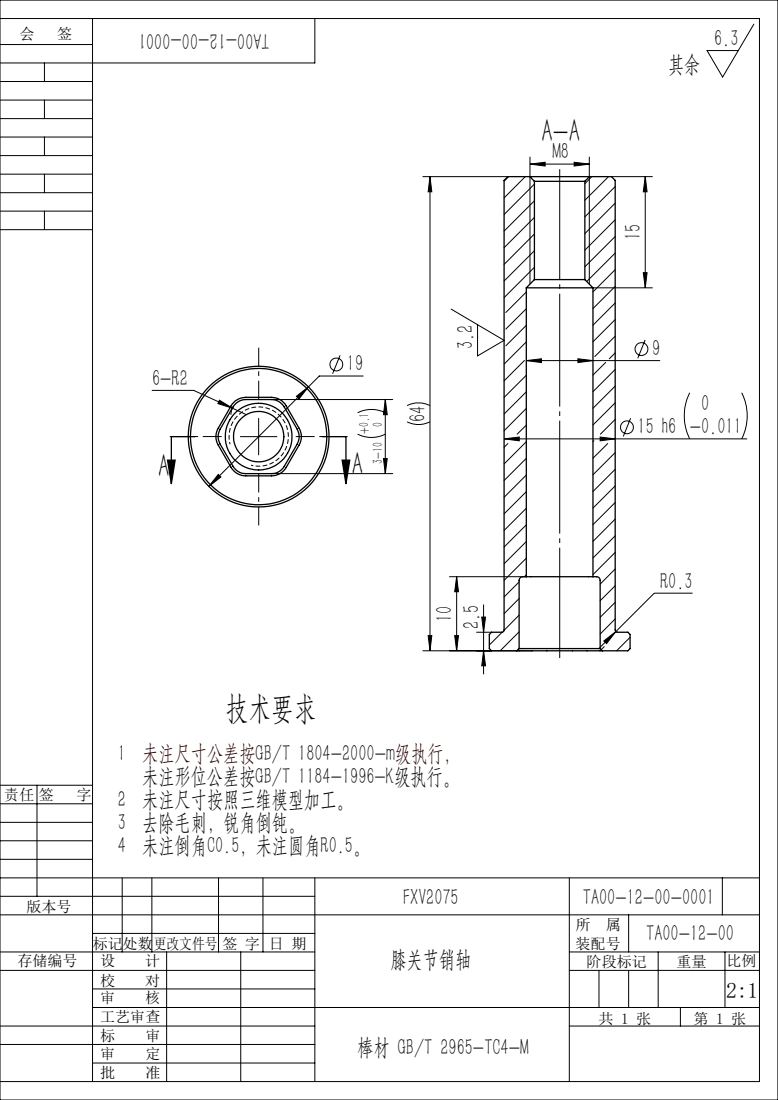
[picture p96: page 1]
2 未注尺寸按照三维模型加工。 3 去除毛刺，锐角倒钝。 4 未注倒角C0.5，未注圆角R0.5。

1 未注尺寸公差按GB/T 1804-2000-m级执行， 未注形位公差按GB/T 1184-1996-K级执行。

FXV2075 | TA00-12-00-0001

版本号

膝关节销轴 | 所 属 装配号 | TA00-12-00

标记处数更改文件号 | | 签 字 | 日 期

存储编号 | 设 计 | | | 阶段标记 | 重量 | 比例

校 对 | | | | | | 2:1
审 核
工艺审查 | | 棒材 GB/T 2965-TC4-M | 共 1 张 | 第 1 张
标 审
审 定
批 准
