loongOpen/OpenLoong-Hardware/QingLoong V2.5/en/QingLoong V2.5 - 2D Drawing/TA00-12-00-Leg and Foot System - 2D Drawing/TA00-12-00-0004 Link Bushing B.pdf

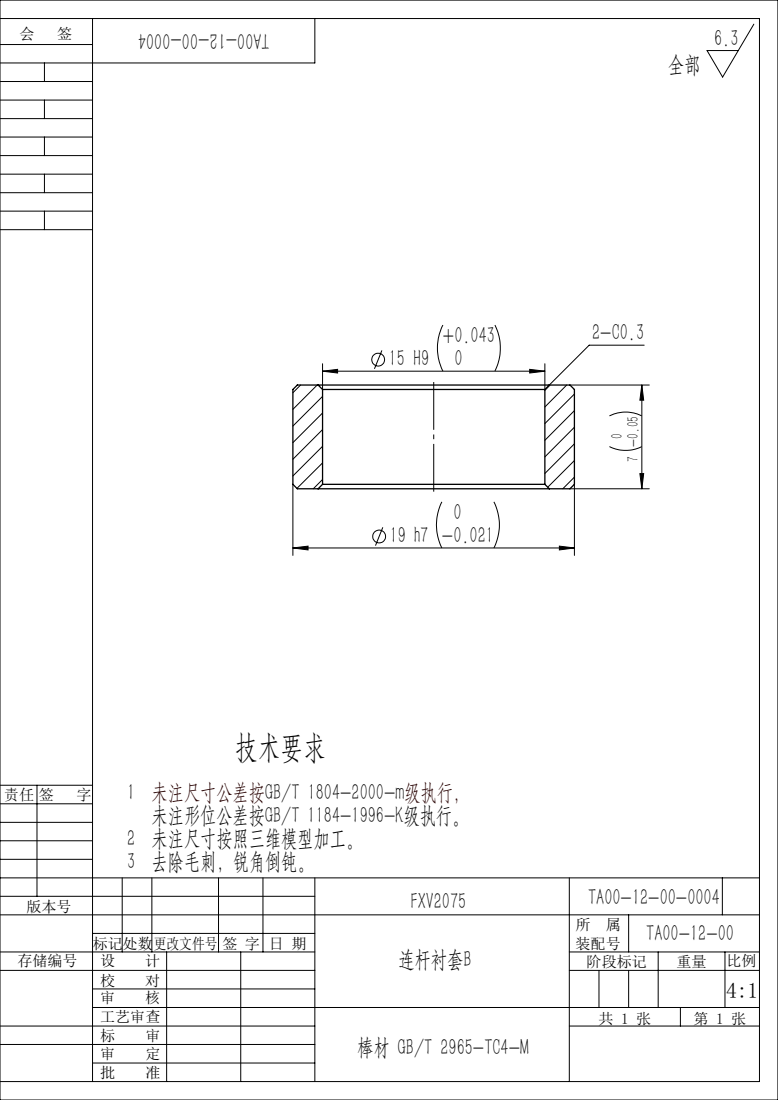
[picture p98: page 1]
2 未注尺寸按照三维模型加工。 3 去除毛刺，锐角倒钝。

1 未注尺寸公差按GB/T 1804-2000-m级执行， 未注形位公差按GB/T 1184-1996-K级执行。

FXV2075 | TA00-12-00-0004

版本号

连杆衬套B | 所 属 装配号 | TA00-12-00

标记处数更改文件号 | | 签 字 | 日 期

存储编号 | 设 计 | | | 阶段标记 | 重量 | 比例

校 对 | | | | | | 4:1
审 核
工艺审查 | | 棒材 GB/T 2965-TC4-M | 共 1 张 | 第 1 张
标 审
审 定
批 准
