loongOpen/OpenLoong-Hardware/QingLoong V2.5/en/QingLoong V2.5 - 2D Drawing/TA00-12-00-Leg and Foot System - 2D Drawing/TA00-12-01-0001-A1 Hip Joint Turnover Motor Connector.pdf

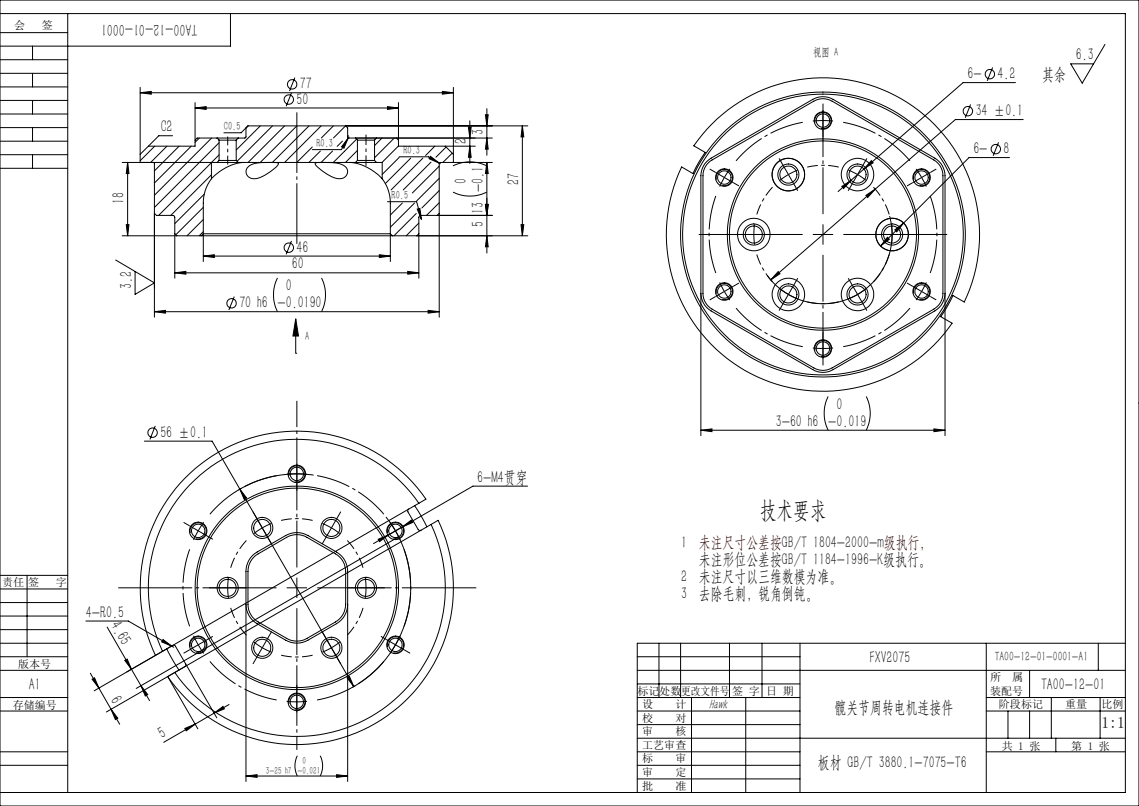
[picture p103: page 1]
标记处数更改文件号 签 字; 2 未注尺寸以三维数模为准。 3 去除毛刺，锐角倒钝。

1 未注尺寸公差按GB/T 1804-2000-m级执行， 未注形位公差按GB/T 1184-1996-K级执行。

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
