loongOpen/OpenLoong-Hardware/QingLoong V2.5/en/QingLoong V2.5 - 2D Drawing/TA00-12-00-Leg and Foot System - 2D Drawing/TA00-12-01-0003-A1 Turnover Motor Bearing Stopper.pdf

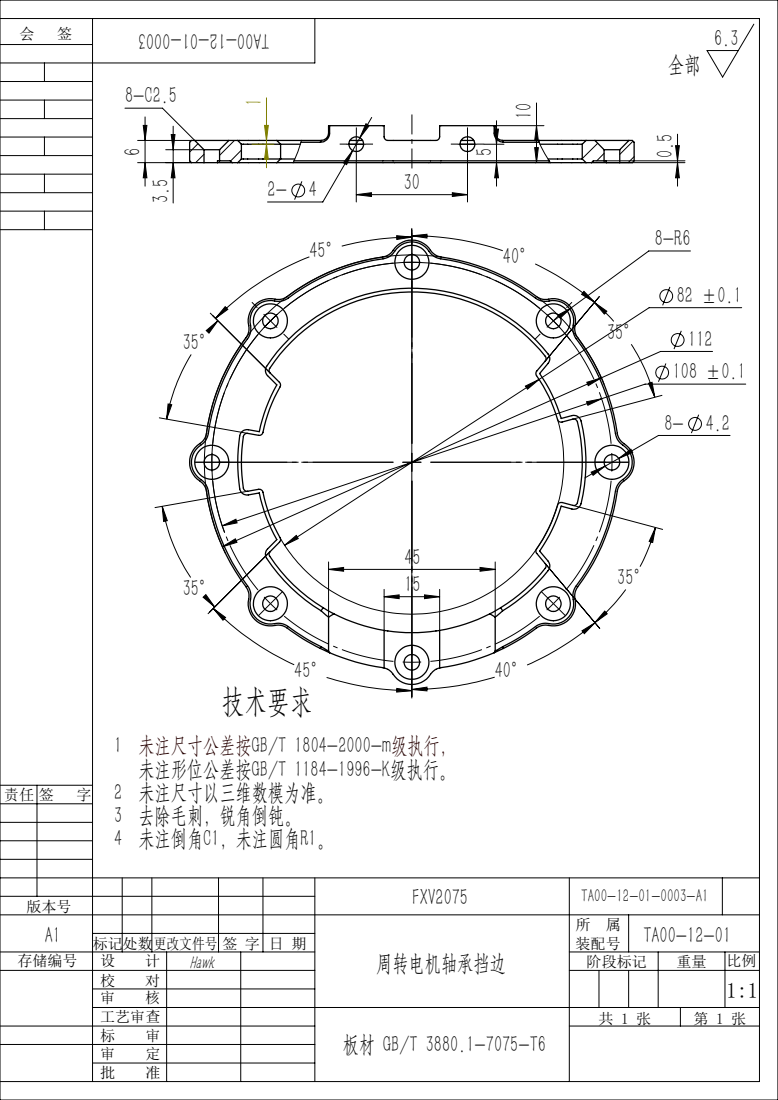
[picture p104: page 1]
2 未注尺寸以三维数模为准。 3 去除毛刺，锐角倒钝。 4 未注倒角C1，未注圆角R1。

1 未注尺寸公差按GB/T 1804-2000-m级执行， 未注形位公差按GB/T 1184-1996-K级执行。

FXV2075 | TA00-12-01-0003-A1

版本号
A1 | 周转电机轴承挡边 | 所 属 装配号 | TA00-12-01

标记处数更改文件号 | | | 签 字 | 日 期

存储编号 | 设 计 | Hawk | | | 阶段标记 | 重量 | 比例

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
