loongOpen/OpenLoong-Hardware/QingLoong V2.5/en/QingLoong V2.5 - 2D Drawing/TA00-12-00-Leg and Foot System - 2D Drawing/TA00-12-01-0004 Front Swing Alignment Part.pdf

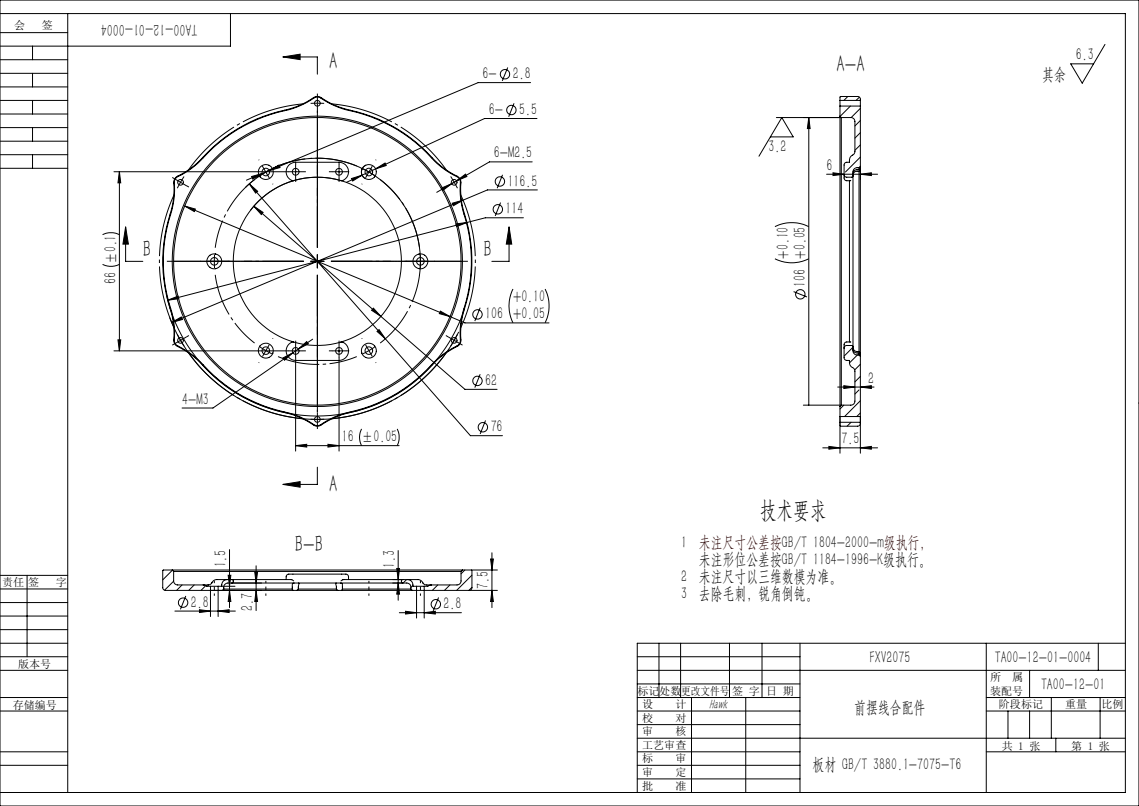
[picture p105: page 1]
2 未注尺寸以三维数模为准。 3 去除毛刺，锐角倒钝。

1 未注尺寸公差按GB/T 1804-2000-m级执行， 未注形位公差按GB/T 1184-1996-K级执行。

FXV2075 | TA00-12-01-0004

前摆线合配件 | 所 属 装配号 | TA00-12-01

标记处数更改文件号 签 字 | 日 期

校 对
审 核
工艺审查 | 板材 GB/T 3880.1-7075-T6 | 共 1 张 | 第 1 张
标 审
审 定
批 准
