loongOpen/OpenLoong-Hardware/QingLoong V2.5/en/QingLoong V2.5 - 2D Drawing/TA00-12-00-Leg and Foot System - 2D Drawing/TA00-12-02-0001-A1 Hip Joint Pitch Motor Flange.pdf

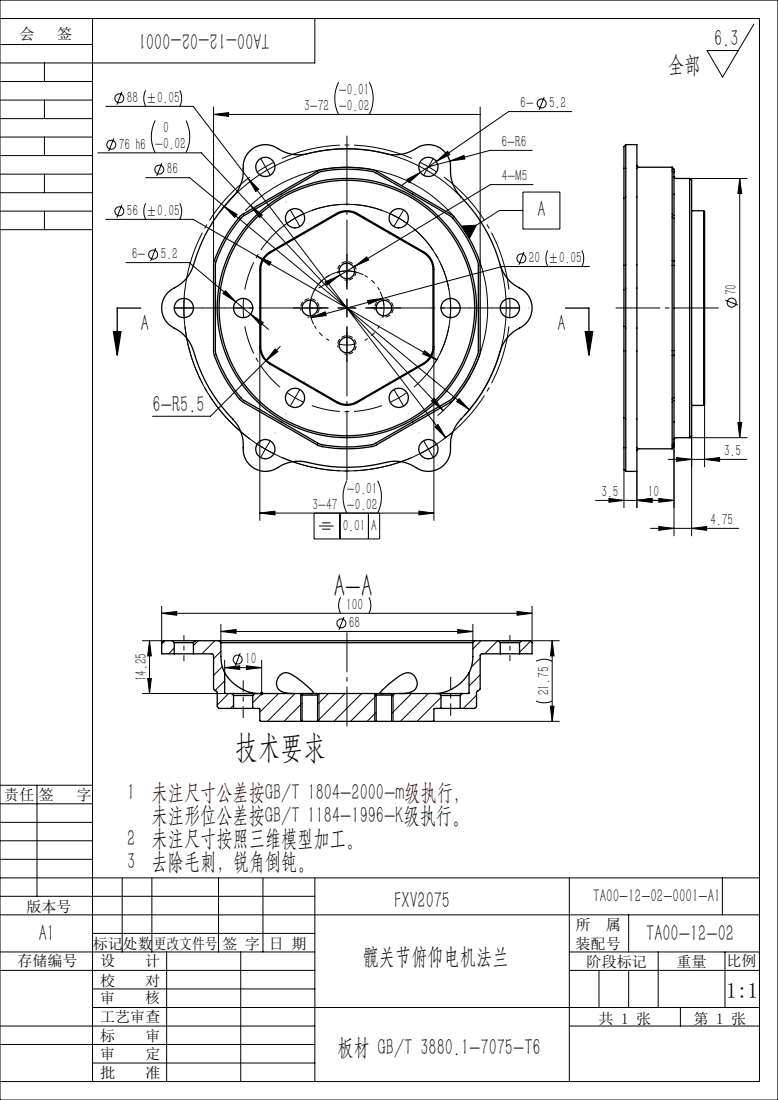
[picture p106: page 1]
2 未注尺寸按照三维模型加工。 3 去除毛刺，锐角倒钝。

1 未注尺寸公差按GB/T 1804-2000-m级执行， 未注形位公差按GB/T 1184-1996-K级执行。

FXV2075 | TA00-12-02-0001-A1

版本号
髋关节俯仰电机法兰 | 所 属 装配号 A1 | TA00-12-02

标记处数更改文件号 | | 签 字 | 日 期

存储编号 | 设 计 | | | 阶段标记 | 重量 | 比例

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
