loongOpen/OpenLoong-Hardware/QingLoong V2.5/en/QingLoong V2.5 - 2D Drawing/TA00-12-00-Leg and Foot System - 2D Drawing/TA00-12-02-0004 Knee Joint Motor Joint Shaft.pdf

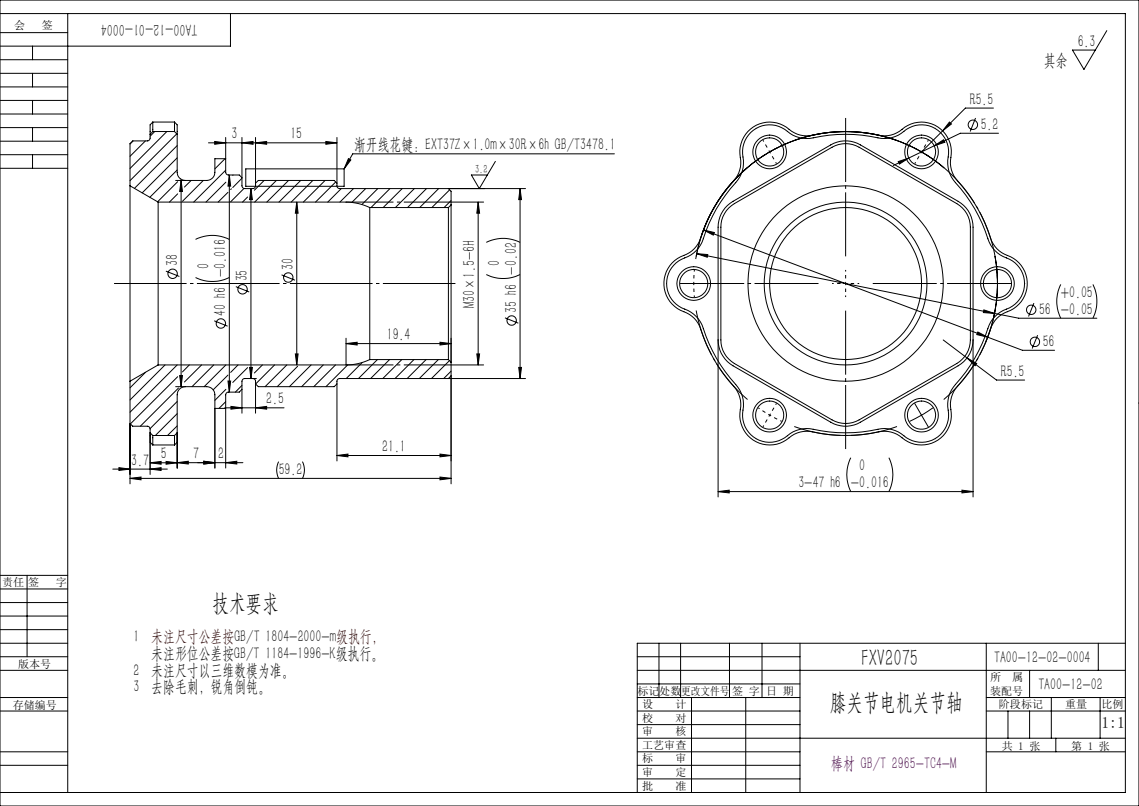
[picture p107: page 1]
渐开线花键：EXT37Z×1.0m×30R×6h GB/T3478.1; 2 未注尺寸以三维数模为准。 3 去除毛刺，锐角倒钝。

1 未注尺寸公差按GB/T 1804-2000-m级执行， 未注形位公差按GB/T 1184-1996-K级执行。

FXV2075 | TA00-12-02-0004

膝关节电机关节轴 | 所 属 装配号 | TA00-12-02

标记处数更改文件号 签 字 | 日 期

校 对 | | | | 1:1
审 核
工艺审查 | 棒材 GB/T 2965-TC4-M | 共 1 张 | 第 1 张
标 审
审 定
批 准
