loongOpen/OpenLoong-Hardware/QingLoong V2.5/en/QingLoong V2.5 - 2D Drawing/TA00-12-00-Leg and Foot System - 2D Drawing/TA00-12-02-0006 -A1 Bearing Steel Sleeve.pdf

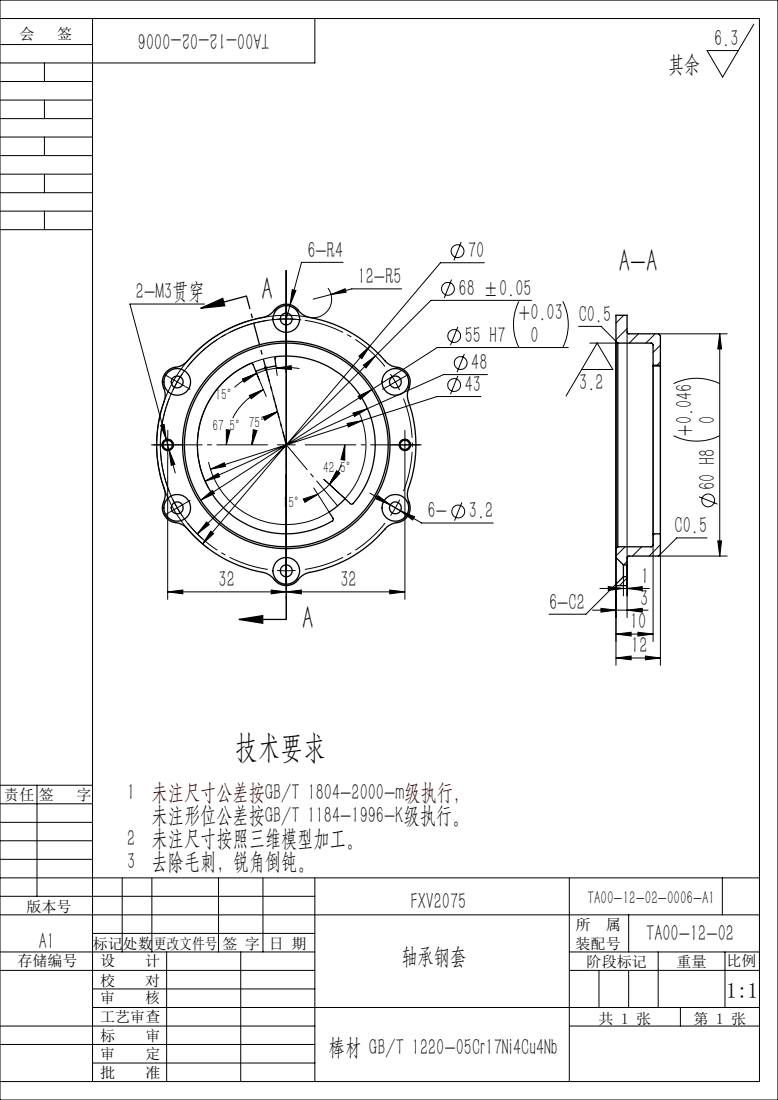
[picture p108: page 1]
2 未注尺寸按照三维模型加工。 3 去除毛刺，锐角倒钝。

1 未注尺寸公差按GB/T 1804-2000-m级执行， 未注形位公差按GB/T 1184-1996-K级执行。

FXV2075 | TA00-12-02-0006-A1

版本号

所 属 装配号 | TA00-12-02

标记处数更改文件号 | | 签 字 | 日 期 | 轴承钢套 A1
存储编号 | 设 计 | | | 阶段标记 | 重量 | 比例

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
