loongOpen/OpenLoong-Hardware/QingLoong V2.5/en/QingLoong V2.5 - 2D Drawing/TA00-12-00-Leg and Foot System - 2D Drawing/TA00-12-02-0007-A1 Rocking Arm.pdf

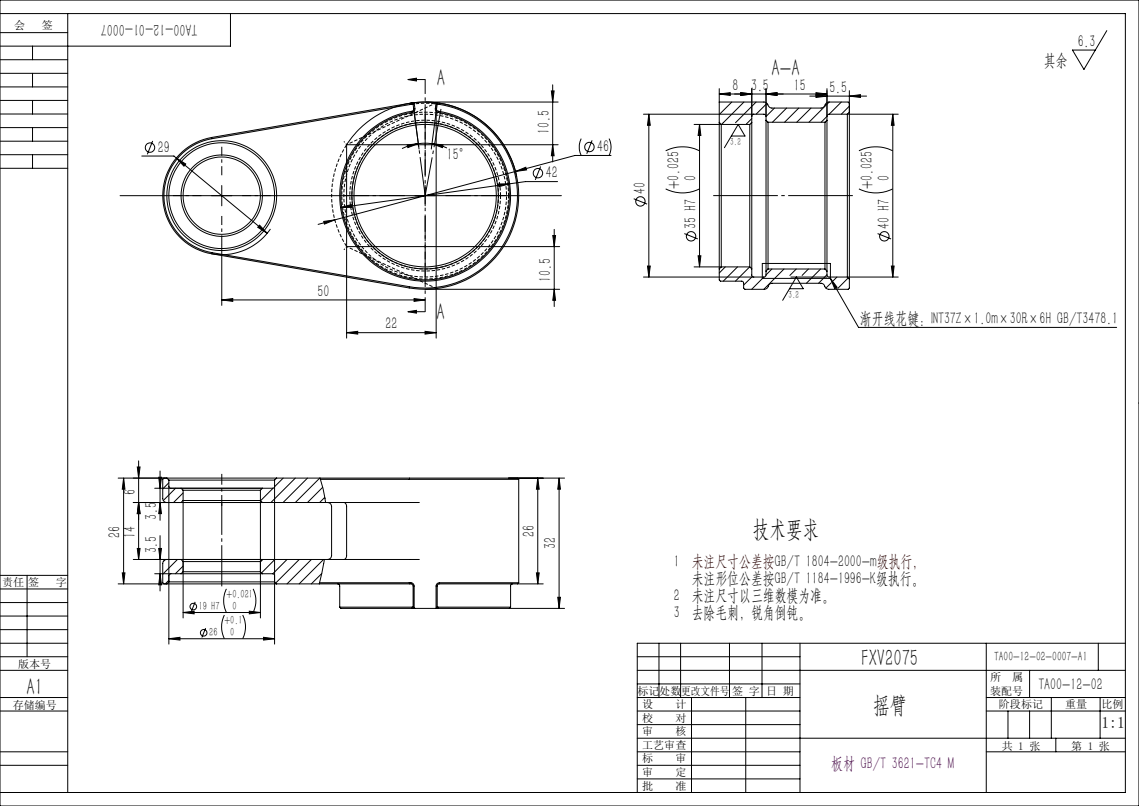
[picture p109: page 1]
渐开线花键：INT37Z×1.0m×30R×6H GB/T3478.1; 2 未注尺寸以三维数模为准。 3 去除毛刺，锐角倒钝。; 标记处数更改文件号 签 字

1 未注尺寸公差按GB/T 1804-2000-m级执行， 未注形位公差按GB/T 1184-1996-K级执行。

校 对 | | | | 1:1
审 核
工艺审查 | 板材 GB/T 3621-TC4 M | 共 1 张 | 第 1 张
标 审
审 定
批 准
