loongOpen/OpenLoong-Hardware/QingLoong V2.5/en/QingLoong V2.5 - 2D Drawing/TA00-12-00-Leg and Foot System - 2D Drawing/TA00-12-06-0001 Foot Body.pdf

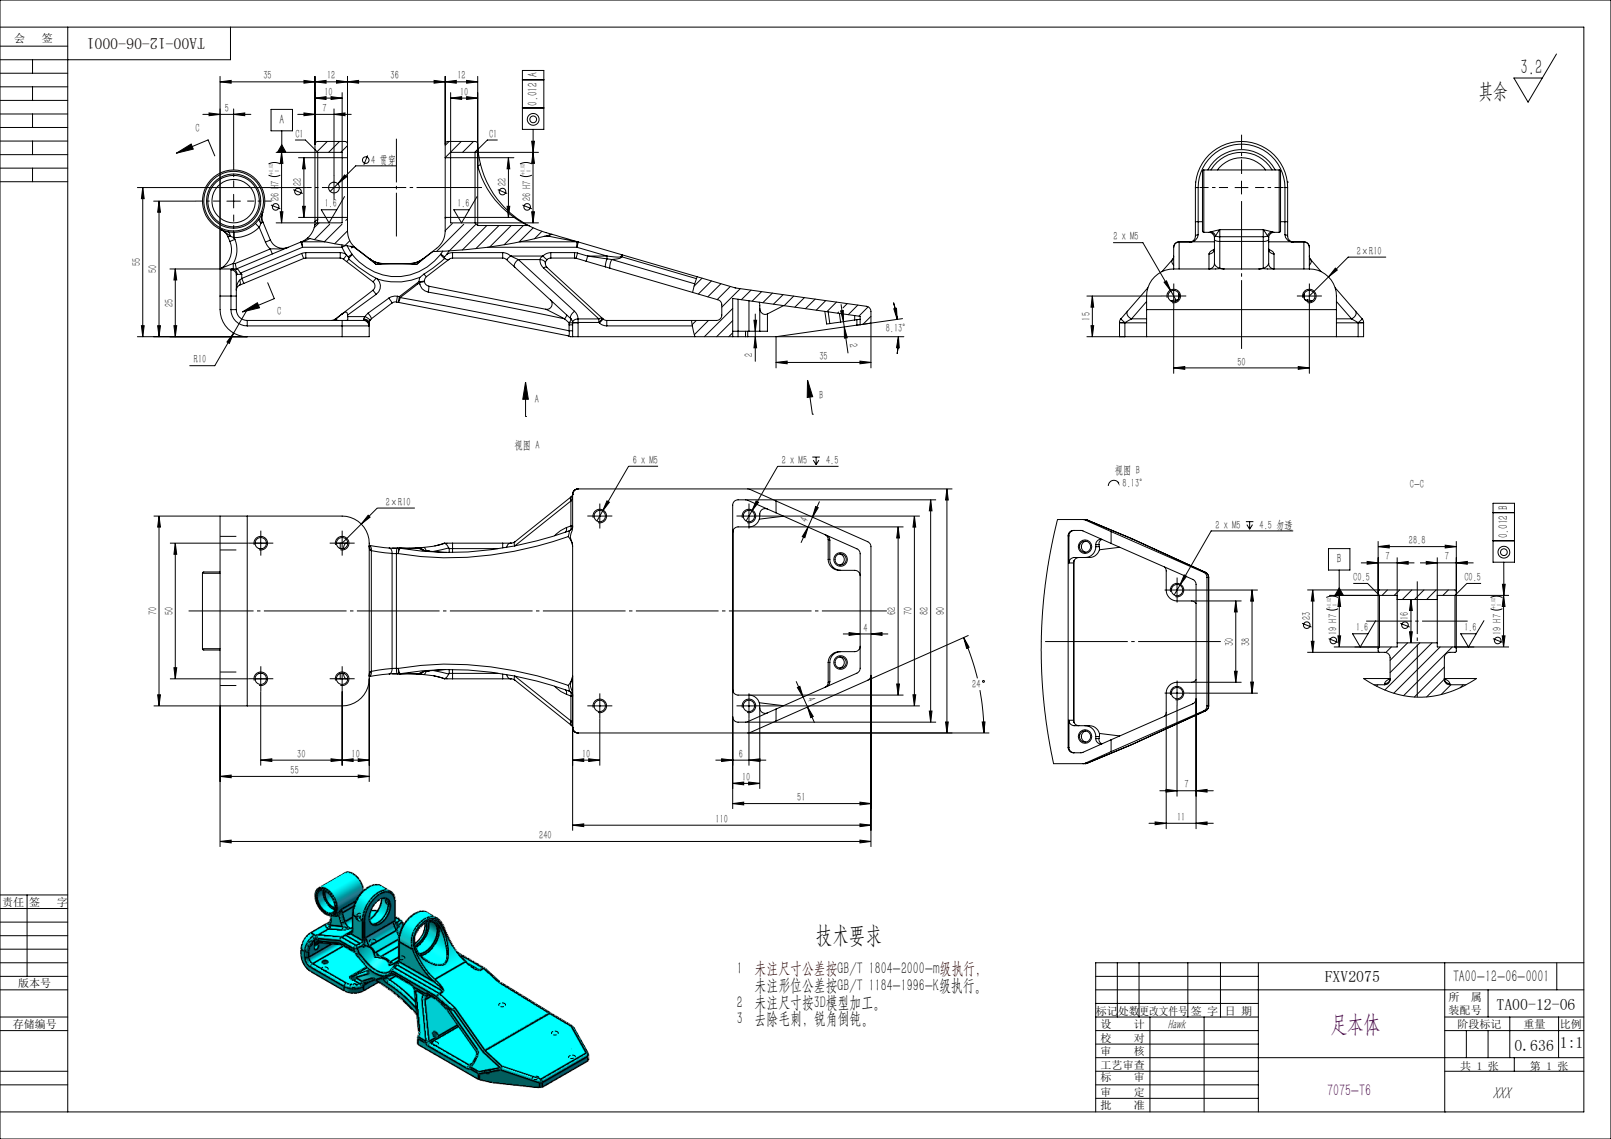
[picture p112: page 1]
2 未注尺寸按3D模型加工。 3 去除毛刺，锐角倒钝。

1 未注尺寸公差按GB/T 1804-2000-m级执行， 未注形位公差按GB/T 1184-1996-K级执行。

FXV2075 | TA00-12-06-0001
足本体 | 所 属 装配号 | TA00-12-06

标记处数更改文件号 签 字 | 日 期
校 对 | | | | 0.636 | 1:1
审 核
工艺审查 | 7075-T6 | 共 1 张 | 第 1 张
标 审 | | XXX
审 定
批 准
