loongOpen/OpenLoong-Hardware/(commit log)

2025-05-30 上传公版机电路电气原理图PDF
2025-06-03 Delete 电路电气原理图.pdf
    文件需重新上传
2025-06-24 上传了腿足系统的三维图纸
    [TA00-12-00-0001膝关节销轴.step, TA00-12-00-0002膝关节销轴锁紧螺钉.step, TA00-12-00-0003连杆销针C.step, TA00-12-00-0004连杆衬套B.step, TA00-12-00-0006脚踝俯仰轴.step, TA00-12-00-0007脚踝俯仰轴 B.step, TA00-12-00-0011脚踝俯仰轴垫片.step, TA00-12-00-0013十字俯仰轴.step]
2025-09-05 Add QingLoong V2.5 3D Files
    [1. TA00-12-00-0007 Ankle Pitch Axis B.step, 1. TA00-12-00-0013 Cross Pitch Axis.step, TA00-03 Waist Bracket Assembly.STEP, TA00-03-0001-Waist Bracket1.STEP, TA00-03-0002-Front Blind-Spot Camera Bracket1.STEP, TA00-03-0003-Front Camera Adapter Block1.STEP, TA00-03-0004-Waist Rotation Bearing Retaining Ring1.STEP, TA00-03-0005-Waist Rotation Motor Shaft1.STEP]
2025-09-05 上传青龙V2.5 2D图纸
2025-09-05 上传青龙V2.5 3D文档
    [TA00-03-0001-腰部支架1.STEP, TA00-03-0002-前部补盲相机支架1.STEP, TA00-03-0003-前部相机转接块1.STEP, TA00-03-0004-腰部周转轴承挡圈1.STEP, TA00-03-0005-腰部周转电机轴1.STEP, TA00-03-0006-侧摆电机支架1.STEP, TA00-03-0007-前摆电机支架1.STEP, TA00-03-0008-腰部侧摆支撑转轴1.STEP]
2025-09-05 change EN to en
    [1. TA00-12-00-0007 Ankle Pitch Axis B.step, 1. TA00-12-00-0013 Cross Pitch Axis.step, TA00-03 Waist Bracket Assembly.STEP, TA00-03-0001-Waist Bracket1.STEP, TA00-03-0002-Front Blind-Spot Camera Bracket1.STEP, TA00-03-0003-Front Camera Adapter Block1.STEP, TA00-03-0004-Waist Rotation Bearing Retaining Ring1.STEP, TA00-03-0005-Waist Rotation Motor Shaft1.STEP]
